andrewrichardr/MSE2202BDesignProject/README.md

# TronDesign
MSE2202B Mechatronic Design Repo
