andrewrichardr/MSE2202BDesignProject/Project/Documentation/MSE2202B Design Project-20180412T013709Z-001/MSE2202B Design Project/Concepts/Arm Attachments.docx

Suction cup option for lifting the pyramid:

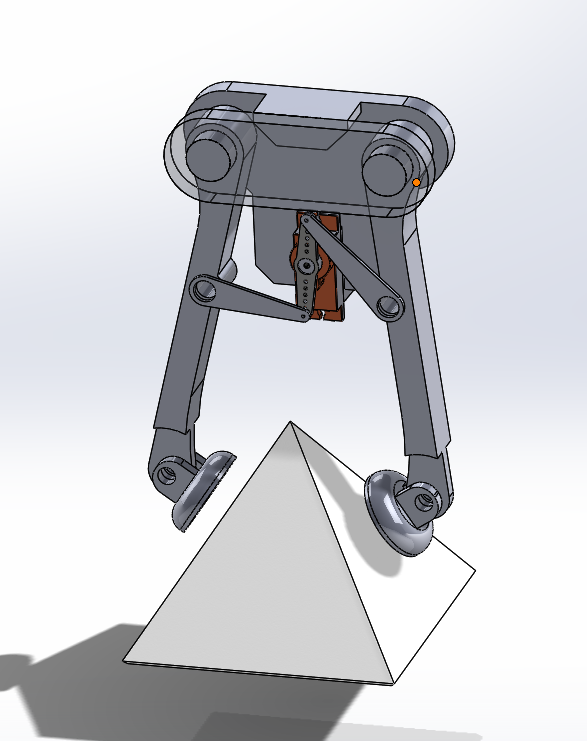
[picture p20: figure]

Geartrain for amplifying clamping force. Arm links attached to holes in output gear.

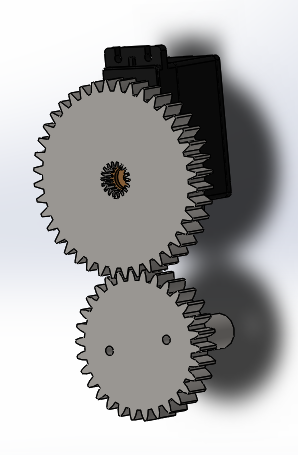
[picture p21: figure]
