andrewrichardr/MSE2202BDesignProject/Project/Documentation/MSE2202B Design Project-20180412T013709Z-001/MSE2202B Design Project/Stuff for PDF/Some Research.docx

## Objectives

- Research different types of drives and write out ones that we will consider.
- Design each drivetrain in CAD software in order efficiently see pros, cons and successfully test each of them.

## Meeting

Research: (source: Simple Robotics)

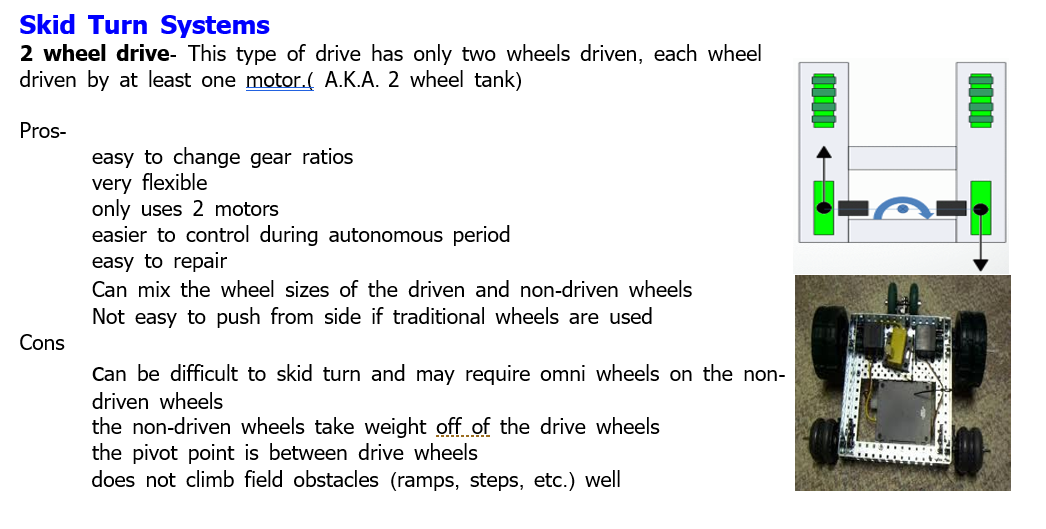
[picture p45: figure]
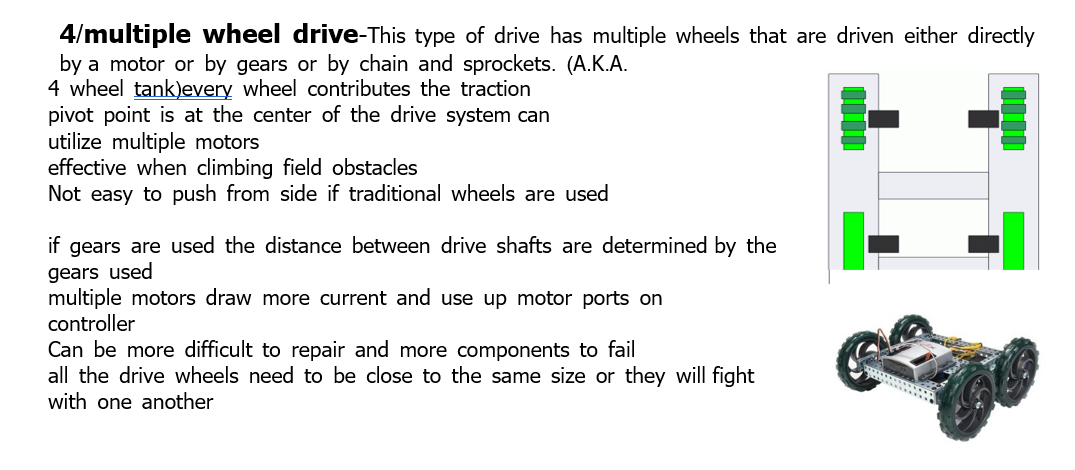
[picture p46: figure]
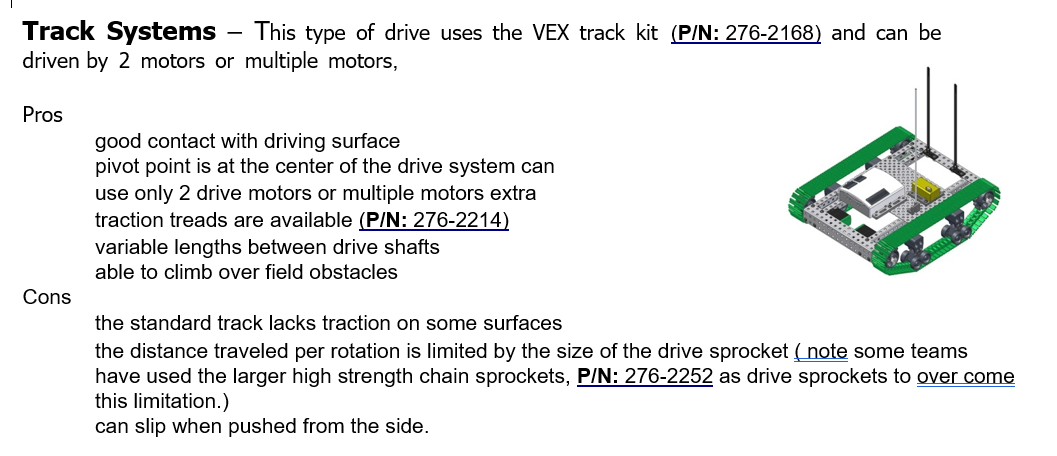
[picture p47: figure]
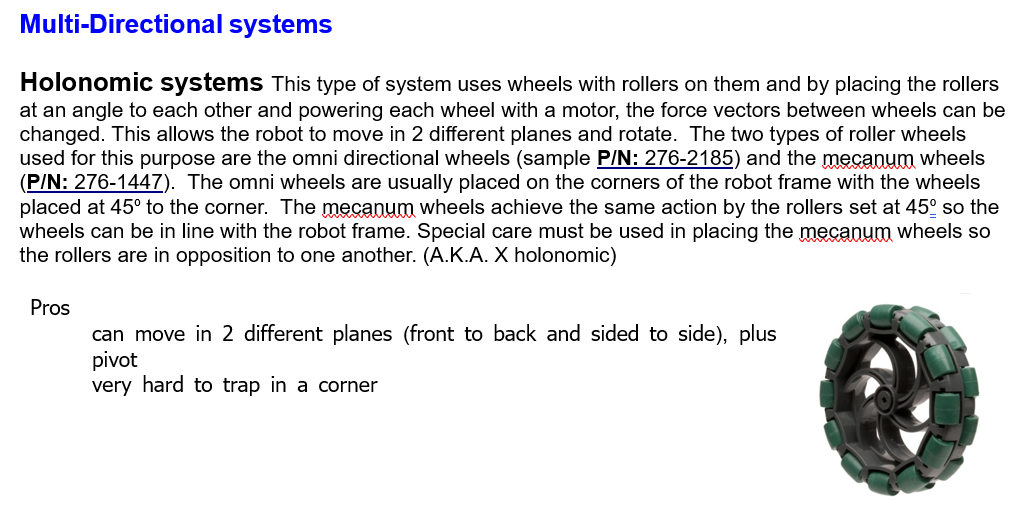
[picture p48: figure]
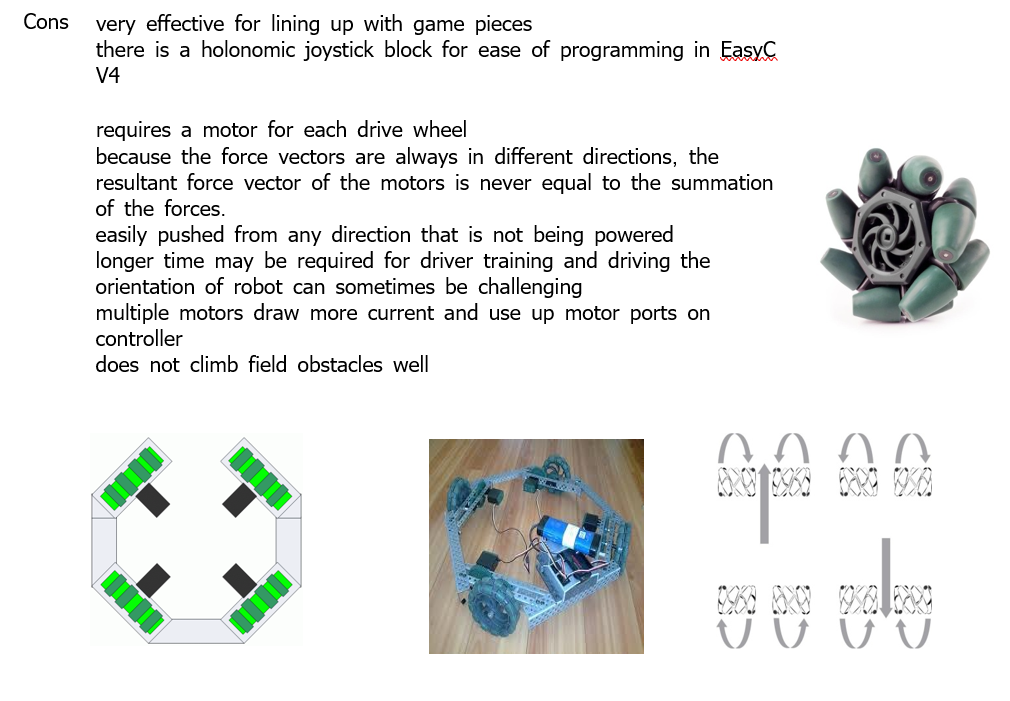
[picture p49: figure]
