andrewrichardr/MSE2202BDesignProject/Project/Documentation/MSE2202B Design Project-20180412T013709Z-001/MSE2202B Design Project/PDF/Minutes_/Meeting-Minutes5.docx

Meeting Minutes #5

Date: March 16, 2018

Agenda:

- Finalize sensors required for the product
- Select the sensors that are being used on the prototype

Discussion:

1. Sensors Required for the Product
2. Prototype Design (Sensors)

To be completed:
