andrewrichardr/MSE2202BDesignProject/Project/Documentation/MSE2202B Design Project-20180412T013709Z-001/MSE2202B Design Project/Docs/BlockDiagram.pdf

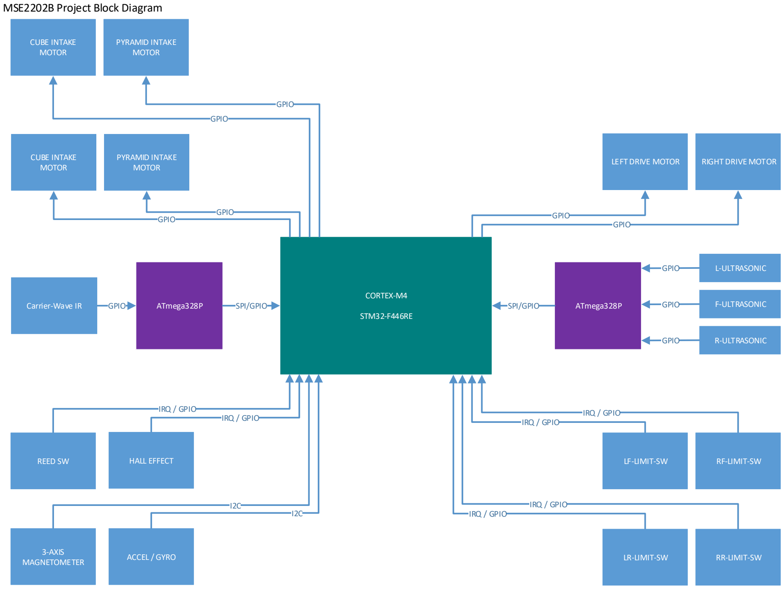
[picture p50: figure]
CORTEX-M4; STM32-F446RE; ATmega328P; L-ULTRASONIC; R-ULTRASONIC; LEFT DRIVE MOTOR; RIGHT DRIVE MOTOR; LF-LIMIT-SW; RF-LIMIT-SW; LR-LIMIT-SW; RR-LIMIT-SW; IRQ / GPIO; PYRAMID INTAKE MOTOR; CUBE INTAKE MOTOR; GPIO; Carrier-Wave IR; SPI/GPIO; REED SW; HALL EFFECT; 3-AXIS; MAGNETOMETER; ACCEL / GYRO; F-ULTRASONIC; MSE2202B Project Block Diagram
