andrewrichardr/MSE2202BDesignProject/Project/Documentation/MSE2202B Design Project-20180412T013709Z-001/MSE2202B Design Project/Stuff for PDF/BlockDiagram-Used.pdf

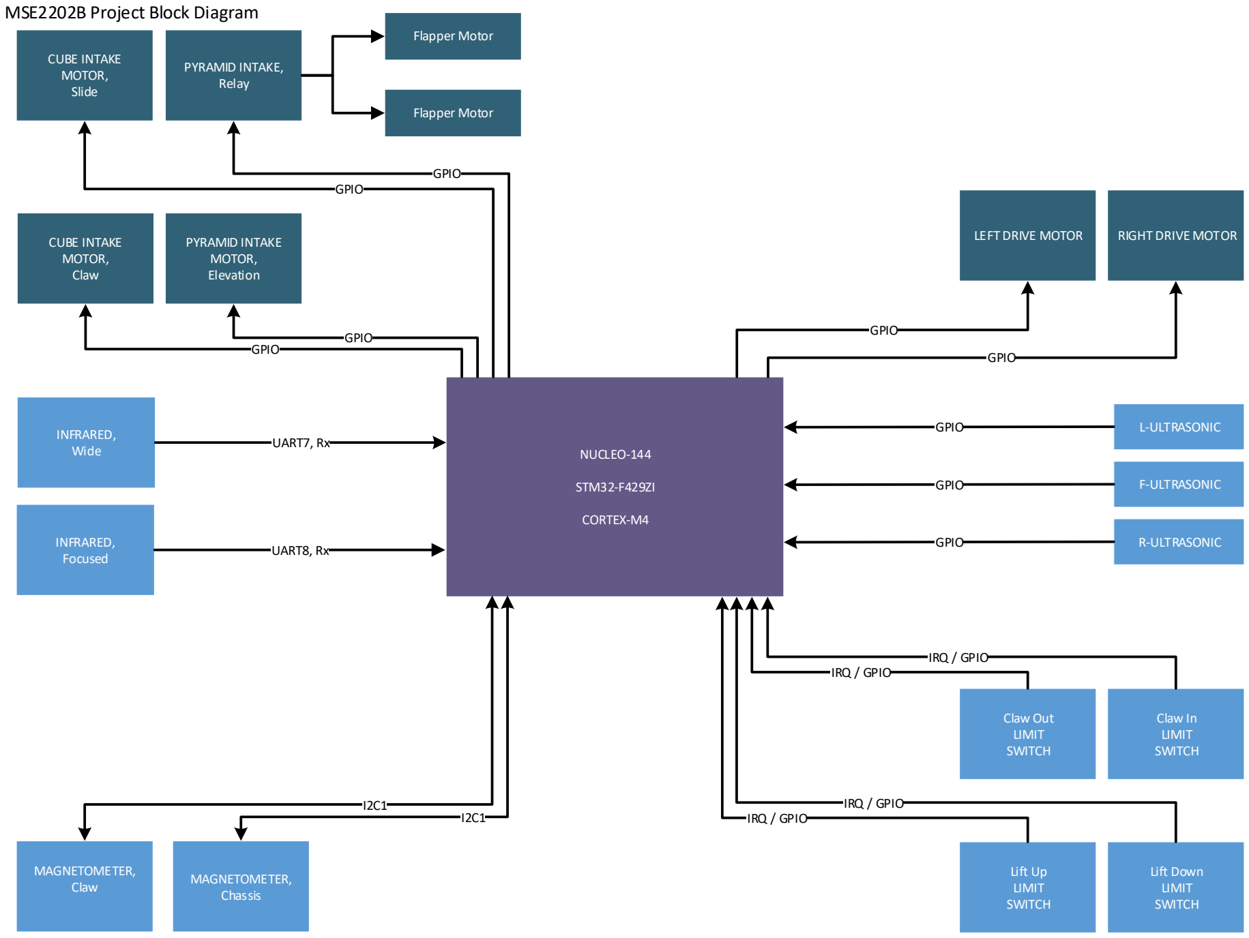
[picture p51: figure]
NUCLEO-144; STM32-F429ZI; CORTEX-M4; L-ULTRASONIC; R-ULTRASONIC; LEFT DRIVE MOTOR; RIGHT DRIVE MOTOR; Claw In LIMIT SWITCH; Claw Out LIMIT SWITCH; Lift Down LIMIT SWITCH; Lift Up LIMIT SWITCH; IRQ / GPIO; PYRAMID INTAKE MOTOR, Elevation; CUBE INTAKE MOTOR, Claw; GPIO; MAGNETOMETER,; Claw; Chassis; PYRAMID INTAKE, Relay; CUBE INTAKE MOTOR, Slide; F-ULTRASONIC; MSE2202B Project Block Diagram; INFRARED,; Focused; UART8, Rx; Wide; UART7, Rx; Flapper Motor
