andrewrichardr/MSE2202BDesignProject/Project/Documentation/MSE2202B Design Project-20180412T013709Z-001/MSE2202B Design Project/Sheets/Misc Questions to be Answered Before End of Reading Week.xlsx

Question | Approach | Who's finding the answer? | Status
How precise is pyramid hole size compared to cube? | Eugen | Maral
Angle of pyramid | Eugen | Maral
How much of our bot can be laser cut / 3d printed (within budget?) | Eugen? | Maral
How do we use suction cups with arduino? | Google
Friction coefficients with lexan? | Google
Hall effect sensors | Google
Photosensitive (IR) sensors | Google
Ultrasonic sensors | Google
Can we use outsourced motors | Naish | Lovdeep
What are the specs on the VEX sensors Naish has for us | Owl?
