andrewrichardr/MSE2202BDesignProject/Project/Documentation/MSE2202B Design Project-20180412T013709Z-001/MSE2202B Design Project/Sheets/Work Plan.xlsx

Week Of | 2018-02-15 | 2018-02-22 | 2018-03-01 | 2018-03-08 | 2018-03-15 | 2018-03-22 | 2018-03-29 | 2018-04-05 | 2018-04-11
Deliverables | Stuff to do for reading week, general direction discussion | Prelim ideas, CAD of arm concepts, research | First design review ready, tasks assigned for prototype | Work on prototype build, most parts sourced | Work on prototype build and coding | Second design review ready, prototype complete | Final parts laser cut or otherwise created | Robot complete | Report complete
