andrewrichardr/MSE2202BDesignProject/Project/Documentation/MSE2202B Design Project-20180412T013709Z-001/MSE2202B Design Project/Stuff for PDF/commits.local.tsv.xlsx

0c05f09 | andrew | Thu Apr 5 23:27:09 2018 | kjdfsgkjfsdjgksdg
f93f6d5 | andrew | Thu Apr 5 16:10:31 2018 | progress
857764f | andrew | Thu Apr 5 13:26:21 2018 | progress
9f50521 | andrew | Thu Apr 5 12:35:21 2018 | progress
1a348d5 | andrew | Thu Apr 5 11:50:04 2018 | progress
216fab5 | andrew | Thu Apr 5 11:49:30 2018 | Merge branch 'master' of https://github.com/andrewrichardr/TronDesign
f4bccac | andrew | Thu Apr 5 02:11:58 2018 | progress
cfc50ed | andrew | Wed Apr 4 14:30:25 2018 | progress
0d3759e | Andrew | Tue Apr 3 13:03:15 2018 | CAD
3305b64 | andrew | Mon Apr 2 17:50:36 2018 | Fans code: Added functions and vars for arm and lift positions, cleaned up repo
840a582 | andrew | Mon Apr 2 14:13:20 2018 | Merge branch 'master' of https://github.com/andrewrichardr/TronDesign
b902541 | andrew | Mon Apr 2 14:13:07 2018 | Block Diag Updated
aeaa023 | Andrew | Mon Apr 2 10:20:49 2018 | Merge branch 'master' of https://github.com/andrewrichardr/TronDesign
3728871 | lsingh360 | Sun Apr 1 21:19:21 2018 | should fix Solidworks opening issues
cb65c19 | lsingh360 | Sun Apr 1 14:49:28 2018 | adds new Lift and Claw CAD parts
d05d52c | Andrew | Sat Mar 31 23:35:08 2018 | Added PID controlled wall follower code to test
1bfd52b | andrew | Sat Mar 31 22:48:52 2018 | testing mods
9e09ae1 | Andrew | Thu Mar 29 01:07:22 2018 | Main Code work progressed
05e9f75 | Andrew | Wed Mar 28 22:41:58 2018 | CAD and Sensor Test Code
9ccc10d | andrew | Wed Mar 28 22:36:40 2018 | Drive Test code iterative update
47a6324 | andrew | Mon Mar 26 13:42:12 2018 | fan demo
4926e1e | Andrew | Sun Mar 25 01:08:24 2018 | FAN's code added back
f2e0bf4 | Andrew | Sun Mar 25 00:50:15 2018 | NUCLEO-32 Ultrasonic Controller Code added
6adffbe | Andrew | Sun Mar 25 00:34:29 2018 | Repo Cleanup
dd9c7f8 | fkang3 | Sat Mar 24 20:06:49 2018 | logic for putting pyramid over cube
22bdd69 | Andrew | Sat Mar 24 12:49:46 2018 | formatting
a60942a | Andrew | Sat Mar 24 12:40:13 2018 | Merge branch 'master' of https://github.com/andrewrichardr/TronDesign
e01173d | Andrew | Sat Mar 24 12:39:00 2018 | struct
fdf9130 | fkang3 | Sat Mar 24 12:33:43 2018 | small fix
8e87934 | fkang3 | Sat Mar 24 12:28:09 2018 | cube pickup..
43d4a9d | fkang3 | Sat Mar 24 12:25:13 2018 | cube pickup
d350e56 | Andrew | Sat Mar 24 12:17:16 2018 | minor changes
bfef8ef | Andrew | Fri Mar 23 18:54:39 2018 | main code\
71e2fe7 | andrew | Fri Mar 23 15:49:22 2018 | syntax error corrected
639ac36 | andrew | Fri Mar 23 15:00:53 2018 | class
57c4847 | andrew | Fri Mar 23 13:18:17 2018 | Main Robot Class added
07324b2 | Andrew | Fri Mar 23 00:27:33 2018 | Final Design CAD added and Chassis started
304d603 | fkang3 | Thu Mar 22 16:07:09 2018 | Updated with drive code
dff8c5f | andrew | Thu Mar 22 15:46:08 2018 | Merge branch 'master' of https://github.com/andrewrichardr/TronDesign
c1d5504 | fkang3 | Thu Mar 22 15:37:50 2018 | IR sensor retrieval added
1f84d18 | andrew | Thu Mar 22 14:17:35 2018 | DriveCode update
a6f86e3 | Andrew | Thu Mar 22 10:20:38 2018 | CAD render + Updates
9cd1dcf | Andrew | Tue Mar 20 23:56:27 2018 | Added 3rd party libraries for compass / accel
d74950f | andrew | Tue Mar 20 22:57:49 2018 | Test Drive code modified
0207c15 | mmohagh7 | Tue Mar 20 18:38:22 2018 | Add files via upload
faff789 | Andrew | Tue Mar 20 17:57:24 2018 | CAD
5949716 | Andrew | Tue Mar 20 17:37:09 2018 | Product CAD update
7d2c52a | Andrew | Tue Mar 20 09:43:07 2018 | Uarts enabled
dc8d5e6 | Andrew | Mon Mar 19 20:22:15 2018 | Enabled all UARTx with included boards.txt
6609dd8 | Andrew | Mon Mar 19 20:06:47 2018 | Modified variant.h to enable UART3
2d82495 | Andrew | Sun Mar 18 15:38:58 2018 | 1
ec16b9c | Andrew | Sun Mar 18 14:04:36 2018 | File Structuring, Ultrasonic Code added for MSE-Duino-B, Main Code Development Started
3544eda | Andrew | Sun Mar 18 12:56:30 2018 | Added IRQ line for the IR sensor
31448a2 | fkang3 | Sat Mar 17 15:25:08 2018 | Code to read IR input
78a09e6 | fkang3 | Sat Mar 17 14:48:52 2018 | Add files via upload
3d7c69c | Andrew | Sat Mar 17 14:44:37 2018 | Pinmuxing required block diagram changes
8e79c3d | Andrew | Sat Mar 17 13:09:51 2018 | Admin
7fa76d8 | Andrew | Sat Mar 17 01:50:39 2018 | Cleanup
733d68c | Andrew | Fri Mar 16 20:24:56 2018 | Block Diagram Update
eb39081 | Andrew | Fri Mar 16 19:35:25 2018 | Block Diagram Added
6d4fc08 | Andrew | Fri Mar 16 12:32:47 2018 | Merge branch 'master' of https://github.com/andrewrichardr/TronDesign
ab83e83 | Andrew | Fri Mar 16 12:30:51 2018 | Chassis Gearing Iteration
d95d19b | andrew | Thu Mar 15 18:22:55 2018 | Ultrasonic test code added for driving parallel to the wall
046dda7 | andrew | Thu Mar 15 12:02:36 2018 | Test Drive Code modified
ac6df45 | Andrew | Thu Mar 15 11:59:04 2018 | Rev 1.0 Prototype Sch Added
efe1597 | Andrew | Thu Mar 15 11:00:08 2018 | Fan's Docs
591568c | Andrew | Thu Mar 15 10:52:00 2018 | Repo Cleanup, Added Eagle Sch for Vex Devices
56cacb4 | Andrew | Wed Mar 14 14:08:44 2018 | Fan's Code
55ce476 | andrew | Wed Mar 14 12:17:00 2018 | Test Drive Code Added
3cde660 | Andrew | Wed Mar 14 11:06:07 2018 | SOLIDWORKS Init
791a107 | andrew | Wed Mar 14 10:35:40 2018 | update
3ed689f | Andrew | Sat Mar 3 16:50:37 2018 | Benchmark Added
a45c01a | Andrew | Thu Feb 15 13:39:38 2018 | Racing Edition
adb65db | Andrew | Thu Feb 8 16:35:11 2018 | Alan Cheated on Beatrice
318eaaa | Andrew | Wed Feb 7 14:04:48 2018 | Alan hates Ruizhi
229bb08 | Andrew | Wed Feb 7 11:13:18 2018 | Alan is Anal
9e90c48 | Andrew | Thu Feb 1 16:31:07 2018 | Beatrice got fat
f2845de | Andrew | Thu Feb 1 14:30:47 2018 | Streamlined
caa858e | Andrew | Wed Jan 31 15:03:12 2018 | Alan is not in prison
20cc8ad | Andrew | Mon Jan 29 20:36:24 2018 | Added STM32 Guide
273dc48 | Andrew | Mon Jan 29 14:00:57 2018 | Modular turning functions added
dd12a08 | Andrew | Fri Jan 26 19:20:46 2018 | Line following logic functional for a basic loop
d606713 | Andrew | Thu Jan 25 21:20:09 2018 | House cleaning
addaa07 | Andrew | Thu Jan 25 20:03:55 2018 | Formatting
dd7a5ba | Andrew | Thu Jan 25 19:36:07 2018 | Naive approach to lab 3 added
3c3f26a | Andrew | Mon Jan 22 23:01:56 2018 | I2CEncoder Lib added, Will compile with Sublime
fd3d9a4 | Andrew | Mon Jan 22 22:31:14 2018 | Lab03 Added
8e4abf5 | Andrew | Sat Jan 20 16:41:09 2018 | 1
dc6e66a | Andrew | Fri Jan 19 18:16:41 2018 | All submitted and accepted
b8a7dca | Andrew | Fri Jan 19 16:06:47 2018 | they all work elegently now
8bdfeb6 | andrewrichardr | Thu Jan 18 12:27:15 2018 | Lab02
ad1be89 | andrewrichardr | Thu Jan 18 11:42:25 2018 | Initial commit
