andrewrichardr/MSE2202BDesignProject/Project/Documentation/MSE2202B Design Project-20180412T013709Z-001/MSE2202B Design Project/Stuff for PDF/Decision-Matrix-Pyramid.xlsx

Decision Matrix - Pyramid Retrieval Mechanisms |  |  |  |  |  |  |  | Options
 | Reliability | Size | Complexity | Speed | Cost | Total | Relative Weight | Claw | Roller Intake | Arm Intake
Reliability | 1 | 3 | 4 | 3 | 4 | 15 | 0.4390243902 | -1 | 0 | 1
Size | 0.3333333333 | 1 | 2 | 1 | 2 | 6.333333333 | 0.1853658537 | 1 | 0 | 1
Complexity | 0.25 | 0.5 | 1 | 0.5 | 1 | 3.25 | 0.09512195122 | 1 | 0 | 0
Speed | 0.3333333333 | 1 | 2 | 1 | 2 | 6.333333333 | 0.1853658537 | 0 | 0 | 0
Cost | 0.25 | 0.5 | 1 | 0.5 | 1 | 3.25 | 0.09512195122 | 1 | 0 | 0
Total |  |  |  |  |  | 34.16666667 | 1 | -0.06341463415 | 0 | 0.6243902439
