andrewrichardr/MSE2202BDesignProject/Project/Documentation/MSE2202B Design Project-20180412T013709Z-001/MSE2202B Design Project/Stuff for PDF/QFD-Extended.xlsx

Sheet: Customer Requirements
 |  |  |  | Competitive Analysis (0=Worst, 5=Best)
Row Number | Demanded Quality (a.k.a. "Customer Requirements" or "Whats") | Weight / Importance | Relative Weight | Our Current Product | Competitor 1 | Competitor 2 | Competitor 3 | Competitor 4 | Competitor 5
1 | Fast | 4 | 13.33
2 | Reliable | 5 | 16.67
3 | Inexpensive | 2 | 6.67
4 | Easy to maintain | 2 | 6.67
5 | Easy to set up | 3 | 10.00
6 | Aesthetically pleasing | 1 | 3.33
7 | Fuel efficient | 2 | 6.67
8 | Clean operations | 5 | 16.67
9 | Reasonably sized | 4 | 13.33
10 | Incorporate latest technology | 2 | 6.67
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
