andrewrichardr/MSE2202BDesignProject/Project/CAD/Final Design CAD/nema-23-stepper-motor-shaft-d8-length-41-115mm-1.snapshot.2/1.JPG

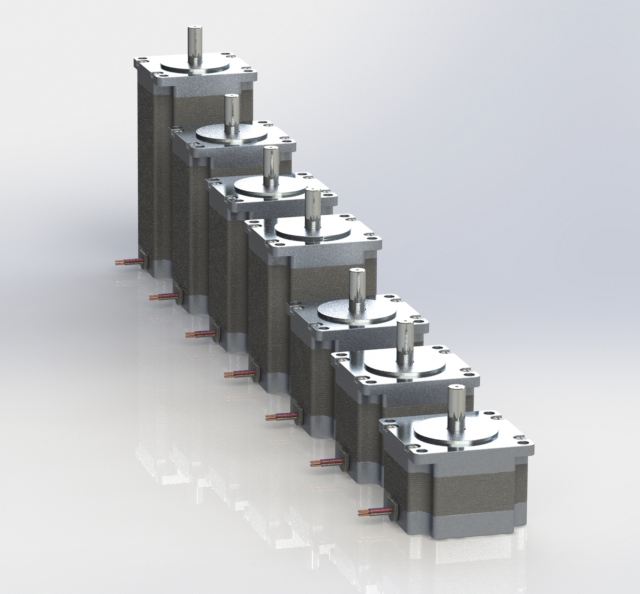
Project/CAD/Final Design CAD/nema-23-stepper-motor-shaft-d8-length-41-115mm-1.snapshot.2/1.JPG
