andrewrichardr/MSE2202BDesignProject/Project/Documentation/MSE2202B Design Project-20180412T013709Z-001/MSE2202B Design Project/Designs/ARM - LIFT/Chain Bar.png

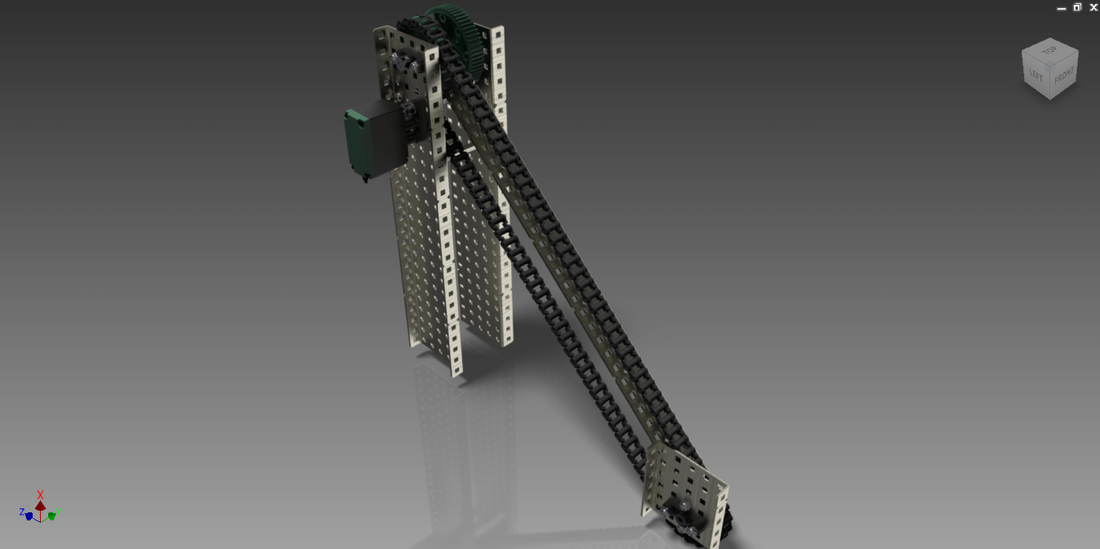
Project/Documentation/MSE2202B Design Project-20180412T013709Z-001/MSE2202B Design Project/Designs/ARM - LIFT/Chain Bar.png
