andrewrichardr/MSE2202BDesignProject/Project/Documentation/MSE2202B Design Project-20180412T013709Z-001/MSE2202B Design Project/Game Piece Photos/IMG_20180223_152649.jpg

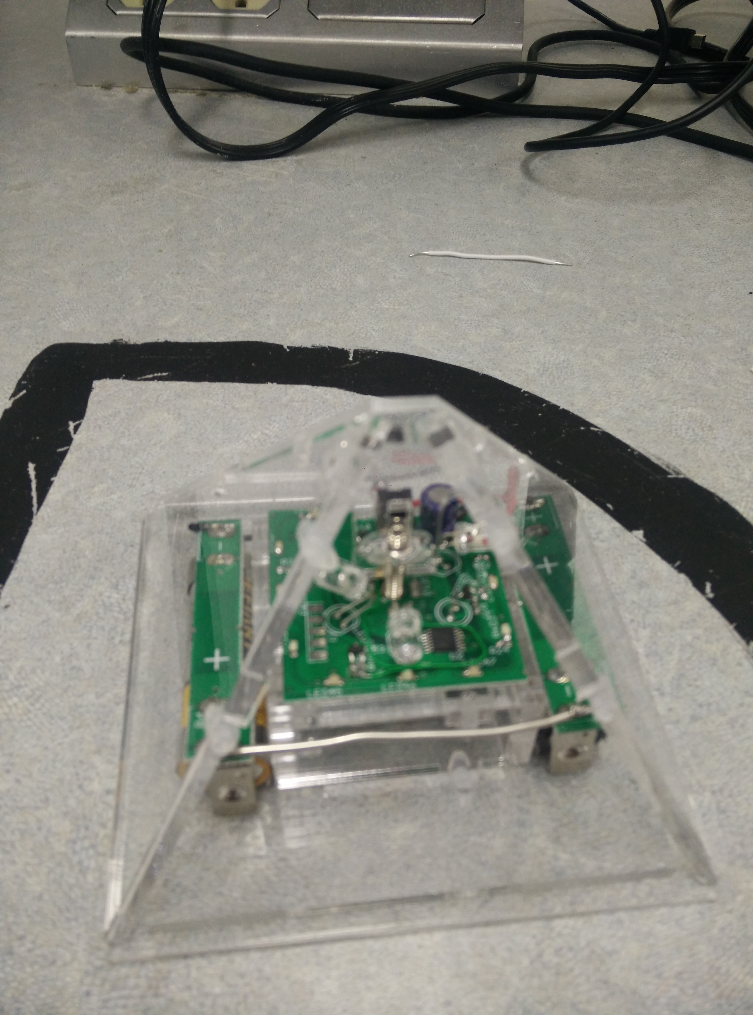
Project/Documentation/MSE2202B Design Project-20180412T013709Z-001/MSE2202B Design Project/Game Piece Photos/IMG_20180223_152649.jpg
