andrewrichardr/MSE2202BDesignProject/Project/CAD/Prototype Assy/BOM.xlsx

ITEM NO. | PART NUMBER | DESCRIPTION | QTY.
1 | BaseUC |  | 4
2 | BEAM-3000 |  | 10
3 | BEARING-FLAT |  | 14
4 | VEX-MEDIUM-WHEEL |  | 4
5 | SHAFT-4000 |  | 14
6 | VEX-2WIRE-MOTOR |  | 6
7 | sprocket-hs-06-tooth |  | 4
8 | sprocket-hs-18-tooth |  | 4
9 | chain-hs-link |  | 110
10 | VL-RAIL-21-25 RevA |  | 2
11 | BEAM-2000 |  | 4
12 | 276-1926-002 Rev1 |  | 1
13 | 276-1926-004 Rev1 |  | 3
14 | 276-1926-005 Rev1 |  | 2
15 | BEAM-1500 |  | 2
16 | Claw-Bracket |  | 1
17 | CLAW_L |  | 2
18 | CLAW_R |  | 2
19 | VEX-MOTOR |  | 1
20 | magmount |  | 1
21 | VL-CHAN-121-15 RevA |  | 2
22 | VEX-12-TOOTH-GEAR |  | 1
23 | VEX-36-TOOTH-GEAR |  | 1
24 | VEX-60-TOOTH-GEAR |  | 1
25 | back |  | 1
26 | BottomForklift |  | 1
27 | Circles 5.5in Inch Shaft Bar |  | 4
28 | Circles 3.5 inch Linkage |  | 1
29 | top |  | 1
30 | VL-RACK-BRK RevA |  | 2
31 | INTAKE-ROLLER |  | 4
32 | Circles 3.5 inch Linkage-o |  | 1
33 | ramp |  | 1
34 | Ultrasonic_Range_Fin der_276-2155 |  | 3
