andrewrichardr/MSE2202BDesignProject/Project/CAD/Final Design CAD/BOM.xlsx

Ball Bearing | https://www.mcmaster.com/#60355k503/=1c37crc
1/4 Shaft | https://www.mcmaster.com/#1327k113/=1c37i08
10 tooth sprocket | https://www.mcmaster.com/#2737t2/=1c37l45
20 tooth sprocket | https://www.mcmaster.com/#2737t131/=1c37mwj
Roller chain | https://www.mcmaster.com/#6261k171/=1c37p04
