andrewrichardr/MSE2202BDesignProject/Project/Documentation/MSE2202B Design Project-20180412T013709Z-001/MSE2202B Design Project/Sheets/Part Sourcing.xlsx

Part Category | Chosen? | Part | Part Manufacturer | Currently on hand | Source | Source SKU | Value | Price Paid | CAD/USD | Specs:
Main Controller | 1x | STM32 F429ZI | ST Microelectronics | yes | ST Sales rep | 497-16280-ND | $25.00 | $0.00 | USD | ARM®32-bit Cortex®-M4 CPU with FPU, 180 MHz
 | 0x | STM32 F446RE | ST Microelectronics | yes | ST Sales rep |  | 15 | 0 |  | ARM®32-bit Cortex®-M4 CPU with FPU, 180 MHz
 | 0x | Arduino Mega 2560 | Atmel | yes |  |  | 20 |  |  | 16 MHz
Secondary Controller? | 0x | MSE Duino | Atmel | yes |  |  |  |  |  | 16 MHz
Drive Motors | 5x | Vex Integrated Encoder | ...
Stepper Motors | 0x | Stepper | Adafruit Industries LLC | no | Digikey | 1528-1062-ND | 14 | 14 | USD | 1.645"x1.645", 330mA, 12V, 1.8deg stepper, Driver needed
Servo Motors | 1x | Vex Servo | ...
Magnetic Sensors | 0x | STEVAL-MKI181V1 | ST Microelectronics | in transit | ST Sales rep |  | ? | 0
 | 1x | LSM303 | Adafruit Industries LLC | yes | Digikey | 1528-1173-ND | 20.53 | 20.53 | CAD
 | 0x | MAG3110 | Sparkfun | yes | Digikey | 1568-1030-ND | 20.53 | 20.53 | cad
Photosensitive Sensors | 2x | The IR one they give us |  | yes | naish |  | 0 | 0
Ultrasonic Sensors | 3x | The VEX one they give us |  | yes | naish |  | 0 | 0
Arduino WiFi shield | 0x | EXP8266 |  | no | sparkfun | WRL-13678 |  | 7
Misc Hardware | ... | 1.5" Standoffs |  | no
Suction Cup | 0x |  |  | no |  |  | 10
Suction Cpu Vaccum Pump | 0x |  |  | no |  |  | 3
Sensor Moduled | 0x |  |  |  |  | 1528-1173-ND | 15 |  | USD
