andrewrichardr/MSE2202BDesignProject/Project/Documentation/MSE2202B Design Project-20180412T013709Z-001/MSE2202B Design Project/Stuff for PDF/Product BOM.xlsx

ITEM NO. | PART NUMBER | DESCRIPTION | QTY. | Drawing
1 | ChassisSidePlate | Wheel/Motor Mount | 2 | YES
2 | 6627T54 | Wheel Drive Stepper | 2 | YES
3 | 60355K503 | Ball Bearing | 4 | YES
4 | 1327K113 | Steel Shaft | 4 | YES
5 | 2737T131 | Wheel Sprocket | 4 | YES
6 | 6261K281 | Roller Chain Link | 78 | YES
7 | 2737T2 | Motor Sprocket | 2 | YES
15 | 60355K509 | Ball Bearing | 1 | YES
18 | 93410A912 | Threaded Rod | 1 | YES
19 | 95120A592 | Flange Nuts | 2 | YES
24 | 60355K504 | Ball Bearing | 1 | YES
29 | 6627T37 | Claw Clamp Motor | 1 | YES
30 | 57545K511_SPEED- REDUCING WORM GEAR FOR 90 DEG TRANSFER | Worm Gear | 1 | YES
31 | 57545K527_SPEED- REDUCING WORM GEAR FOR 90 DEG TRANSFER | Worm Gear | 2 | YES
33 | 6627T38 | Lift Motor, Arm Rotation Motor, Linear Slide Motor | 3 | YES
40 | 2709K12 | Roller Motors | 2 | YES
43 | 57545K511_SPEED- REDUCING WORM GEAR FOR 90 DEG TRANSFER-cutoff | Worm Gear, Cut | 1 | YES
8 | Wheel_Bushing |  | 4 | YES
9 | CasterWheel_5in.ipt |  | 4
10 | ChassisSideCover |  | 2 | YES
11 | SideSensorEntension |  | 2 | YES
12 | SideSensorMount |  | 2 | YES
13 | ChassisMotorHousing |  | 1 | YES
14 | ClawArmBearingMoun t |  | 1 | YES
16 | ArmRotate |  | 1 | YES
17 | RackStand |  | 2 | YES
20 | Rail |  | 4
22 | ClawWormCoupler |  | 1 | YES
23 | ClawRailMotorBracket |  | 1 | YES
25 | ClawBracket |  | 1 | YES
26 | ClawMount |  | 1 | YES
27 | CLAW_L |  | 2 | YES
28 | CLAW_R |  | 2 | YES
32 | RotationBushing |  | 2 | YES
34 | CubeArmMountBracke t |  | 2 | YES
35 | LiftLinkageBaseMount |  | 4 | YES
36 | PyrIntakeAngledMount |  | 1 | YES
37 | PyrIntakeBacking |  | 1 | YES
38 | PyrIntakeForks |  | 1 | YES
39 | LiftLinkage |  | 4 | YES
41 | PyrIntakeMotorMount |  | 1 | YES
42 | PyrIntakeRoller |  | 2 | ...
44 | PyrIntakeLinkageRod |  | 1 | YES
