andrewrichardr/MSE2202BDesignProject/Project/Documentation/MSE2202B Design Project-20180412T013709Z-001/MSE2202B Design Project/Stuff for PDF/PROTOTYPE BOM.xlsx

ITEM NO. | PART NUMBER | DESCRIPTION | QTY.
1 | VL-CHAN-121-25 RevA | Chassis Structure | 4
2 | BEAM-3000 | 3" Standoff | 10
3 | BEARING-FLAT | Shaft Bearing | 14
4 | VEX-MEDIUM-WHEEL | 4" Wheel | 4
5 | SHAFT-4000 | 4" Shaft | 14
6 | VEX-2WIRE-MOTOR | VEX DC Motor | 6
7 | sprocket-hs-06-tooth | 6 tooth roller chain sprocket | 4
8 | sprocket-hs-18-tooth | 18 tooth roller chain sprocket | 4
9 | chain-hs-link | Roller Chain Link | 110
10 | VL-RAIL-21-25 RevA | Liner Slide Rail | 2
11 | BEAM-2000 | 2" Standoff | 4
12 | 276-1926-002 Rev1 | Liner Slide Hardware | 1
13 | 276-1926-004 Rev1 | Liner Slide Hardware | 3
14 | 276-1926-005 Rev1 | Liner Slide Hardware | 2
15 | BEAM-1500 | 1.5" Standoff | 2
16 | Claw-Bracket | Bracket for claw | 1
17 | CLAW_L | Left Claw | 2
18 | CLAW_R | Right Claw | 2
19 | VEX-MOTOR | Vex Servo | 1
20 | magmount | mount for LSM303 | 1
21 | VL-CHAN-121-15 RevA | Structure | 2
22 | VEX-12-TOOTH-GEAR | 12 tooth gear | 1
23 | VEX-36-TOOTH-GEAR | 36 tooth gear | 1
24 | VEX-60-TOOTH-GEAR | 60 tooth gear | 1
25 | backForkLift | back of pyr intake | 1
26 | BottomForklift | bottom of pyr intake | 1
27 | Circles 5.5in Inch Shaft Bar | pyr linkage | 4
28 | Circles 3.5 inch Linkage | pyr linkage | 1
29 | topForkLift | top of pyr intake | 1
30 | VL-RACK-BRK RevA | Liner Slide Hardware | 2
31 | INTAKE-ROLLER | Pyr Hardware | 4
32 | Circles 3.5 inch Linkage-o | pyr linkage | 1
33 | rampCube | slide for cube | 1
34 | Ultrasonic_Range_Finder_276-2155 | ultrasonic sensor | 3
35 | IR | IR Sensors | 2
36 | STM32F429ZI | Cortex M4 MCU | 1
37 | Daughter Board for MCU | Connect sensors and motors to MCU | 1
38 | Elastic Bands | stress relif of pyr intake | 4
39 | Limit Switches |  | 3
40 | Misc Hardware | Nuts and Bolts | ...
