andrewrichardr/MSE2202BDesignProject/Project/Documentation/MSE2202B Design Project-20180412T013709Z-001/MSE2202B Design Project/Sheets/STM32 Pinmux.xlsx

Sheet: F446RE
 |  | Colour Legend
 |  | Daughter Board Low Power |  |  | GROUND | I/O
 |  | Daughter Board High Power |  |  | POWER | OTHER |  |  |  | Alternate Functions
Position | Name | STM Headers | Arduino UNO Header | Type | Attached Device | I/O Structure | Voltage Tolerance | Signal | Label | AF0 | AF1 | AF2 | AF3 | AF4 | AF5 | AF6 | AF7 | AF8 | AF9 | AF10 | AF11 | AF12 | AF13 | ADC | DAC
2 | PC13 | CN7-1-12 |  | I/O |  | FT | 5 V | GPIO_EXTI13 | B1 [Blue PushButton]
3 | PC14 | CN7-1-13 |  | I/O |  | FT | 5 V | RCC_OSC32_IN
4 | PC15 | CN7-1-14 |  | I/O |  | FT | 5 V | RCC_OSC32_OUT
5 | PH0 | CN7-1-15 |  | I/O |  | FT | 5 V | RCC_OSC_IN
6 | PH1 | CN7-1-16 |  | I/O |  | FT | 5 V | RCC_OSC_OUT
7 | NRST | CN7-2-7 | Reset | Reset
8 | PC0 | CN7-2-19 | A5 | I/O | LR_ULTRA_OUT | FT | 5 V |  |  |  |  |  |  |  |  | SAI1_MCLK_B |  |  |  | USB_OTG_HS_ULPI_STP |  |  |  | ADC123_IN10
9 | PC1 | CN7-2-18 | A4 | I/O | LR_ULTRA_IN | FT | 5 V |  |  |  |  |  |  |  | I2S3_SD/SPI3_MOSI | SAI1_SD_A | I2S2_SD/SPI2_MOSI |  |  |  |  |  |  | ADC123_IN11
10 | PC2 | CN7-1-18 |  | I/O |  | FT | 5 V |  |  |  |  |  |  |  | SPI2_MISO |  |  |  |  | USB_OTG_HS_ULPI_DIR |  |  |  | ADC123_IN12
11 | PC3 | CN7-1-19 |  | I/O |  | FT | 5 V |  |  |  |  |  |  |  | I2S2_SD/SPI2_MOSI |  |  |  |  | USB_OTG_HS_ULPI_NXT |  |  |  | ADC123_IN13
14 | PA0 | CN7-2-14 | A0 | I/O | F_ULTRA_IN | FT | 5 V |  |  |  | TIM2_CH1/TIM2_ETR | TIM5_CH1 | TIM8_ETR |  |  |  | USART2_CTS | UART4_TX |  |  |  |  |  | ADC123_IN0
15 | PA1 | CN7-2-15 | A1 | I/O | F_ULTRA_OUT | FT | 5 V |  |  |  | TIM2_CH2 | TIM5_CH2 |  |  |  |  | USART2_RTS | UART4_RX | QUADSPI_BK1_IO3 |  |  |  |  | ADC123_IN1
16 | PA2 | CN10-1-18 | D1 | I/O | Default Serial | FT | 5 V | USART2_TX | USART_TX |  | TIM2_CH3 | TIM5_CH3 | TIM9_CH1 |  |  |  | USART2_TX |  |  |  |  |  |  | ADC123_IN2
17 | PA3 | CN10-1-19 | D0 | I/O | Default Serial | FT | 5 V | USART2_RX | USART_RX |  | TIM2_CH4 | TIM5_CH4 | TIM9_CH2 |  |  | SAI1_FS_A | USART2_RX |  |  | USB_OTG_HS_ULPI_D0 |  |  |  | ADC123_IN3
20 | PA4 | CN7-2-16 | A2 | I/O | LF_ULTRA_IN | TC |  |  |  |  |  |  |  |  | I2S1_WS/SPI1_NSS | I2S3_WS/SPI3_NSS | USART2_CK |  |  |  |  | USB_OTG_HS_SOF | DCMI_HSYNC | ADC12_IN4 | DAC_OUT1
21 | PA5 | CN10-1-6 | D13 | Output | PYR INTAKE MOTOR | TC |  | GPIO_Output | LD2 [Green Led] |  | TIM2_CH1/TIM2_ETR |  | TIM8_CH1N |  | I2S1_CK/SPI1_SCK |  |  |  |  | USB_OTG_HS_ULPI_CK |  |  |  | ADC12_IN5 | DAC_OUT2
22 | PA6 | CN10-1-7 | D12 | I/O | LIFT MOTOR | FT | 5 V |  |  |  | TIM1_BKIN | TIM3_CH1 | TIM8_BKIN |  | SPI1_MISO | I2S2_MCK |  |  | TIM13_CH1 |  |  |  | DCMI_PIXCLK | ADC12_IN6
23 | PA7 | CN10-1-8 | D11 | I/O | DRIVE MOTOR RIGHT | FT | 5 V |  |  |  | TIM1_CH1N | TIM3_CH2 | TIM8_CH1N |  | I2S1_SD/SPI1_MOSI |  |  |  | TIM14_CH1 |  |  |  |  | ADC12_IN7
24 | PC4 | CN10-2-17 |  | I/O |  | FT | 5 V |  |  |  |  |  |  |  | I2S1_MCK |  |  | SPDIFRX_IN2 |  |  |  |  |  | ADC12_IN14
25 | PC5 | CN10-2-3 |  | I/O |  | FT | 5 V |  |  |  |  |  |  |  |  |  | USART3_RX | SPDIFRX_IN3 |  |  |  |  |  | ADC12_IN15
26 | PB0 | CN7-2-17 | A3 | I/O | LF_ULTRA_OUT | FT | 5 V |  |  |  | TIM1_CH2N | TIM3_CH3 | TIM8_CH2N |  |  |  | I2S3_SD/SPI3_MOSI | UART4_CTS |  | USB_OTG_HS_ULPI_D1 |  | SDIO_D1 |  | ADC12_IN8
27 | PB1 | CN10-2-12 |  | I/O | LIMIT_SW_2 LIFT DOWN | FT | 5 V |  |  |  | TIM1_CH3N | TIM3_CH4 | TIM8_CH3N |  |  |  |  |  |  | USB_OTG_HS_ULPI_D2 |  | SDIO_D2 |  | ADC12_IN9
28 | PB2 | CN10-2-11 |  | I/O | LIMIT_SW_1 LIFT UP | FT | 5 V |  |  |  | TIM2_CH4 |  |  |  |  | SAI1_SD_A | I2S3_SD/SPI3_MOSI |  | QUADSPI_CLK | USB_OTG_HS_ULPI_D4 |  | SDIO_CK
29 | PB10 | CN10-1-13 | D6 | I/O | UART3, RX IR SHROUDED REAR | FT | 5 V |  |  |  | TIM2_CH3 |  |  | I2C2_SCL | I2S2_CK/SPI2_SCK | SAI1_SCK_A | USART3_TX |  |  | USB_OTG_HS_ULPI_D3
33 | PB12 | CN10-2-8 |  | I/O |  | FT | 5 V |  |  |  | TIM1_BKIN |  |  | I2C2_SMBA | I2S2_WS/SPI2_NSS | SAI1_SCK_B | USART3_CK |  | CAN2_RX | USB_OTG_HS_ULPI_D5 |  | USB_OTG_HS_ID
34 | PB13 | CN10-2-15 |  | I/O |  | FT | 5 V |  |  |  | TIM1_CH1N |  |  |  | I2S2_CK/SPI2_SCK |  | USART3_CTS |  | CAN2_TX | USB_OTG_HS_ULPI_D6
35 | PB14 | CN10-2-14 |  | I/O |  | FT | 5 V |  |  |  | TIM1_CH2N |  | TIM8_CH2N |  | SPI2_MISO |  | USART3_RTS |  | TIM12_CH1 |  |  | USB_OTG_HS_DM
36 | PB15 | CN10-2-13 |  | I/O | LIMIT_SW_3 CHECK PYR | FT | 5 V |  |  | RTC_REFIN | TIM1_CH3N |  | TIM8_CH3N |  | I2S2_SD/SPI2_MOSI |  |  |  | TIM12_CH2 |  |  | USB_OTG_HS_DP
37 | PC6 | CN10-2-2 |  | I/O |  | FTf | 5 V |  |  |  |  | TIM3_CH1 | TIM8_CH1 | FMPI2C1_SCL | I2S2_MCK |  |  | USART6_TX |  |  |  | SDIO_D6 | DCMI_D0
38 | PC7 | CN10-1-10 | D9 | I/O |  | FTf | 5 V |  |  |  |  | TIM3_CH2 | TIM8_CH2 | FMPI2C1_SDA | I2S2_CK/SPI2_SCK | I2S3_MCK | SPDIFRX_IN1 | USART6_RX |  |  |  | SDIO_D7 | DCMI_D1
39 | PC8 | CN10-2-1 |  | I/O |  | FT | 5 V |  |  | SYS_TRACED0 |  | TIM3_CH3 | TIM8_CH3 |  |  |  | UART5_RTS | USART6_CK |  |  |  | SDIO_D0 | DCMI_D2
40 | PC9 | CN10-1-1 |  | I/O |  | FT | 5 V |  |  | RCC_MCO_2 |  | TIM3_CH4 | TIM8_CH4 | I2C3_SDA | I2S_CKIN |  | UART5_CTS |  | QUADSPI_BK1_IO0 |  |  | SDIO_D1 | DCMI_D3
41 | PA8 | CN10-1-12 | D7 | I/O |  | FT | 5 V |  |  | RCC_MCO_1 | TIM1_CH1 |  |  | I2C3_SCL |  |  | USART1_CK |  |  | USB_OTG_FS_SOF
42 | PA9 | CN10-1-11 | D8 | I/O | CLAW SLIDE SERVO | FT | 5 V |  |  |  | TIM1_CH2 |  |  | I2C3_SMBA | I2S2_CK/SPI2_SCK | SAI1_SD_B | USART1_TX |  |  |  |  |  | DCMI_D0
43 | PA10 | CN10-1-17 | D2 | I/O | UART1, RX IR UNSHROUDED FRONT | FT | 5 V |  |  |  | TIM1_CH3 |  |  |  |  |  | USART1_RX |  |  | USB_OTG_FS_ID |  |  | DCMI_D1
44 | PA11 | CN10-2-7 |  | I/O |  | FT | 5 V |  |  |  | TIM1_CH4 |  |  |  |  |  | USART1_CTS |  | CAN1_RX | USB_OTG_FS_DM
45 | PA12 | CN10-2-6 |  | I/O |  | FT | 5 V |  |  |  | TIM1_ETR |  |  |  |  |  | USART1_RTS |  | CAN1_TX | USB_OTG_FS_DP
46 | PA13 | CN7-1-7 |  | I/O |  | FT | 5 V | SYS_JTMS-SWDIO | TMS | SYS_JTMS-SWDIO
49 | PA14 | CN7-1-8 |  | I/O |  | FT | 5 V | SYS_JTCK-SWCLK | TCK | SYS_JTCK-SWCLK
50 | PA15 | CN7-1-9 |  | I/O |  | FT | 5 V |  |  | SYS_JTDI | TIM2_CH1/TIM2_ETR |  |  | CEC | I2S1_WS/SPI1_NSS | I2S3_WS/SPI3_NSS |  | UART4_RTS
51 | PC10 | CN7-1-1 |  | I/O |  | FT | 5 V |  |  |  |  |  |  |  |  | I2S3_CK/SPI3_SCK | USART3_TX | UART4_TX | QUADSPI_BK1_IO1 |  |  | SDIO_D2 | DCMI_D8
52 | PC11 | CN7-2-1 |  | I/O |  | FT | 5 V |  |  |  |  |  |  |  |  | SPI3_MISO | USART3_RX | UART4_RX | QUADSPI_BK2_NCS |  |  | SDIO_D3 | DCMI_D4
53 | PC12 | CN7-1-2 |  | I/O |  | FT | 5 V |  |  |  |  |  |  | I2C2_SDA |  | I2S3_SD/SPI3_MOSI | USART3_CK | UART5_TX |  |  |  | SDIO_CK | DCMI_D9
54 | PD2 | CN7-2-2 |  | I/O |  | FT | 5 V |  |  |  |  | TIM3_ETR |  |  |  |  |  | UART5_RX |  |  |  | SDIO_CMD | DCMI_D11
55 | PB3 | CN10-1-16 | D3 | I/O | CLAW GRIP SERVO | FT | 5 V | SYS_JTDO-SWO | SWO | SYS_JTDO-SWO | TIM2_CH2 |  |  | I2C2_SDA | I2S1_CK/SPI1_SCK | I2S3_CK/SPI3_SCK
56 | PB4 | CN10-1-14 | D5 | I/O |  | FT | 5 V |  |  | SYS_JTRST |  | TIM3_CH1 |  | I2C3_SDA | SPI1_MISO | SPI3_MISO | I2S2_WS/SPI2_NSS
57 | PB5 | CN10-1-15 | D4 | I/O |  | FT | 5 V |  |  |  |  | TIM3_CH2 |  | I2C1_SMBA | I2S1_SD/SPI1_MOSI | I2S3_SD/SPI3_MOSI |  |  | CAN2_RX | USB_OTG_HS_ULPI_D7 |  |  | DCMI_D10
58 | PB6 | CN10-1-9 | D10 | I/O | DRIVE MOTOR LEFT | FT | 5 V |  |  |  |  | TIM4_CH1 | CEC | I2C1_SCL |  |  | USART1_TX |  | CAN2_TX | QUADSPI_BK1_NCS |  |  | DCMI_D5
59 | PB7 | CN7-1-11 |  | I/O |  | FT | 5 V |  |  |  |  | TIM4_CH2 |  | I2C1_SDA |  |  | USART1_RX | SPDIFRX_IN0 |  |  |  |  | DCMI_VSYNC
60 | BOOT0 | CN7-1-4 |  | Boot |  | B
61 | PB8 | CN10-1-2 | D15 | I/O | I2C1 | FT | 5 V |  |  |  | TIM2_CH1/TIM2_ETR | TIM4_CH3 | TIM10_CH1 | I2C1_SCL |  |  |  |  | CAN1_RX |  |  | SDIO_D4 | DCMI_D6
62 | PB9 | CN10-1-3 | D14 | I/O | I2C1 | FT | 5 V |  |  |  | TIM2_CH2 | TIM4_CH4 | TIM11_CH1 | I2C1_SDA | I2S2_WS/SPI2_NSS | SAI1_FS_B |  |  | CAN1_TX |  |  | SDIO_D5 | DCMI_D7

Sheet: Sheet4
GROUND | I/O
POWER | OTHER
Attached Dev | CN7 |  | Attached Dev | Attached Dev | CN10 |  | Attached Dev
 | CN7-1-1 | CN7-2-1 |  |  | CN10-1-1 | CN10-2-1
 | CN7-1-2 | CN7-2-2 |  | I2C1 | CN10-1-2 | CN10-2-2
 | CN7-1-3 | CN7-2-3 |  | I2C1 | CN10-1-3 | CN10-2-3
 | CN7-1-4 | CN7-2-4 |  | #N/A | CN10-1-4 | CN10-2-4
 | CN7-1-5 | CN7-2-5 |  |  | CN10-1-5 | CN10-2-5
 | CN7-1-6 | CN7-2-6 |  | PYR INTAKE MOTOR | CN10-1-6 | CN10-2-6
 | CN7-1-7 | CN7-2-7 |  | LIFT MOTOR | CN10-1-7 | CN10-2-7
 | CN7-1-8 | CN7-2-8 |  | DRIVE MOTOR RIGHT | CN10-1-8 | CN10-2-8
 | CN7-1-9 | CN7-2-9 |  | DRIVE MOTOR LEFT | CN10-1-9 | CN10-2-9
 | CN7-1-10 | CN7-2-10 |  |  | CN10-1-10 | CN10-2-10
 | CN7-1-11 | CN7-2-11 |  | CLAW SLIDE SERVO | CN10-1-11 | CN10-2-11 | LIMIT_SW_1 LIFT UP
 | CN7-1-12 | CN7-2-12 |  |  | CN10-1-12 | CN10-2-12 | LIMIT_SW_2 LIFT DOWN
 | CN7-1-13 | CN7-2-13 |  | UART3, RX IR SHROUDED REAR | CN10-1-13 | CN10-2-13 | LIMIT_SW_3 CHECK PYR
 | CN7-1-14 | CN7-2-14 | F_ULTRA_IN |  | CN10-1-14 | CN10-2-14
 | CN7-1-15 | CN7-2-15 | F_ULTRA_OUT |  | CN10-1-15 | CN10-2-15
 | CN7-1-16 | CN7-2-16 | LF_ULTRA_IN | CLAW GRIP SERVO | CN10-1-16 | CN10-2-16
#N/A | CN7-1-17 | CN7-2-17 | LF_ULTRA_OUT | UART1, RX IR UNSHROUDED FRONT | CN10-1-17 | CN10-2-17
 | CN7-1-18 | CN7-2-18 | LR_ULTRA_IN | Default Serial | CN10-1-18 | CN10-2-18
 | CN7-1-19 | CN7-2-19 | LR_ULTRA_OUT | Default Serial | CN10-1-19 | CN10-2-19

Sheet: F429ZI
Position | Name | Type | I/O Structure | Arduino Header | Attached Device | Voltage Tolerence | Signal | Label | AF0 | AF1 | AF2 | AF3 | AF4 | AF5 | AF6 | AF7 | AF8 | AF9 | AF10 | AF11 | AF12 | AF13 | AF14
43 | PA7 | I/O | FT |  |  | 5 V | ETH_CRS_DV | RMII_CRS_DV [LAN8742A-CZ-TR_CRS_DV] |  | TIM1_CH1N | TIM3_CH2 | TIM8_CH1N |  | SPI1_MOSI |  |  |  | TIM14_CH1 |  | ETH_CRS_DV/ETH_RX_DV
27 | PC1 | I/O | FT |  |  | 5 V | ETH_MDC | RMII_MDC [LAN8742A-CZ-TR_MDC] |  |  |  |  |  |  |  |  |  |  |  | ETH_MDC
36 | PA2 | I/O | FT |  |  | 5 V | ETH_MDIO | RMII_MDIO [LAN8742A-CZ-TR_MDIO] |  | TIM2_CH3 | TIM5_CH3 | TIM9_CH1 |  |  |  | USART2_TX |  |  |  | ETH_MDIO
35 | PA1 | I/O | FT |  |  | 5 V | ETH_REF_CLK | RMII_REF_CLK [LAN8742A-CZ-TR_REFCLK0] |  | TIM2_CH2 | TIM5_CH2 |  |  |  |  | USART2_RTS | UART4_RX |  |  | ETH_REF_CLK/ETH_RX_CLK
44 | PC4 | I/O | FT |  |  | 5 V | ETH_RXD0 | RMII_RXD0 [LAN8742A-CZ-TR_RXD0] |  |  |  |  |  |  |  |  |  |  |  | ETH_RXD0
45 | PC5 | I/O | FT |  |  | 5 V | ETH_RXD1 | RMII_RXD1 [LAN8742A-CZ-TR_RXD1] |  |  |  |  |  |  |  |  |  |  |  | ETH_RXD1
126 | PG11 | I/O | FT |  |  | 5 V | ETH_TX_EN | RMII_TX_EN [LAN8742A-CZ-TR_TXEN] |  |  |  |  |  |  |  |  |  |  |  | ETH_TX_EN | FMC_NCE4_2 | DCMI_D3 | LTDC_B3
128 | PG13 | I/O | FT |  |  | 5 V | ETH_TXD0 | RMII_TXD0 [LAN8742A-CZ-TR_TXD0] |  |  |  |  |  | SPI6_SCK |  |  | USART6_CTS |  |  | ETH_TXD0 | FMC_A24
74 | PB13 | I/O | FT |  |  | 5 V | ETH_TXD1 | RMII_TXD1 [LAN8742A-CZ-TR_TXD1] |  | TIM1_CH1N |  |  |  | I2S2_CK/SPI2_SCK |  | USART3_CTS |  | CAN2_TX | USB_OTG_HS_ULPI_D6 | ETH_TXD1
7 | PC13 | I/O | FT |  |  | 5 V | GPIO_EXTI13 | USER_Btn [B1]
92 | PG7 | Input | FT |  |  | 5 V | GPIO_Input | USB_OverCurrent [STMPS2151STR_FAULT] |  |  |  |  |  |  |  |  | USART6_CK |  |  |  | FMC_INT3 | DCMI_D13 | LTDC_CLK
137 | PB7 | Output | FT |  |  | 5 V | GPIO_Output | LD2 [Blue] |  |  | TIM4_CH2 |  | I2C1_SDA |  |  | USART1_RX |  |  |  |  | FMC_NL | DCMI_VSYNC
75 | PB14 | Output | FT |  |  | 5 V | GPIO_Output | LD3 [Red] |  | TIM1_CH2N |  | TIM8_CH2N |  | SPI2_MISO | I2S2_ext_SD | USART3_RTS |  | TIM12_CH1 |  |  | USB_OTG_HS_DM
91 | PG6 | Output | FT |  |  | 5 V | GPIO_Output | USB_PowerSwitchOn [STMPS2151STR_EN] |  |  |  |  |  |  |  |  |  |  |  |  | FMC_INT2 | DCMI_D12 | LTDC_R7
23 | PH0/OSC_IN | I/O | FT |  |  | 5 V | RCC_OSC_IN | MCO [STM32F103CBT6_PA8]
24 | PH1/OSC_OUT | I/O | FT |  |  | 5 V | RCC_OSC_OUT
8 | PC14 | I/O | FT |  |  | 5 V | RCC_OSC32_IN
9 | PC15 | I/O | FT |  |  | 5 V | RCC_OSC32_OUT
109 | PA14 | I/O | FT |  |  | 5 V | SYS_JTCK-SWCLK | TCK | SYS_JTCK-SWCLK
105 | PA13 | I/O | FT |  |  | 5 V | SYS_JTMS-SWDIO | TMS | SYS_JTMS-SWDIO
78 | PD9 | I/O | FT |  |  | 5 V | USART3_RX | STLK_TX [STM32F103CBT6_PA2] |  |  |  |  |  |  |  | USART3_RX |  |  |  |  | FMC_D14/FMC_DA14
77 | PD8 | I/O | FT |  |  | 5 V | USART3_TX | STLK_RX [STM32F103CBT6_PA3] |  |  |  |  |  |  |  | USART3_TX |  |  |  |  | FMC_D13/FMC_DA13
103 | PA11 | I/O | FT |  |  | 5 V | USB_OTG_FS_DM | USB_DM |  | TIM1_CH4 |  |  |  |  |  | USART1_CTS |  | CAN1_RX | USB_OTG_FS_DM |  |  |  | LTDC_R4
104 | PA12 | I/O | FT |  |  | 5 V | USB_OTG_FS_DP | USB_DP |  | TIM1_ETR |  |  |  |  |  | USART1_RTS |  | CAN1_TX | USB_OTG_FS_DP |  |  |  | LTDC_R5
102 | PA10 | I/O | FT |  |  | 5 V | USB_OTG_FS_ID | USB_ID |  | TIM1_CH3 |  |  |  |  |  | USART1_RX |  |  | USB_OTG_FS_ID |  |  | DCMI_D1
100 | PA8 | I/O | FT |  |  | 5 V | USB_OTG_FS_SOF | USB_SOF [TP1] | RCC_MCO_1 | TIM1_CH1 |  |  | I2C3_SCL |  |  | USART1_CK |  |  | USB_OTG_FS_SOF |  |  |  | LTDC_R6
101 | PA9 | I/O | FT |  |  | 5 V | USB_OTG_FS_VBUS | USB_VBUS |  | TIM1_CH2 |  |  | I2C3_SMBA |  |  | USART1_TX |  |  |  |  |  | DCMI_D0
112 | PC11 | I/O | FT |  |  | 5 V |  |  |  |  |  |  |  | I2S3_ext_SD | SPI3_MISO | USART3_RX | UART4_RX |  |  |  | SDIO_D3 | DCMI_D4
34 | PA0/WKUP | I/O | FT |  |  | 5 V |  |  |  | TIM2_CH1/TIM2_ETR | TIM5_CH1 | TIM8_ETR |  |  |  | USART2_CTS | UART4_TX |  |  | ETH_CRS
111 | PC10 | I/O | FT |  |  | 5 V |  |  |  |  |  |  |  |  | I2S3_CK/SPI3_SCK | USART3_TX | UART4_TX |  |  |  | SDIO_D2 | DCMI_D8 | LTDC_R2
116 | PD2 | I/O | FT |  |  | 5 V |  |  |  |  | TIM3_ETR |  |  |  |  |  | UART5_RX |  |  |  | SDIO_CMD | DCMI_D11
113 | PC12 | I/O | FT |  |  | 5 V |  |  |  |  |  |  |  |  | I2S3_SD/SPI3_MOSI | USART3_CK | UART5_TX |  |  |  | SDIO_CK | DCMI_D9
18 | PF6 | I/O | FT |  |  | 5 V |  |  |  |  |  | TIM10_CH1 |  | SPI5_NSS | SAI1_SD_B |  | UART7_RX |  |  |  | FMC_NIORD
58 | PE7 | I/O | FT |  |  | 5 V |  |  |  | TIM1_ETR |  |  |  |  |  |  | UART7_RX |  |  |  | FMC_D4/FMC_DA4
19 | PF7 | I/O | FT |  |  | 5 V |  |  |  |  |  | TIM11_CH1 |  | SPI5_SCK | SAI1_MCLK_B |  | UART7_TX |  |  |  | FMC_NREG
59 | PE8 | I/O | FT |  |  | 5 V |  |  |  | TIM1_CH1N |  |  |  |  |  |  | UART7_TX |  |  |  | FMC_D5/FMC_DA5
141 | PE0 | I/O | FT |  |  | 5 V |  |  |  |  | TIM4_ETR |  |  |  |  |  | UART8_RX |  |  |  | FMC_NBL0 | DCMI_D2
142 | PE1 | I/O | FT |  |  | 5 V |  |  |  |  |  |  |  |  |  |  | UART8_TX |  |  |  | FMC_NBL1 | DCMI_D3
98 | PC8 | I/O | FT |  |  | 5 V |  |  |  |  | TIM3_CH3 | TIM8_CH3 |  |  |  |  | USART6_CK |  |  |  | SDIO_D0 | DCMI_D2
132 | PG15 | I/O | FT |  |  | 5 V |  |  |  |  |  |  |  |  |  |  | USART6_CTS |  |  |  | FMC_SDNCAS | DCMI_D13
93 | PG8 | I/O | FT |  |  | 5 V |  |  |  |  |  |  |  | SPI6_NSS |  |  | USART6_RTS |  |  | ETH_PPS_OUT | FMC_SDCLK
127 | PG12 | I/O | FT |  |  | 5 V |  |  |  |  |  |  |  | SPI6_MISO |  |  | USART6_RTS | LTDC_B4 |  |  | FMC_NE4 |  | LTDC_B1
97 | PC7 | I/O | FT |  |  | 5 V |  |  |  |  | TIM3_CH2 | TIM8_CH2 |  |  | I2S3_MCK |  | USART6_RX |  |  |  | SDIO_D7 | DCMI_D1 | LTDC_G6
124 | PG9 | I/O | FT |  |  | 5 V |  |  |  |  |  |  |  |  |  |  | USART6_RX |  |  |  | FMC_NCE3/FMC_NE2 | DCMI_VSYNC
96 | PC6 | I/O | FT |  |  | 5 V |  |  |  |  | TIM3_CH1 | TIM8_CH1 |  | I2S2_MCK |  |  | USART6_TX |  |  |  | SDIO_D6 | DCMI_D0 | LTDC_HSYNC
129 | PG14 | I/O | FT |  |  | 5 V |  |  |  |  |  |  |  | SPI6_MOSI |  |  | USART6_TX |  |  | ETH_TXD1 | FMC_A25
134 | PB4 | I/O | FT |  |  | 5 V |  |  | SYS_JTRST |  | TIM3_CH1 |  |  | SPI1_MISO | SPI3_MISO | I2S3_ext_SD
136 | PB6 | I/O | FT |  |  | 5 V |  |  |  |  | TIM4_CH1 |  | I2C1_SCL |  |  | USART1_TX |  | CAN2_TX |  |  | FMC_SDNE1 | DCMI_D5
40 | PA4 | I/O | TTa |  |  |  |  |  |  |  |  |  |  | SPI1_NSS | I2S3_WS/SPI3_NSS | USART2_CK |  |  |  |  | USB_OTG_HS_SOF | DCMI_HSYNC | LTDC_VSYNC
123 | PD7 | I/O | FT |  |  | 5 V |  |  |  |  |  |  |  |  |  | USART2_CK |  |  |  |  | FMC_NCE2/FMC_NE1
117 | PD3 | I/O | FT |  |  | 5 V |  |  |  |  |  |  |  | I2S2_CK/SPI2_SCK |  | USART2_CTS |  |  |  |  | FMC_CLK | DCMI_D5 | LTDC_G7
118 | PD4 | I/O | FT |  |  | 5 V |  |  |  |  |  |  |  |  |  | USART2_RTS |  |  |  |  | FMC_NOE
37 | PA3 | I/O | FT |  |  | 5 V |  |  |  | TIM2_CH4 | TIM5_CH4 | TIM9_CH2 |  |  |  | USART2_RX |  |  | USB_OTG_HS_ULPI_D0 | ETH_COL |  |  | LTDC_B5
122 | PD6 | I/O | FT |  |  | 5 V |  |  |  |  |  |  |  | I2S3_SD/SPI3_MOSI | SAI1_SD_A | USART2_RX |  |  |  |  | FMC_NWAIT | DCMI_D10 | LTDC_B2
119 | PD5 | I/O | FT |  |  | 5 V |  |  |  |  |  |  |  |  |  | USART2_TX |  |  |  |  | FMC_NWE
73 | PB12 | I/O | FT |  |  | 5 V |  |  |  | TIM1_BKIN |  |  | I2C2_SMBA | I2S2_WS/SPI2_NSS |  | USART3_CK |  | CAN2_RX | USB_OTG_HS_ULPI_D5 | ETH_TXD0 | USB_OTG_HS_ID
79 | PD10 | I/O | FT |  |  | 5 V |  |  |  |  |  |  |  |  |  | USART3_CK |  |  |  |  | FMC_D15/FMC_DA15 |  | LTDC_B3
80 | PD11 | I/O | FT |  |  | 5 V |  |  |  |  |  |  |  |  |  | USART3_CTS |  |  |  |  | FMC_A16/FMC_CLE
81 | PD12 | I/O | FT |  |  | 5 V |  |  |  |  | TIM4_CH1 |  |  |  |  | USART3_RTS |  |  |  |  | FMC_A17/FMC_ALE
70 | PB11 | I/O | FT |  |  | 5 V |  |  |  | TIM2_CH4 |  |  | I2C2_SDA |  |  | USART3_RX |  |  | USB_OTG_HS_ULPI_D4 | ETH_TX_EN |  |  | LTDC_G5
69 | PB10 | I/O | FT |  |  | 5 V |  |  |  | TIM2_CH3 |  |  | I2C2_SCL | I2S2_CK/SPI2_SCK |  | USART3_TX |  |  | USB_OTG_HS_ULPI_D3 | ETH_RX_ER |  |  | LTDC_G4
1 | PE2 | I/O | FT |  |  | 5 V |  |  | SYS_TRACECLK |  |  |  |  | SPI4_SCK | SAI1_MCLK_A |  |  |  |  | ETH_TXD3 | FMC_A23
2 | PE3 | I/O | FT |  |  | 5 V |  |  | SYS_TRACED0 |  |  |  |  |  | SAI1_SD_B |  |  |  |  |  | FMC_A19
3 | PE4 | I/O | FT |  |  | 5 V |  |  | SYS_TRACED1 |  |  |  |  | SPI4_NSS | SAI1_FS_A |  |  |  |  |  | FMC_A20 | DCMI_D4 | LTDC_B0
4 | PE5 | I/O | FT |  |  | 5 V |  |  | SYS_TRACED2 |  |  | TIM9_CH1 |  | SPI4_MISO | SAI1_SCK_A |  |  |  |  |  | FMC_A21 | DCMI_D6 | LTDC_G0
5 | PE6 | I/O | FT |  |  | 5 V |  |  | SYS_TRACED3 |  |  | TIM9_CH2 |  | SPI4_MOSI | SAI1_SD_A |  |  |  |  |  | FMC_A22 | DCMI_D7 | LTDC_G1
6 | VBAT | Power
10 | PF0 | I/O | FT |  |  | 5 V |  |  |  |  |  |  | I2C2_SDA |  |  |  |  |  |  |  | FMC_A0
11 | PF1 | I/O | FT |  |  | 5 V |  |  |  |  |  |  | I2C2_SCL |  |  |  |  |  |  |  | FMC_A1
12 | PF2 | I/O | FT |  |  | 5 V |  |  |  |  |  |  | I2C2_SMBA |  |  |  |  |  |  |  | FMC_A2
13 | PF3 | I/O | FT |  |  | 5 V |  |  |  |  |  |  |  |  |  |  |  |  |  |  | FMC_A3
14 | PF4 | I/O | FT |  |  | 5 V |  |  |  |  |  |  |  |  |  |  |  |  |  |  | FMC_A4
15 | PF5 | I/O | FT |  |  | 5 V |  |  |  |  |  |  |  |  |  |  |  |  |  |  | FMC_A5
16 | VSS | Power
17 | VDD | Power
20 | PF8 | I/O | FT |  |  | 5 V |  |  |  |  |  |  |  | SPI5_MISO | SAI1_SCK_B |  |  | TIM13_CH1 |  |  | FMC_NIOWR
21 | PF9 | I/O | FT |  |  | 5 V |  |  |  |  |  |  |  | SPI5_MOSI | SAI1_FS_B |  |  | TIM14_CH1 |  |  | FMC_CD
22 | PF10 | I/O | FT |  |  | 5 V |  |  |  |  |  |  |  |  |  |  |  |  |  |  | FMC_INTR | DCMI_D11 | LTDC_DE
25 | NRST | Reset
26 | PC0 | I/O | FT |  |  | 5 V |  |  |  |  |  |  |  |  |  |  |  |  | USB_OTG_HS_ULPI_STP |  | FMC_SDNWE
28 | PC2 | I/O | FT |  |  | 5 V |  |  |  |  |  |  |  | SPI2_MISO | I2S2_ext_SD |  |  |  | USB_OTG_HS_ULPI_DIR | ETH_TXD2 | FMC_SDNE0
29 | PC3 | I/O | FT |  |  | 5 V |  |  |  |  |  |  |  | I2S2_SD/SPI2_MOSI |  |  |  |  | USB_OTG_HS_ULPI_NXT | ETH_TX_CLK | FMC_SDCKE0
30 | VDD | Power
31 | VSSA | Power
32 | VREF+ | Power
33 | VDDA | Power
38 | VSS | Power
39 | VDD | Power
41 | PA5 | I/O | TTa |  |  |  |  |  |  | TIM2_CH1/TIM2_ETR |  | TIM8_CH1N |  | SPI1_SCK |  |  |  |  | USB_OTG_HS_ULPI_CK
42 | PA6 | I/O | FT |  |  | 5 V |  |  |  | TIM1_BKIN | TIM3_CH1 | TIM8_BKIN |  | SPI1_MISO |  |  |  | TIM13_CH1 |  |  |  | DCMI_PIXCK | LTDC_G2
46 | PB0 | I/O | FT |  |  | 5 V |  |  |  | TIM1_CH2N | TIM3_CH3 | TIM8_CH2N |  |  |  |  |  | LTDC_R3 | USB_OTG_HS_ULPI_D1 | ETH_RXD2
47 | PB1 | I/O | FT |  |  | 5 V |  |  |  | TIM1_CH3N | TIM3_CH4 | TIM8_CH3N |  |  |  |  |  | LTDC_R6 | USB_OTG_HS_ULPI_D2 | ETH_RXD3
48 | PB2/BOOT1 | I/O | FT |  |  | 5 V
49 | PF11 | I/O | FT |  |  | 5 V |  |  |  |  |  |  |  | SPI5_MOSI |  |  |  |  |  |  | FMC_SDNRAS | DCMI_D12
50 | PF12 | I/O | FT |  |  | 5 V |  |  |  |  |  |  |  |  |  |  |  |  |  |  | FMC_A6
51 | VSS | Power
52 | VDD | Power
53 | PF13 | I/O | FT |  |  | 5 V |  |  |  |  |  |  |  |  |  |  |  |  |  |  | FMC_A7
54 | PF14 | I/O | FT |  |  | 5 V |  |  |  |  |  |  |  |  |  |  |  |  |  |  | FMC_A8
55 | PF15 | I/O | FT |  |  | 5 V |  |  |  |  |  |  |  |  |  |  |  |  |  |  | FMC_A9
56 | PG0 | I/O | FT |  |  | 5 V |  |  |  |  |  |  |  |  |  |  |  |  |  |  | FMC_A10
57 | PG1 | I/O | FT |  |  | 5 V |  |  |  |  |  |  |  |  |  |  |  |  |  |  | FMC_A11
60 | PE9 | I/O | FT |  |  | 5 V |  |  |  | TIM1_CH1 |  |  |  |  |  |  |  |  |  |  | FMC_D6/FMC_DA6
61 | VSS | Power
62 | VDD | Power
63 | PE10 | I/O | FT |  |  | 5 V |  |  |  | TIM1_CH2N |  |  |  |  |  |  |  |  |  |  | FMC_D7/FMC_DA7
64 | PE11 | I/O | FT |  |  | 5 V |  |  |  | TIM1_CH2 |  |  |  | SPI4_NSS |  |  |  |  |  |  | FMC_D8/FMC_DA8 |  | LTDC_G3
65 | PE12 | I/O | FT |  |  | 5 V |  |  |  | TIM1_CH3N |  |  |  | SPI4_SCK |  |  |  |  |  |  | FMC_D9/FMC_DA9 |  | LTDC_B4
66 | PE13 | I/O | FT |  |  | 5 V |  |  |  | TIM1_CH3 |  |  |  | SPI4_MISO |  |  |  |  |  |  | FMC_D10/FMC_DA10 |  | LTDC_DE
67 | PE14 | I/O | FT |  |  | 5 V |  |  |  | TIM1_CH4 |  |  |  | SPI4_MOSI |  |  |  |  |  |  | FMC_D11/FMC_DA11 |  | LTDC_CLK
68 | PE15 | I/O | FT |  |  | 5 V |  |  |  | TIM1_BKIN |  |  |  |  |  |  |  |  |  |  | FMC_D12/FMC_DA12 |  | LTDC_R7
71 | VCAP_1 | Power
72 | VDD | Power
76 | PB15 | I/O | FT |  |  | 5 V |  |  | RTC_REFIN | TIM1_CH3N |  | TIM8_CH3N |  | I2S2_SD/SPI2_MOSI |  |  |  | TIM12_CH2 |  |  | USB_OTG_HS_DP
82 | PD13 | I/O | FT |  |  | 5 V |  |  |  |  | TIM4_CH2 |  |  |  |  |  |  |  |  |  | FMC_A18
83 | VSS | Power
84 | VDD | Power
85 | PD14 | I/O | FT |  |  | 5 V |  |  |  |  | TIM4_CH3 |  |  |  |  |  |  |  |  |  | FMC_D0/FMC_DA0
86 | PD15 | I/O | FT |  |  | 5 V |  |  |  |  | TIM4_CH4 |  |  |  |  |  |  |  |  |  | FMC_D1/FMC_DA1
87 | PG2 | I/O | FT |  |  | 5 V |  |  |  |  |  |  |  |  |  |  |  |  |  |  | FMC_A12
88 | PG3 | I/O | FT |  |  | 5 V |  |  |  |  |  |  |  |  |  |  |  |  |  |  | FMC_A13
89 | PG4 | I/O | FT |  |  | 5 V |  |  |  |  |  |  |  |  |  |  |  |  |  |  | FMC_A14/FMC_BA0
90 | PG5 | I/O | FT |  |  | 5 V |  |  |  |  |  |  |  |  |  |  |  |  |  |  | FMC_A15/FMC_BA1
94 | VSS | Power
95 | VDD | Power
99 | PC9 | I/O | FT |  |  | 5 V |  |  | RCC_MCO_2 |  | TIM3_CH4 | TIM8_CH4 | I2C3_SDA | I2S_CKIN |  |  |  |  |  |  | SDIO_D1 | DCMI_D3
106 | VCAP_2 | Power
107 | VSS | Power
108 | VDD | Power
110 | PA15 | I/O | FT |  |  | 5 V |  |  | SYS_JTDI | TIM2_CH1/TIM2_ETR |  |  |  | SPI1_NSS | I2S3_WS/SPI3_NSS
114 | PD0 | I/O | FT |  |  | 5 V |  |  |  |  |  |  |  |  |  |  |  | CAN1_RX |  |  | FMC_D2/FMC_DA2
115 | PD1 | I/O | FT |  |  | 5 V |  |  |  |  |  |  |  |  |  |  |  | CAN1_TX |  |  | FMC_D3/FMC_DA3
120 | VSS | Power
121 | VDD | Power
125 | PG10 | I/O | FT |  |  | 5 V |  |  |  |  |  |  |  |  |  |  |  | LTDC_G3 |  |  | FMC_NCE4_1/FMC_NE3 | DCMI_D2 | LTDC_B2
130 | VSS | Power
131 | VDD | Power
133 | PB3 | I/O | FT |  |  | 5 V |  |  | SYS_JTDO-SWO | TIM2_CH2 |  |  |  | SPI1_SCK | I2S3_CK/SPI3_SCK
135 | PB5 | I/O | FT |  |  | 5 V |  |  |  |  | TIM3_CH2 |  | I2C1_SMBA | SPI1_MOSI | I2S3_SD/SPI3_MOSI |  |  | CAN2_RX | USB_OTG_HS_ULPI_D7 | ETH_PPS_OUT | FMC_SDCKE1 | DCMI_D10
138 | BOOT0 | Boot
139 | PB8 | I/O | FT |  |  | 5 V |  |  |  |  | TIM4_CH3 | TIM10_CH1 | I2C1_SCL |  |  |  |  | CAN1_RX |  | ETH_TXD3 | SDIO_D4 | DCMI_D6 | LTDC_B6
140 | PB9 | I/O | FT |  |  | 5 V |  |  |  |  | TIM4_CH4 | TIM11_CH1 | I2C1_SDA | I2S2_WS/SPI2_NSS |  |  |  | CAN1_TX |  |  | SDIO_D5 | DCMI_D7 | LTDC_B7
143 | PDR_ON | Reset
144 | VDD | Power
