andrewrichardr/MSE2202BDesignProject/Project/CAD/Final Design CAD/ChassisAcc.SLDASM

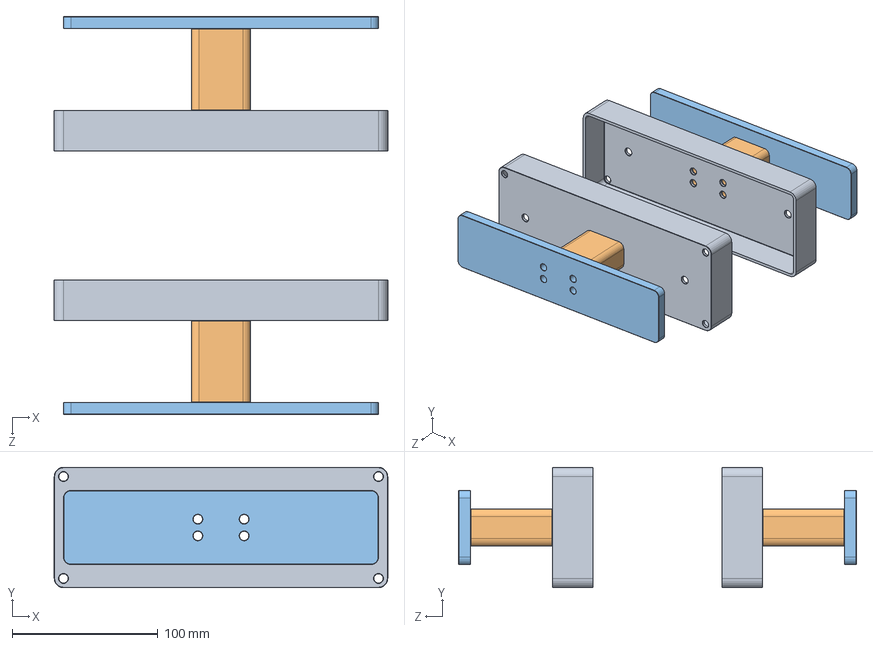
[picture p166: CAD file, 2018-04-12]
Project/CAD/Final Design CAD/ChassisAcc.SLDASM
228.6 x 82.5 x 272.8 mm
ChassisSideCover x 2
SideSensorEntension x 2
SideSensorMount x 2
