andrewrichardr/MSE2202BDesignProject/Project/CAD/Final Design CAD/ChassisDrw.SLDASM

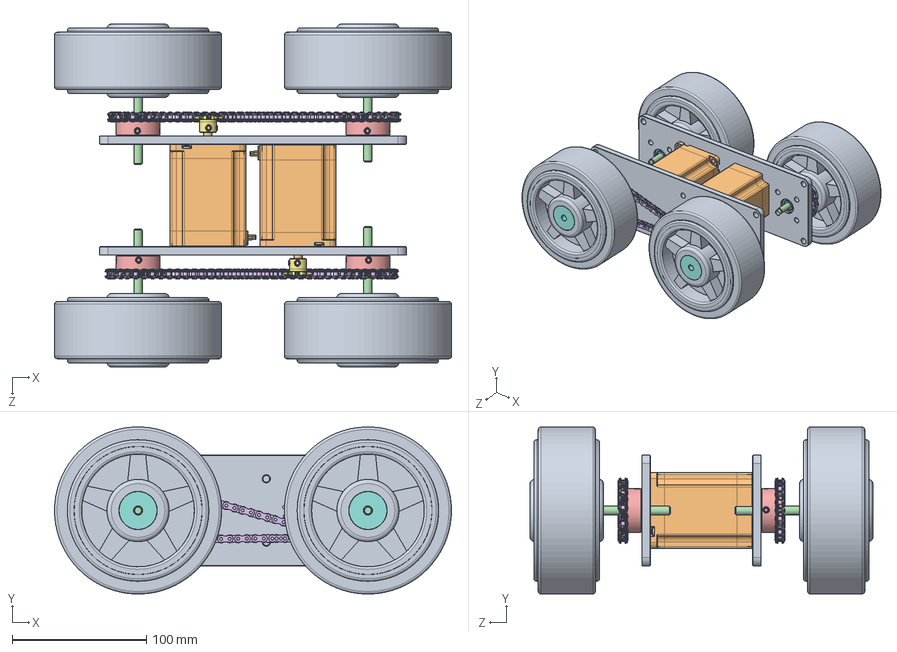
[picture p167: CAD file, 2018-04-12]
Project/CAD/Final Design CAD/ChassisDrw.SLDASM
295.7 x 124.3 x 255.3 mm
ChassisSidePlate x 2
DriveStepper x 2
60355K503_BALL BEARING x 4
1327K113_MINIATURE 12L14 DRIVE STEEL SHAFT x 4
2737T131_FINISHED-BORE SPROCKET FOR ANSI ROLLER CHAIN x 4
6261K281_ROLLER CHAIN x 78
2737T200_FINISHED-BORE SPROCKET FOR ANSI ROLLER CHAIN x 2
Wheel_Bushing x 4
CasterWheel_5in.ipt x 4
