andrewrichardr/MSE2202BDesignProject/Project/CAD/Final Design CAD/Wheels.SLDASM

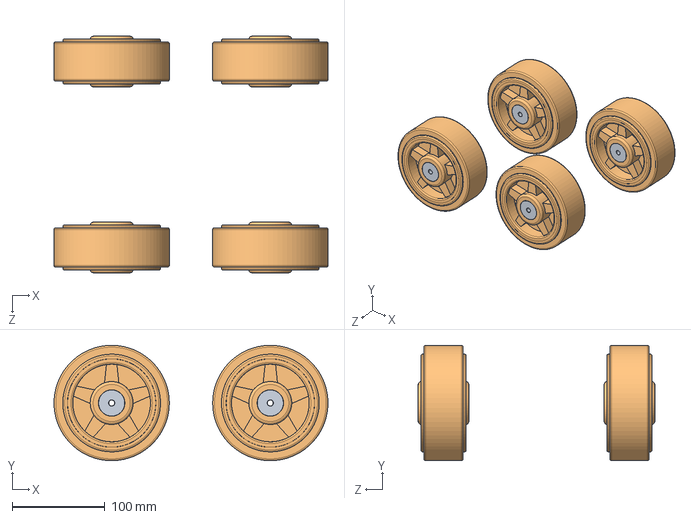
[picture p168: CAD file, 2018-04-12]
Project/CAD/Final Design CAD/Wheels.SLDASM
295.7 x 124.3 x 255.3 mm
Wheel_Bushing x 4
CasterWheel_5in.ipt x 4
