andrewrichardr/MSE2202BDesignProject/Project/CAD/Prototype CAD/CubeIntakeArm/sprockets.SLDASM

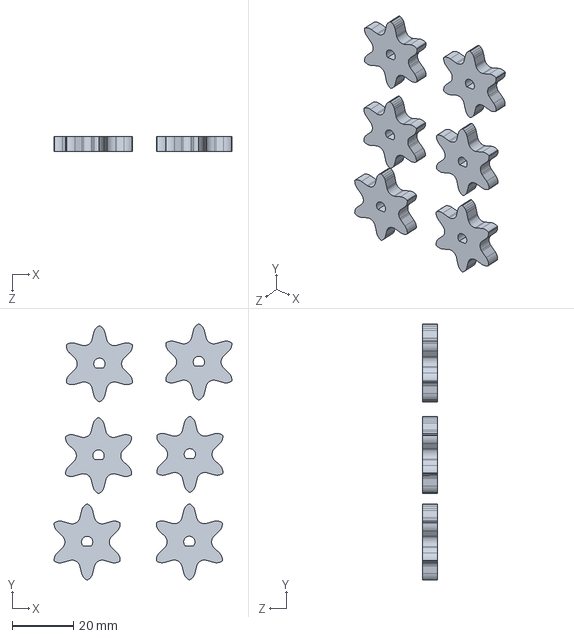
[picture p169: CAD file, 2018-04-03]
Project/CAD/Prototype CAD/CubeIntakeArm/sprockets.SLDASM
57.9 x 83.3 x 4.76 mm
sprocket-d x 6
