andrewrichardr/MSE2202BDesignProject/Project/CAD/Prototype CAD/Pyramid Lift Assembly/Pyramid Intake.SLDASM

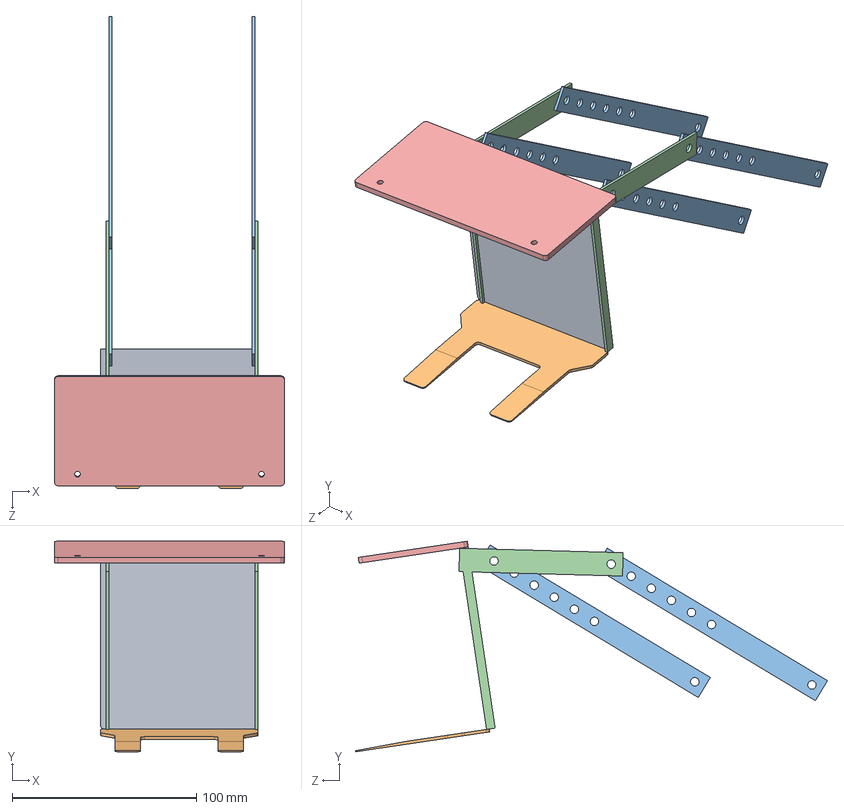
[picture p170: CAD file, 2018-04-08]
Project/CAD/Prototype CAD/Pyramid Lift Assembly/Pyramid Intake.SLDASM
125.0 x 114.4 x 256.4 mm
back
BottomForklift
Circles 5.5in Inch Shaft Bar x 4
Circles 3.5 inch Linkage x 2
top
