andrewrichardr/MSE2202BDesignProject/Project/CAD/Final Design CAD/Chassis.SLDASM

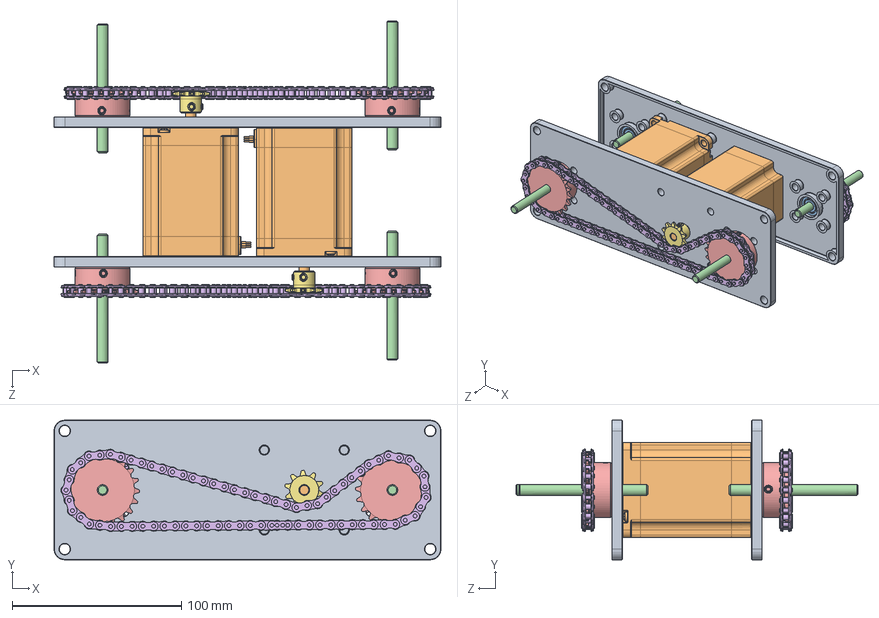
[picture p171: CAD file, 2018-04-12]
Project/CAD/Final Design CAD/Chassis.SLDASM
228.6 x 82.5 x 202.3 mm
ChassisSidePlate x 2
DriveStepper x 2
60355K503_BALL BEARING x 4
1327K113_MINIATURE 12L14 DRIVE STEEL SHAFT x 4
2737T131_FINISHED-BORE SPROCKET FOR ANSI ROLLER CHAIN x 4
6261K281_ROLLER CHAIN x 78
2737T200_FINISHED-BORE SPROCKET FOR ANSI ROLLER CHAIN x 2
