andrewrichardr/MSE2202BDesignProject/Project/CAD/Prototype CAD/CubeIntakeArm/Assem1.SLDASM

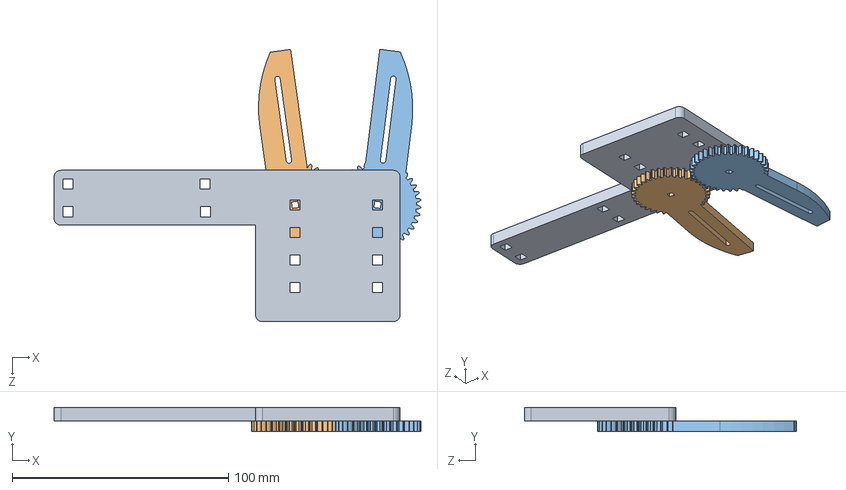
[picture p172: CAD file, 2018-04-03]
Project/CAD/Prototype CAD/CubeIntakeArm/Assem1.SLDASM
169.6 x 11.1 x 125.9 mm
Claw-Holder
CLAW_L
CLAW_R
