andrewrichardr/MSE2202BDesignProject/Project/CAD/Final Design CAD/WheelAssy.SLDASM

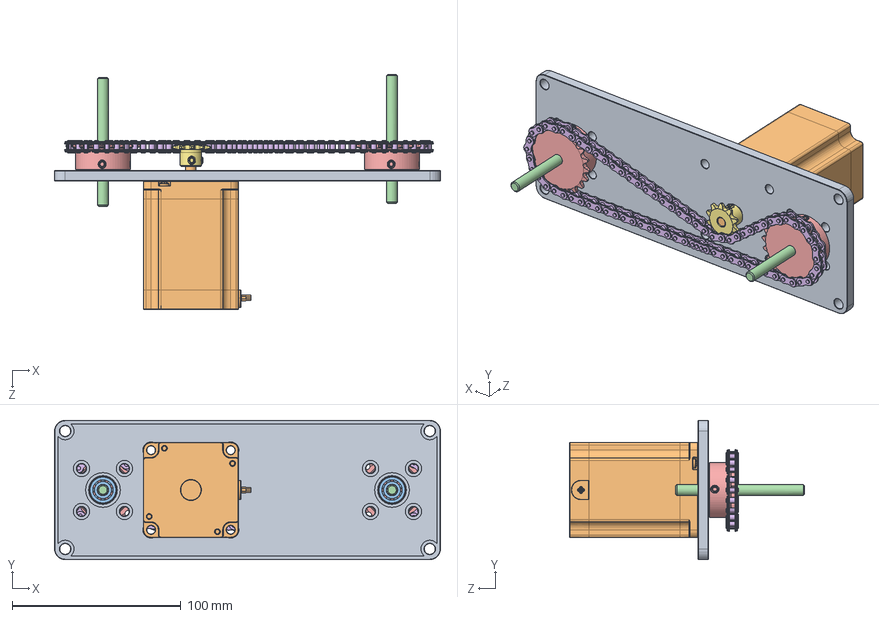
[picture p173: CAD file, 2018-04-12]
Project/CAD/Final Design CAD/WheelAssy.SLDASM
228.6 x 82.5 x 139.0 mm
ChassisSidePlate
DriveStepper
60355K503_BALL BEARING x 2
1327K113_MINIATURE 12L14 DRIVE STEEL SHAFT x 2
2737T131_FINISHED-BORE SPROCKET FOR ANSI ROLLER CHAIN x 2
6261K281_ROLLER CHAIN x 39
2737T200_FINISHED-BORE SPROCKET FOR ANSI ROLLER CHAIN
