andrewrichardr/MSE2202BDesignProject/Project/CAD/Prototype CAD/CubeIntakeArm/arm.SLDASM

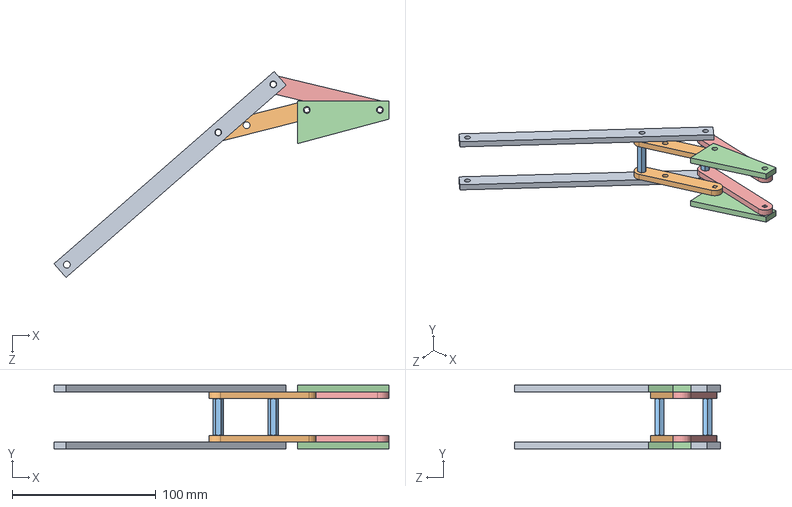
[picture p174: CAD file, 2018-04-02]
Project/CAD/Prototype CAD/CubeIntakeArm/arm.SLDASM
232.9 x 44.5 x 143.2 mm
lnk1 x 2
lnk2 x 2
hw1 x 2
lnk3 x 2
lnk4 x 2
