andrewrichardr/MSE2202BDesignProject/Project/CAD/Prototype Assy/ControllerTray-NoMates.SLDASM

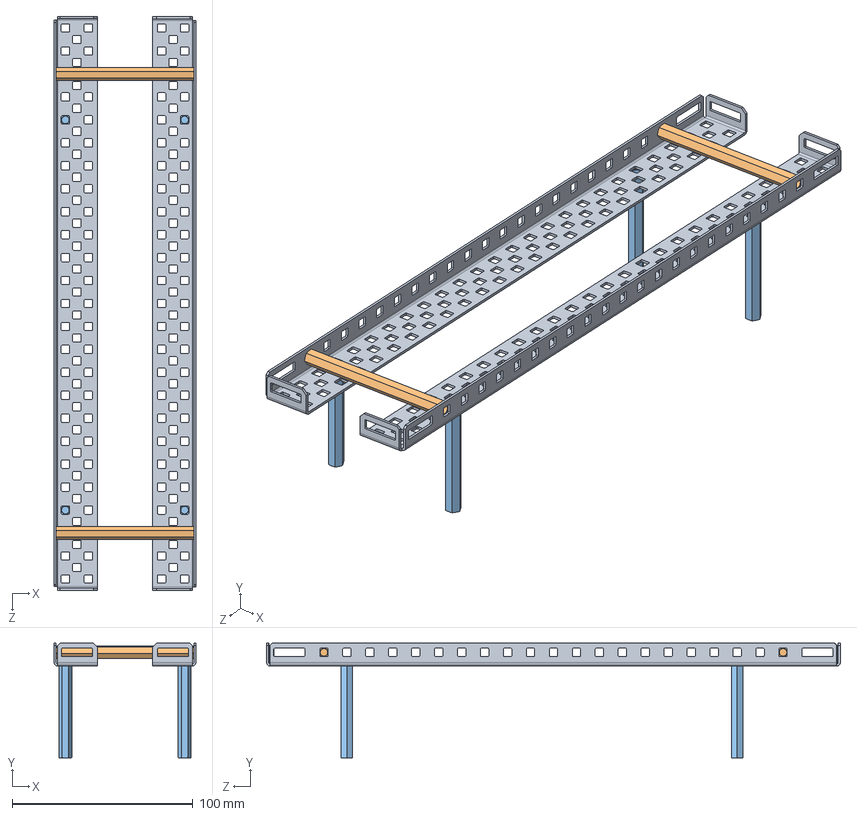
[picture p175: CAD file, 2018-04-08]
Project/CAD/Prototype Assy/ControllerTray-NoMates.SLDASM
78.5 x 63.5 x 317.6 mm
VL-RAIL-21-25 RevA x 2
BEAM-3000 x 2
BEAM-2000 x 4
