andrewrichardr/MSE2202BDesignProject/Project/CAD/Prototype CAD/CubeIntakeArm/cuter.SLDASM

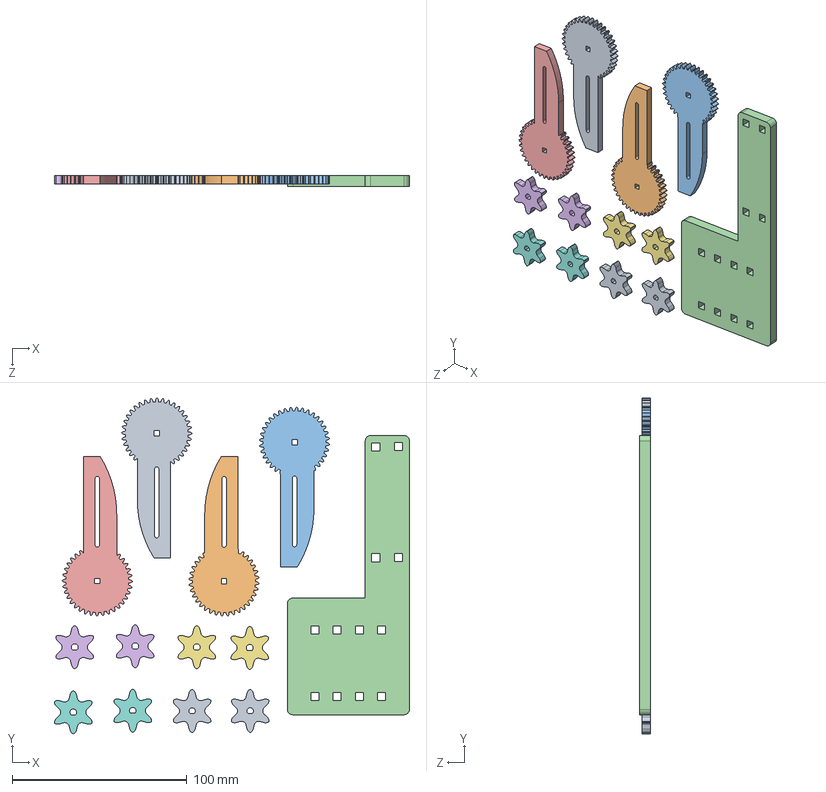
[picture p176: CAD file, 2018-04-02]
Project/CAD/Prototype CAD/CubeIntakeArm/cuter.SLDASM
203.3 x 192.4 x 6.35 mm
CLAW_Lb
CLAW_R
CLAW_Rb
Claw-Holder
CLAW_L
sprocket-a x 2
sprocket-b x 2
sprocket-c x 2
sprocket-d x 2
