andrewrichardr/MSE2202BDesignProject/Project/CAD/Prototype Assy/ClawAssy-NoMates.SLDASM

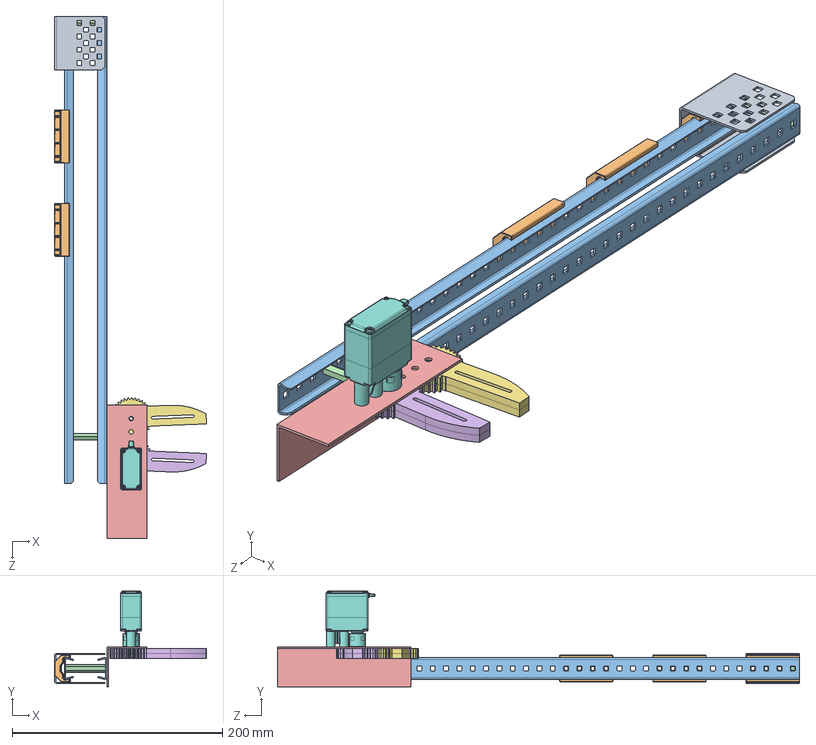
[picture p177: CAD file, 2018-04-07]
Project/CAD/Prototype Assy/ClawAssy-NoMates.SLDASM
144.7 x 91.2 x 497.1 mm
276-1926-002 Rev1
276-1926-004 Rev1 x 3
276-1926-005 Rev1 x 2
BEAM-1500 x 2
Claw-Bracket
CLAW_L x 2
CLAW_R x 2
VEX-MOTOR
