andrewrichardr/MSE2202BDesignProject/Project/CAD/Prototype CAD/DRIVE MOTOR.SLDASM

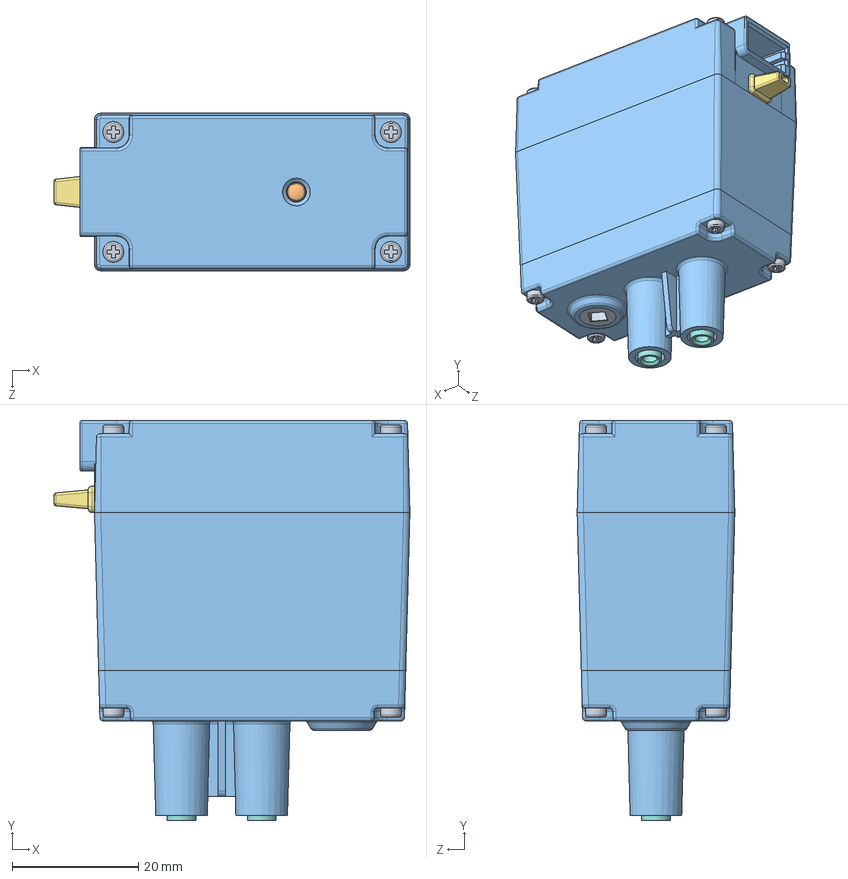
[picture p178: CAD file, 2018-03-14]
Project/CAD/Prototype CAD/DRIVE MOTOR.SLDASM
56.4 x 63.4 x 25.0 mm
SPPM206-0150BO x 4
276-2177-004 Rev1
276-2177-003 Rev1
SPPM204-0050BO x 2
276-2177-014 Rev1
276-2177-005 Rev1
276-2177-015 Rev2
276-2177-019 Rev1 x 2
276-2177-016 Rev2
276-2177-012 Rev1
276-2177-002 Rev1
LABLE_1 x 2
276-2177-011 Rev1
FS130-FT-21100
276-2177-010 Rev1
276-2177-006 Rev1
M2_1 x 4
LIGHT_1
BOX-BOTTOM2_3
PCB2_3
PIN2_1
PIN_1
276-2177-018 Rev1
276-2177-013 Rev1
276-2177-009 Rev1
