andrewrichardr/MSE2202BDesignProject/Project/CAD/Prototype CAD/chasis.SLDASM

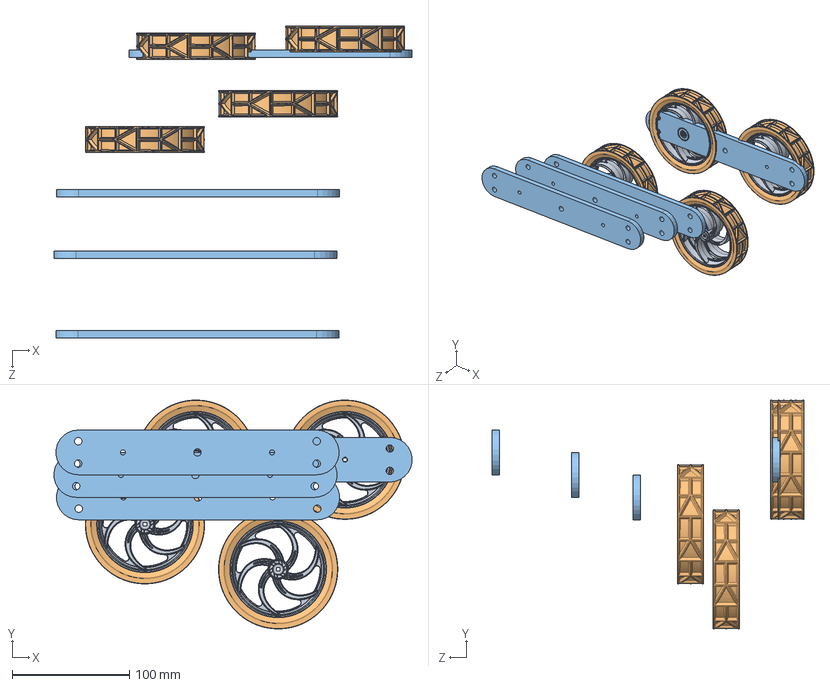
[picture p179: CAD file, 2018-03-14]
Project/CAD/Prototype CAD/chasis.SLDASM
305.0 x 194.9 x 266.0 mm
MEDIUM-WHEEL-HUB x 4
MEDIUM-WHEEL-TIRE x 4
sidebar x 4
