andrewrichardr/MSE2202BDesignProject/Project/CAD/Final Design CAD/LiftAssy.SLDASM

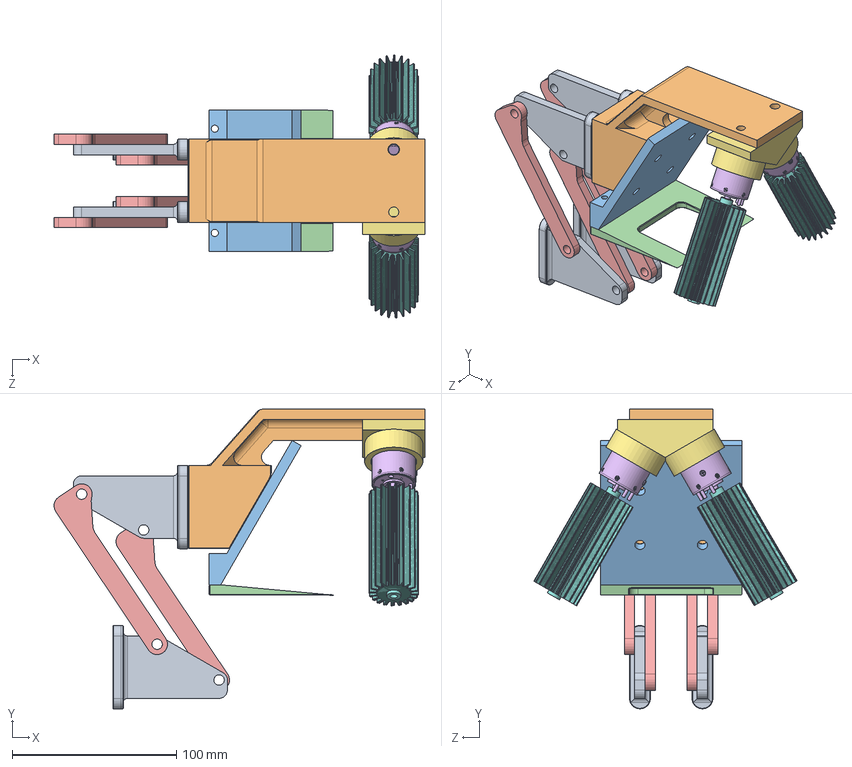
[picture p180: CAD file, 2018-04-09]
Project/CAD/Final Design CAD/LiftAssy.SLDASM
226.2 x 182.7 x 160.6 mm
LiftLinkageBaseMount x 4
PyrIntakeAngledMount
PyrIntakeBacking
PyrIntakeForks
LiftLinkage x 4
PyrIntakeFlapperMotor x 2
PyrIntakeMotorMount
PyrIntakeRoller x 2
