andrewrichardr/MSE2202BDesignProject/Project/CAD/Prototype CAD/VEX-MEDIUM-WHEEL.SLDASM

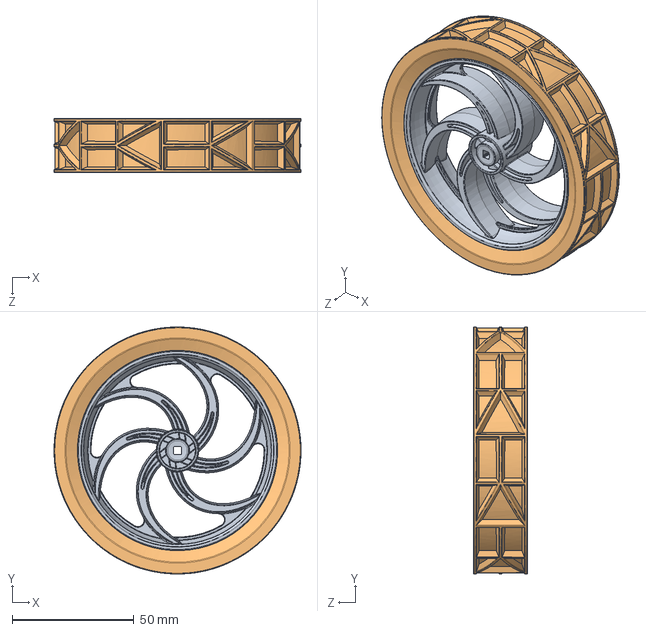
[picture p181: CAD file, 2018-03-14]
Project/CAD/Prototype CAD/VEX-MEDIUM-WHEEL.SLDASM
101.6 x 101.6 x 22.3 mm
MEDIUM-WHEEL-HUB
MEDIUM-WHEEL-TIRE
