andrewrichardr/MSE2202BDesignProject/Project/CAD/Final Design CAD/nema-23-stepper-motor-shaft-d8-length-41-115mm-1.snapshot.2/Nema 23 Stepper Motor length 41mm.SLDPRT

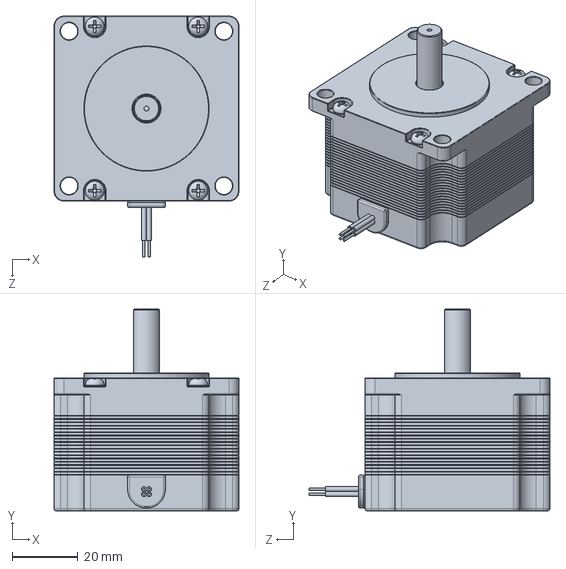
[picture p182: CAD file, 2018-04-09]
Project/CAD/Final Design CAD/nema-23-stepper-motor-shaft-d8-length-41-115mm-1.snapshot.2/Nema 23 Stepper Motor length 41mm.SLDPRT
56.3 x 61.5 x 73.3 mm
