andrewrichardr/MSE2202BDesignProject/Project/CAD/MCUMount.SLDPRT

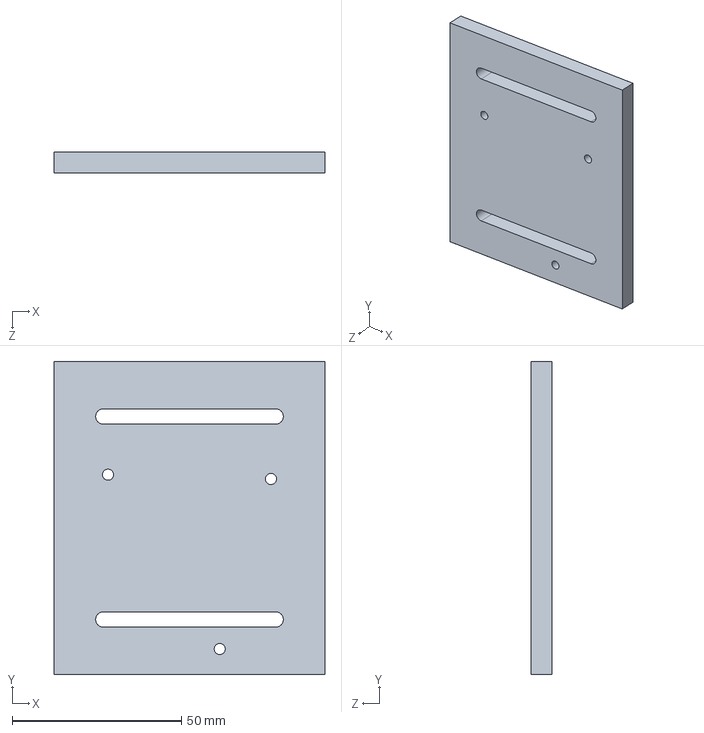
[picture p183: CAD file, 2018-03-29]
Project/CAD/MCUMount.SLDPRT
80.0 x 92.5 x 6.35 mm
