andrewrichardr/MSE2202BDesignProject/Project/CAD/Prototype Assy/INTAKE-ROLLER.SLDPRT

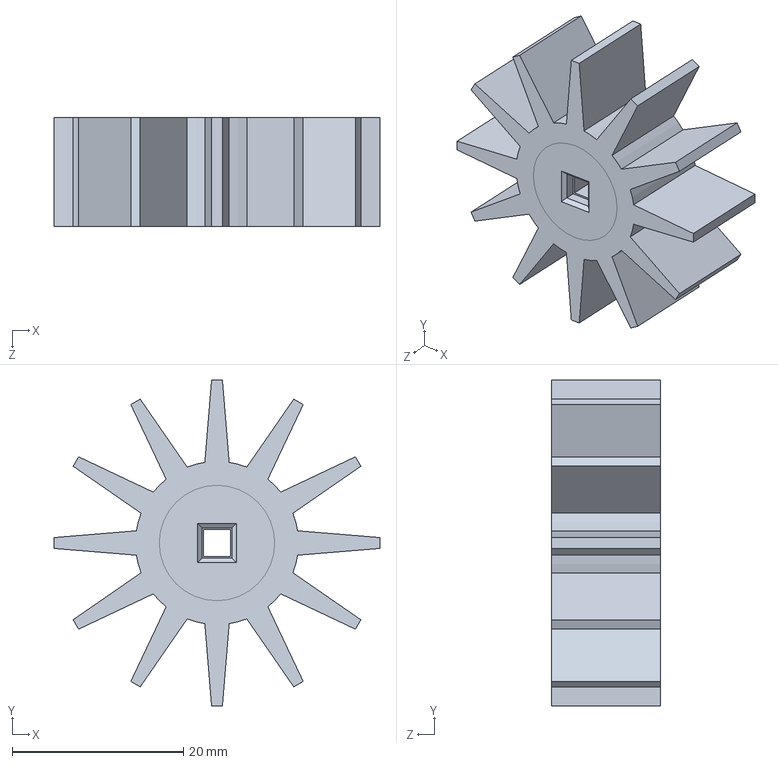
[picture p184: CAD file, 2018-04-08]
Project/CAD/Prototype Assy/INTAKE-ROLLER.SLDPRT
38.1 x 38.1 x 12.7 mm
