andrewrichardr/MSE2202BDesignProject/Project/CAD/Prototype CAD/aftermarket drive motor/sprocket-b.SLDPRT

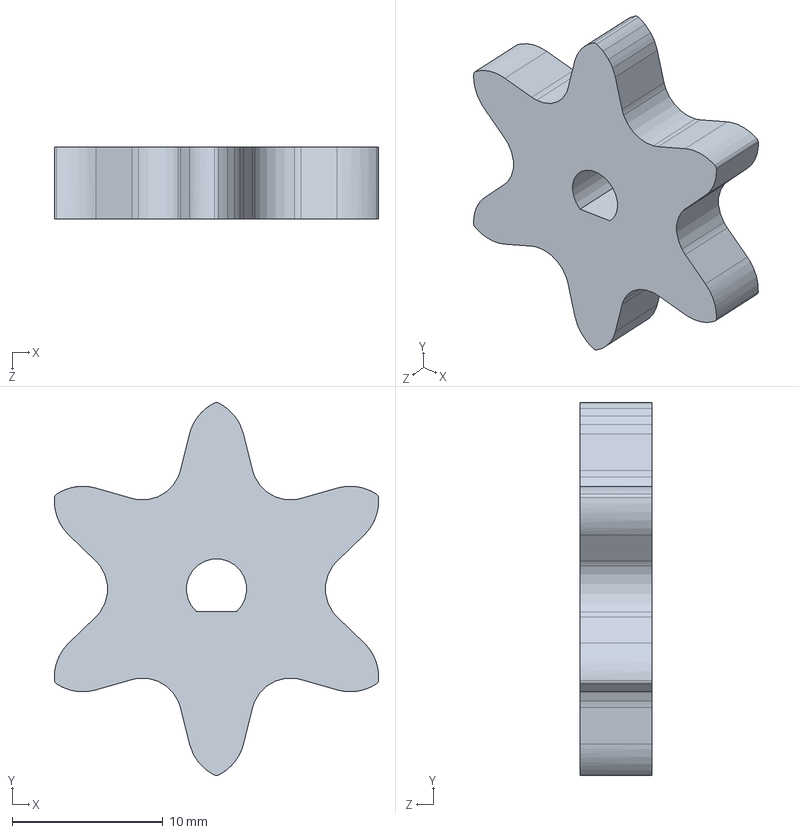
[picture p185: CAD file, 2018-04-02]
Project/CAD/Prototype CAD/aftermarket drive motor/sprocket-b.SLDPRT
21.5 x 24.7 x 4.76 mm
