andrewrichardr/MSE2202BDesignProject/Project/CAD/Prototype CAD/back updated.SLDPRT

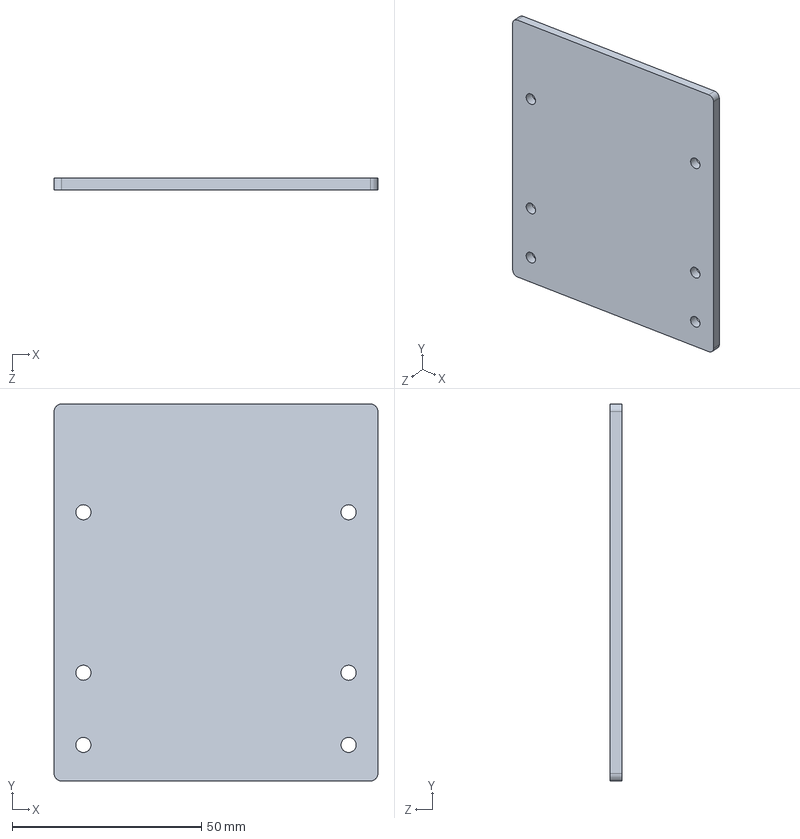
[picture p186: CAD file, 2018-04-11]
Project/CAD/Prototype CAD/back updated.SLDPRT
85.5 x 99.5 x 3.17 mm
