andrewrichardr/MSE2202BDesignProject/Project/CAD/Prototype CAD/Claw/New Claw.SLDPRT

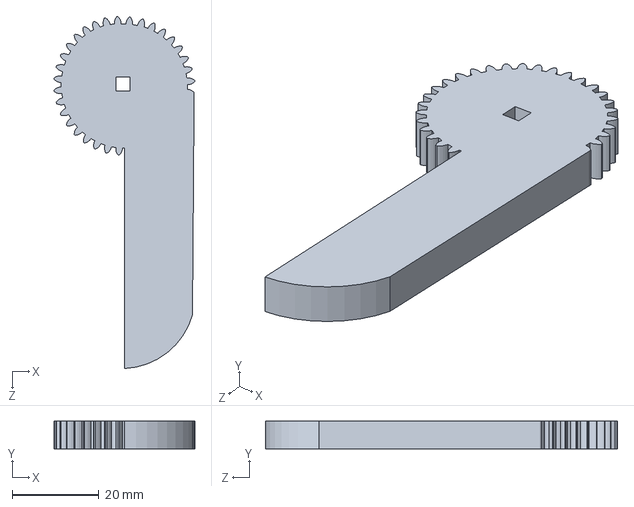
[picture p187: CAD file, 2018-04-02]
Project/CAD/Prototype CAD/Claw/New Claw.SLDPRT
32.5 x 6.35 x 81.2 mm
