andrewrichardr/MSE2202BDesignProject/Project/CAD/Prototype CAD/CubeIntakeArm/VEX-MOTOR.SLDPRT

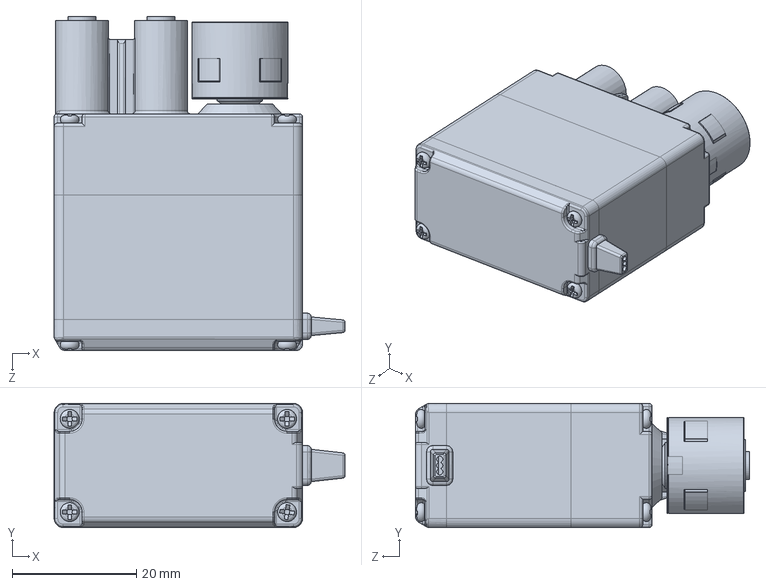
[picture p188: CAD file, 2018-04-07]
Project/CAD/Prototype CAD/CubeIntakeArm/VEX-MOTOR.SLDPRT
46.8 x 20.0 x 53.8 mm
