andrewrichardr/MSE2202BDesignProject/Project/CAD/Prototype CAD/Lift Linkages/5.5in Inch Shaft Bar.SLDPRT

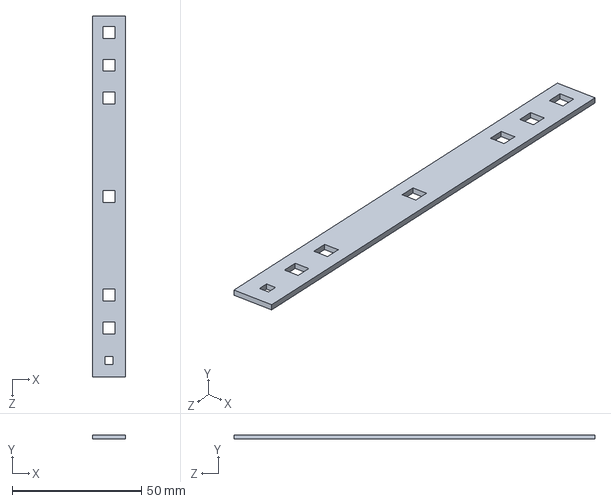
[picture p189: CAD file, 2018-04-11]
Project/CAD/Prototype CAD/Lift Linkages/5.5in Inch Shaft Bar.SLDPRT
12.7 x 1.59 x 139.7 mm
