andrewrichardr/MSE2202BDesignProject/Project/CAD/Prototype CAD/Pyramid Lift Assembly/Circles 3.5 inch Linkage.SLDPRT

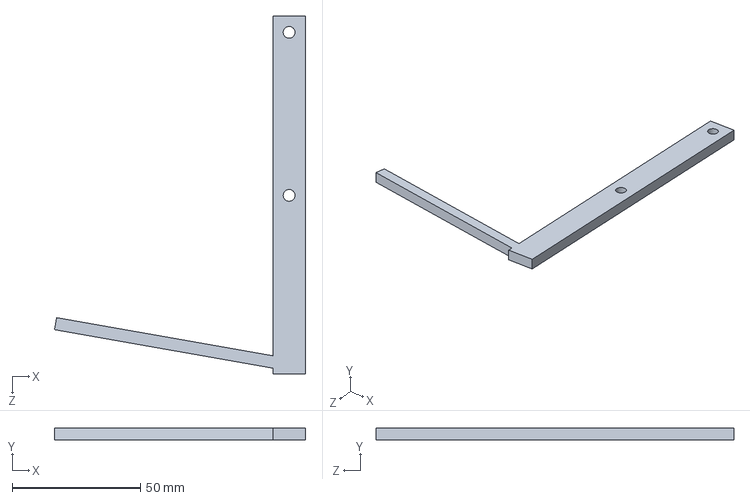
[picture p190: CAD file, 2018-04-11]
Project/CAD/Prototype CAD/Pyramid Lift Assembly/Circles 3.5 inch Linkage.SLDPRT
98.0 x 4.76 x 139.7 mm
