andrewrichardr/MSE2202BDesignProject/Project/CAD/Prototype Assy/Claw-Bracket.SLDPRT

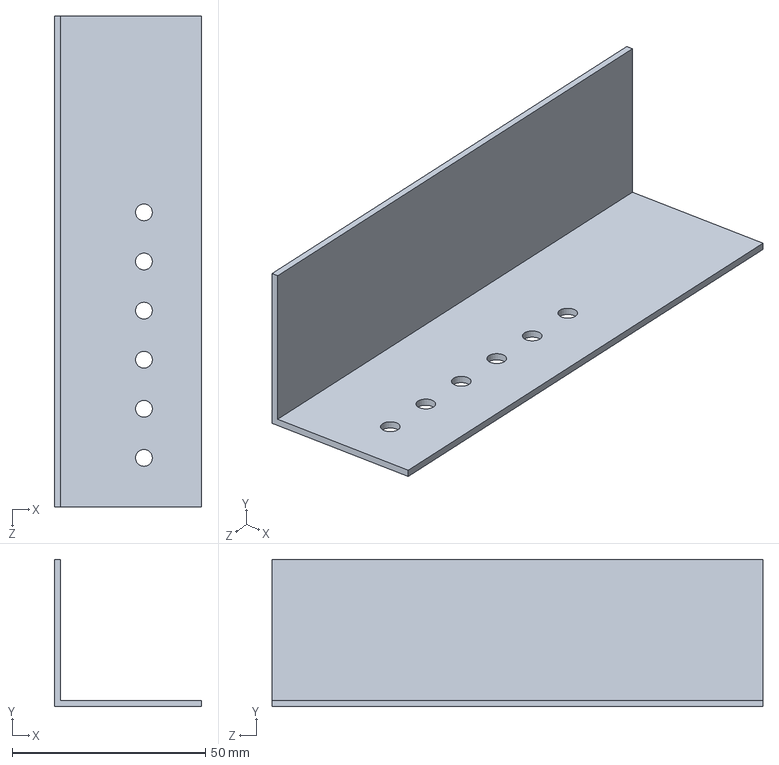
[picture p191: CAD file, 2018-04-08]
Project/CAD/Prototype Assy/Claw-Bracket.SLDPRT
38.1 x 38.1 x 127.0 mm
