andrewrichardr/MSE2202BDesignProject/Project/CAD/Prototype CAD/Claw/test high strength 60 tooth gear.SLDPRT

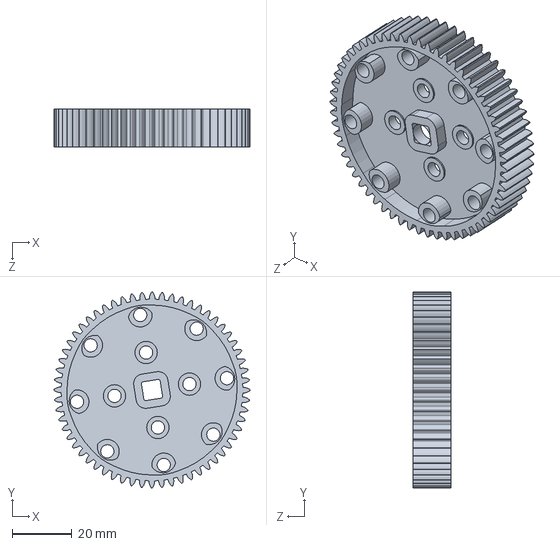
[picture p192: CAD file, 2018-04-02]
Project/CAD/Prototype CAD/Claw/test high strength 60 tooth gear.SLDPRT
65.6 x 65.6 x 12.7 mm
