andrewrichardr/MSE2202BDesignProject/Project/CAD/Prototype CAD/CubeIntakeArm/Claw-Holder.SLDPRT

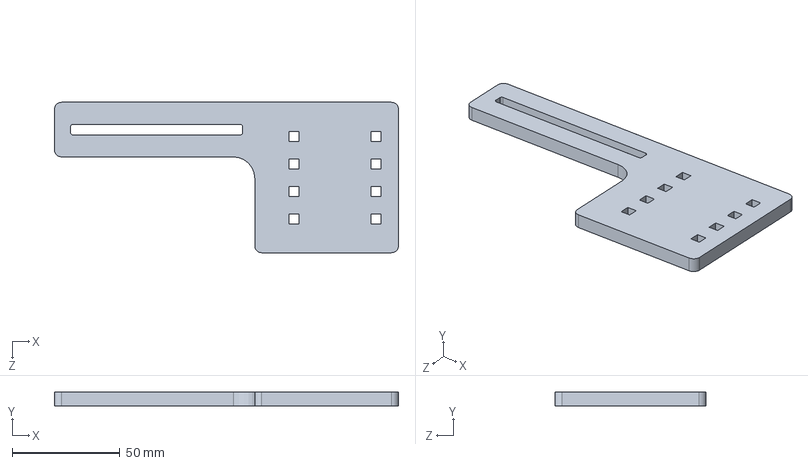
[picture p193: CAD file, 2018-04-07]
Project/CAD/Prototype CAD/CubeIntakeArm/Claw-Holder.SLDPRT
160.0 x 6.35 x 70.0 mm
