andrewrichardr/MSE2202BDesignProject/Project/CAD/Prototype CAD/Lift Linkages/Connector 3.5 inch Linkage.SLDPRT

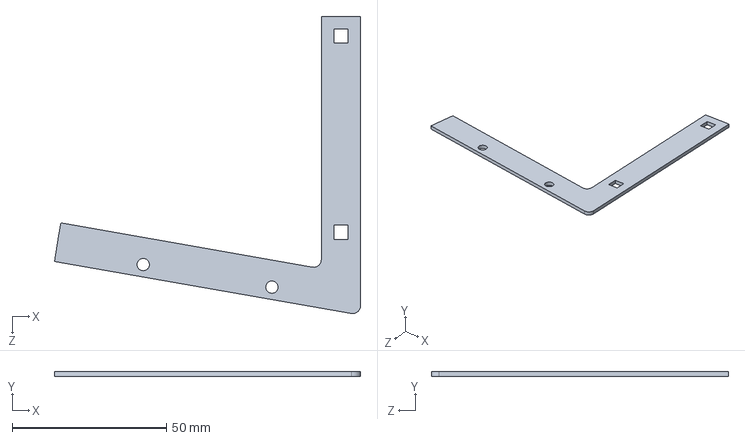
[picture p194: CAD file, 2018-04-11]
Project/CAD/Prototype CAD/Lift Linkages/Connector 3.5 inch Linkage.SLDPRT
99.2 x 1.59 x 96.4 mm
