andrewrichardr/MSE2202BDesignProject/Project/CAD/Prototype CAD/Pyramid Lift Assembly/Circles 3.5 inch Linkage-o.SLDPRT

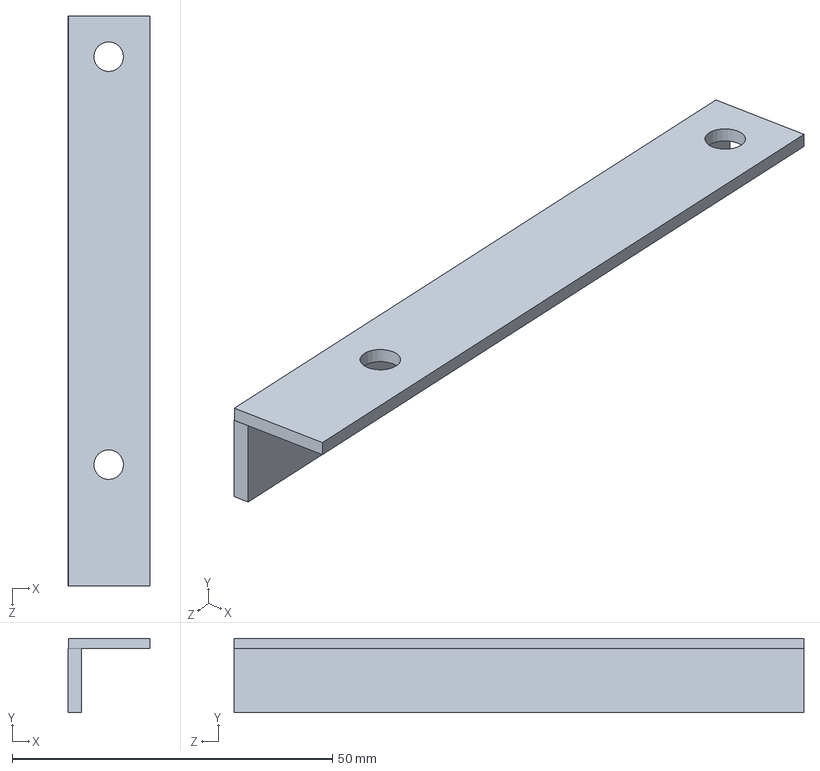
[picture p195: CAD file, 2018-04-08]
Project/CAD/Prototype CAD/Pyramid Lift Assembly/Circles 3.5 inch Linkage-o.SLDPRT
12.7 x 11.6 x 88.9 mm
