andrewrichardr/MSE2202BDesignProject/Project/CAD/Prototype CAD/VEX-36-TOOTH-GEAR-b.DXF

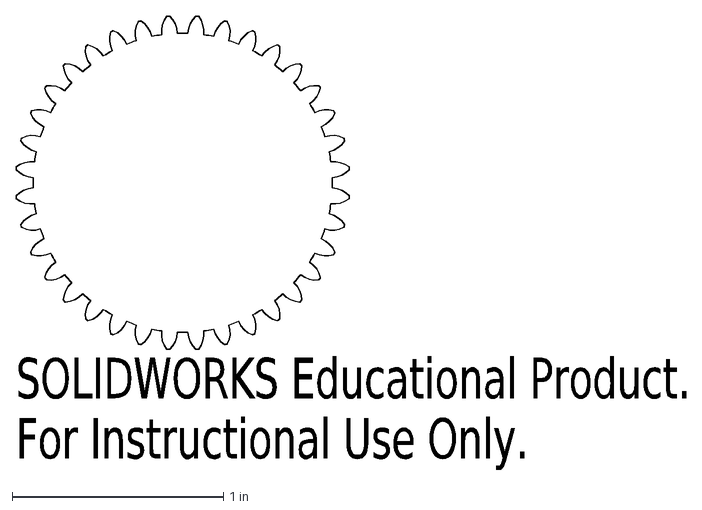
[picture p196: CAD file, 2018-04-02]
Project/CAD/Prototype CAD/VEX-36-TOOTH-GEAR-b.DXF
SOLIDWORKS Educational Product.
For Instructional Use Only.
