andrewrichardr/MSE2202BDesignProject/Project/CAD/Prototype Assy/VL-CHAN-121-15 RevA.SLDPRT

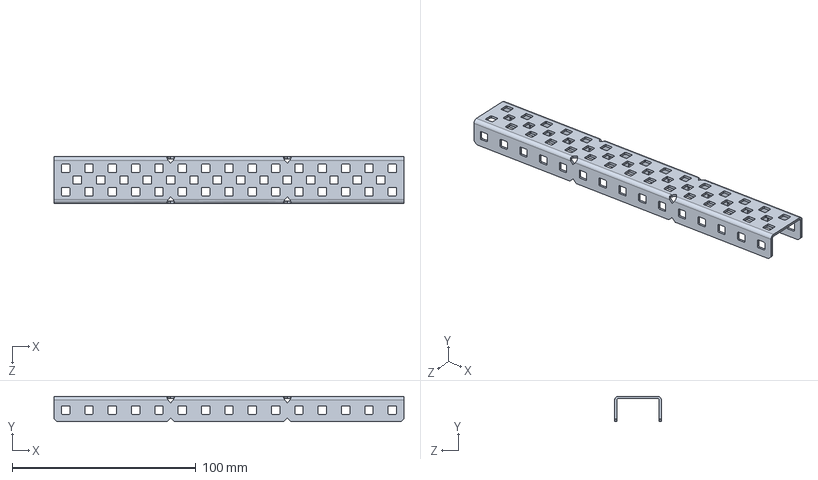
[picture p197: CAD file, 2018-04-08]
Project/CAD/Prototype Assy/VL-CHAN-121-15 RevA.SLDPRT
190.5 x 13.9 x 25.4 mm
