andrewrichardr/MSE2202BDesignProject/Project/CAD/Prototype CAD/aftermarket drive motor/sprocket-hs-06-tooth.SLDPRT

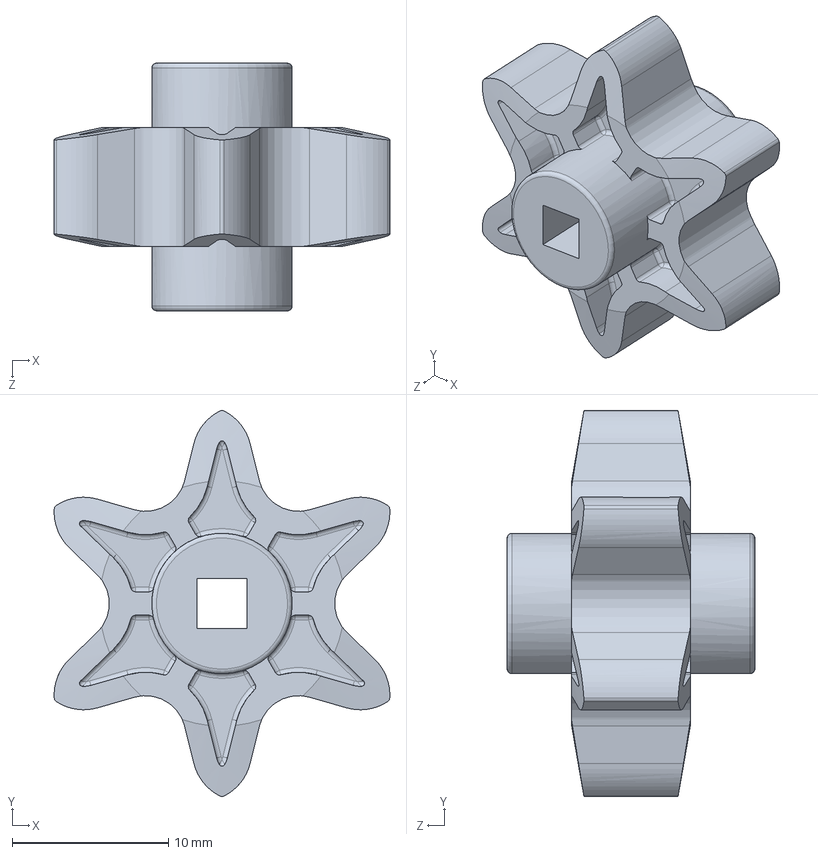
[picture p198: CAD file, 2018-04-02]
Project/CAD/Prototype CAD/aftermarket drive motor/sprocket-hs-06-tooth.SLDPRT
21.5 x 24.7 x 15.9 mm
