andrewrichardr/MSE2202BDesignProject/Project/CAD/Prototype CAD/Claw/60 tooth gear.SLDPRT

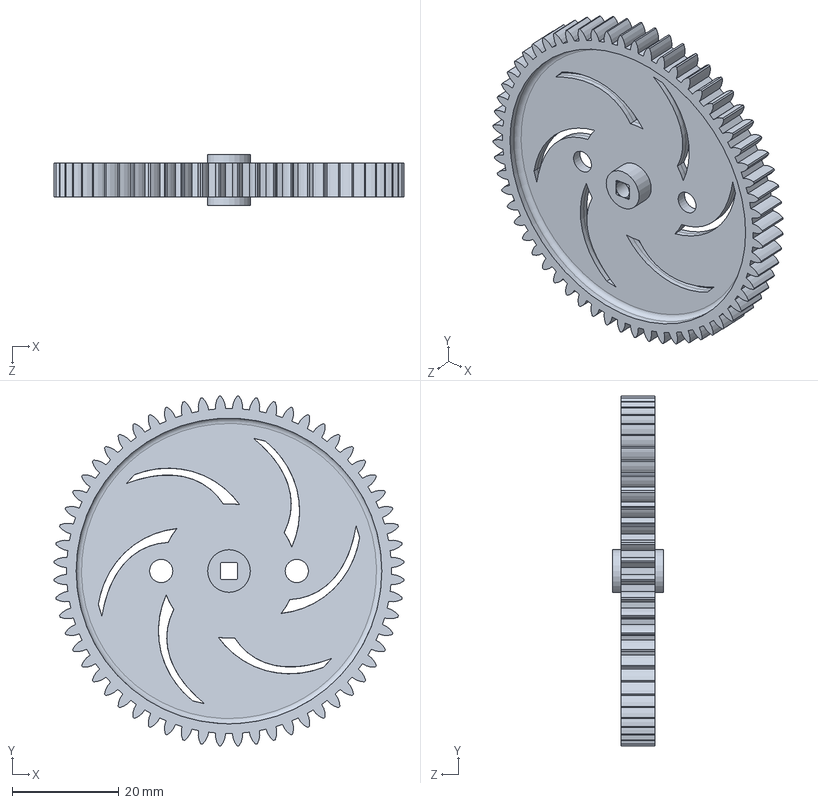
[picture p199: CAD file, 2018-04-02]
Project/CAD/Prototype CAD/Claw/60 tooth gear.SLDPRT
65.5 x 65.5 x 9.53 mm
