andrewrichardr/MSE2202BDesignProject/Project/CAD/Prototype CAD/Lift Linkages/3 inch Linkage.SLDPRT

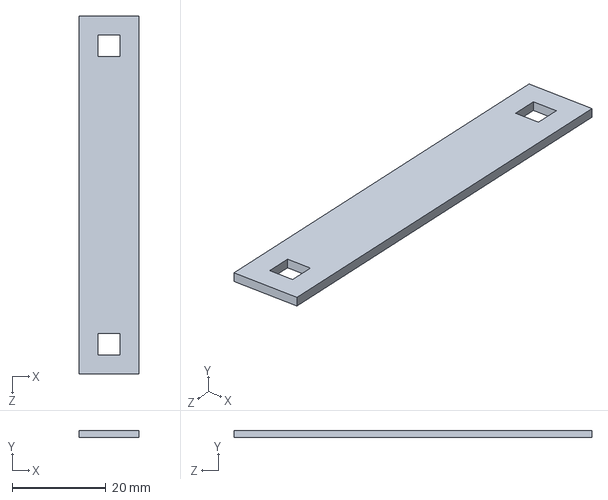
[picture p200: CAD file, 2018-04-02]
Project/CAD/Prototype CAD/Lift Linkages/3 inch Linkage.SLDPRT
12.7 x 1.59 x 76.2 mm
