andrewrichardr/MSE2202BDesignProject/Project/CAD/Prototype CAD/VEX-36-TOOTH-GEAR.DXF

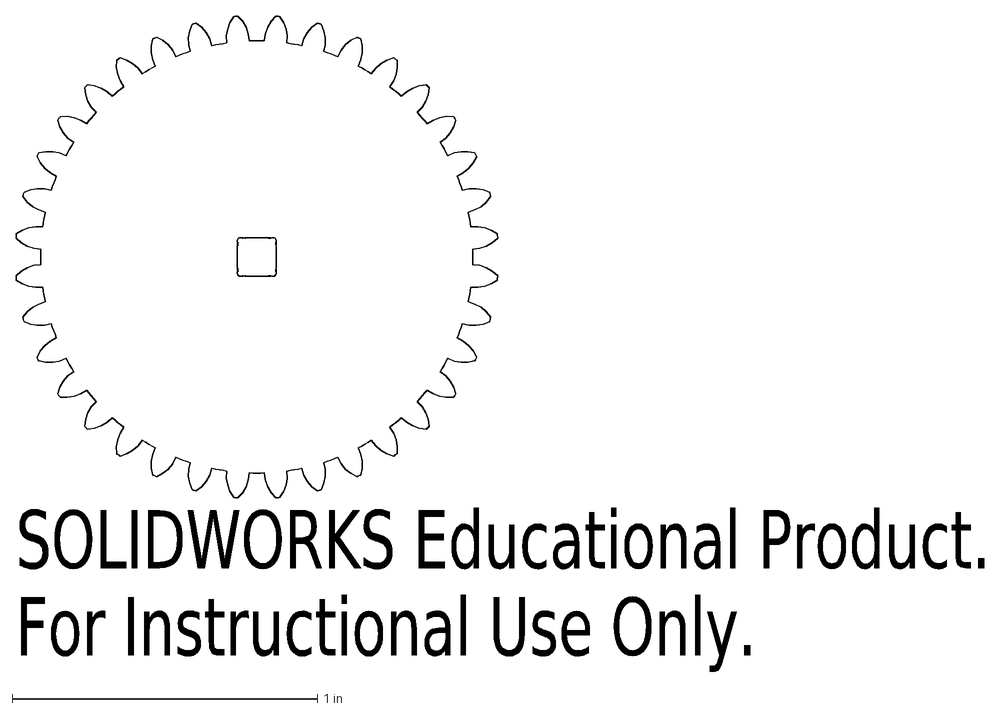
[picture p201: CAD file, 2018-04-02]
Project/CAD/Prototype CAD/VEX-36-TOOTH-GEAR.DXF
SOLIDWORKS Educational Product.
For Instructional Use Only.
