andrewrichardr/MSE2202BDesignProject/Project/CAD/Prototype Assy/VL-RAIL-21-25 RevA.SLDPRT

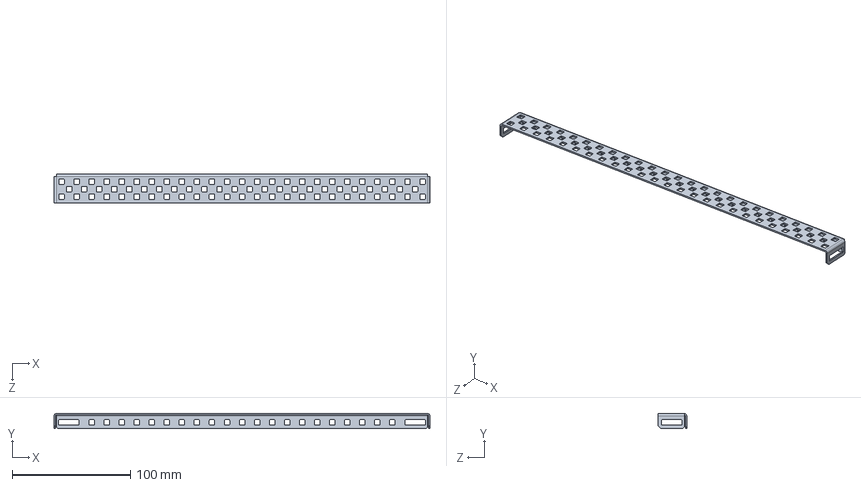
[picture p202: CAD file, 2018-04-08]
Project/CAD/Prototype Assy/VL-RAIL-21-25 RevA.SLDPRT
317.5 x 12.7 x 24.1 mm
