andrewrichardr/MSE2202BDesignProject/Project/CAD/Prototype CAD/Claw/Claw Holder.SLDPRT

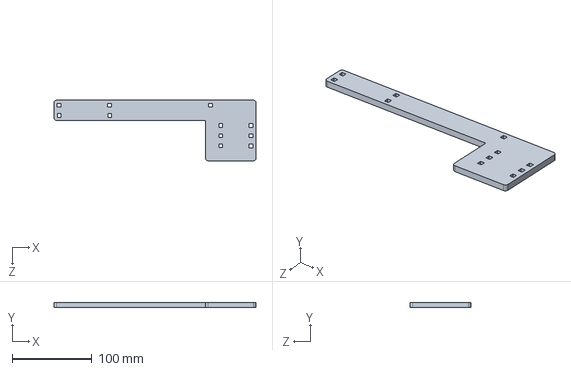
[picture p203: CAD file, 2018-04-02]
Project/CAD/Prototype CAD/Claw/Claw Holder.SLDPRT
254.0 x 6.35 x 76.2 mm
