andrewrichardr/MSE2202BDesignProject/Project/CAD/Prototype CAD/Lift Linkages/4.5in Inch Shaft Bar.SLDPRT

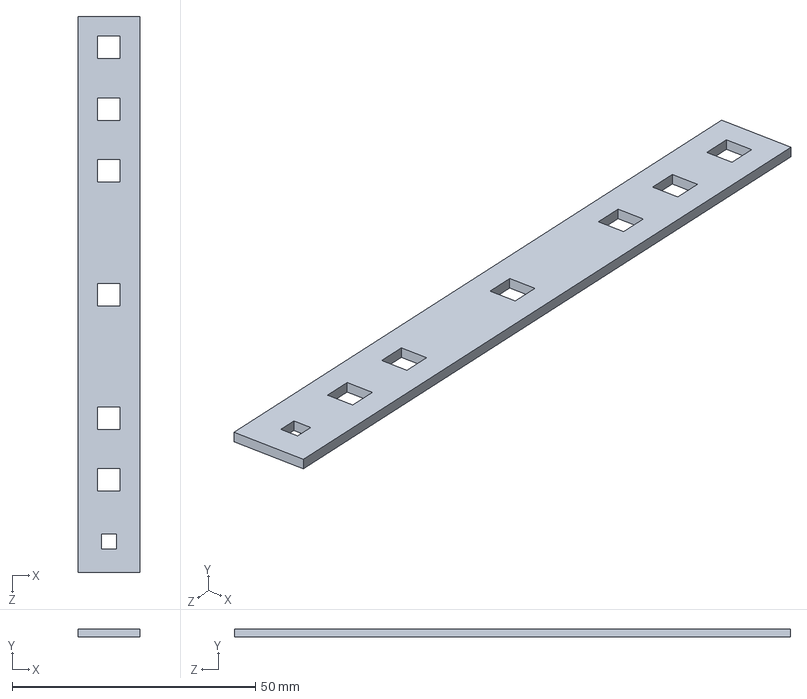
[picture p204: CAD file, 2018-04-02]
Project/CAD/Prototype CAD/Lift Linkages/4.5in Inch Shaft Bar.SLDPRT
12.7 x 1.59 x 114.3 mm
