andrewrichardr/MSE2202BDesignProject/Project/CAD/Prototype CAD/Pyramid Lift Assembly/BottomForklift.SLDPRT

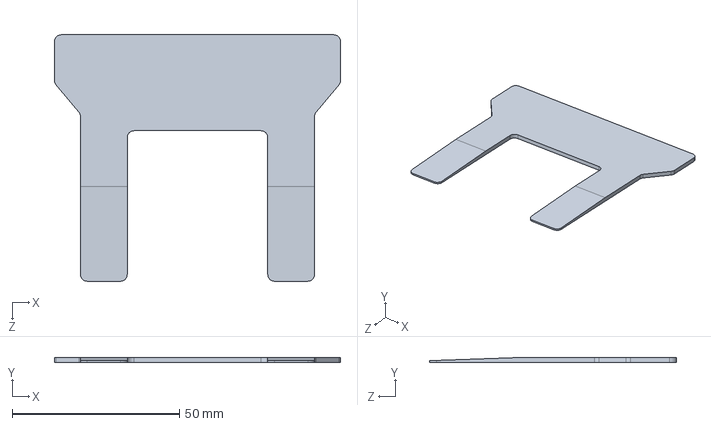
[picture p205: CAD file, 2018-04-02]
Project/CAD/Prototype CAD/Pyramid Lift Assembly/BottomForklift.SLDPRT
85.5 x 1.59 x 73.7 mm
