andrewrichardr/MSE2202BDesignProject/Project/CAD/Final Design CAD/PyrIntakeForks.SLDPRT

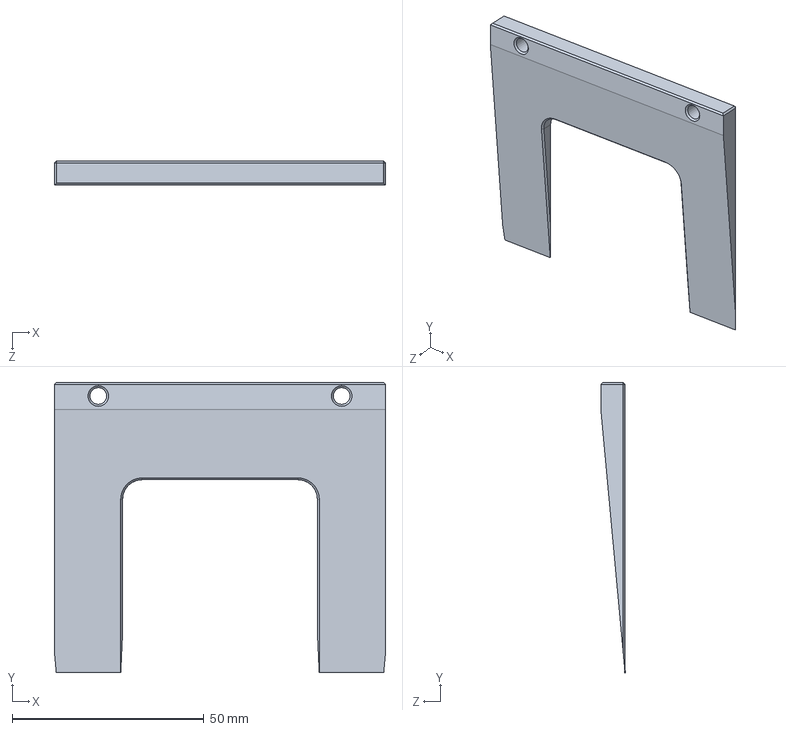
[picture p206: CAD file, 2018-04-12]
Project/CAD/Final Design CAD/PyrIntakeForks.SLDPRT
86.4 x 75.7 x 6.35 mm
