andrewrichardr/MSE2202BDesignProject/Project/CAD/Prototype Assy/chain-hs-link.SLDPRT

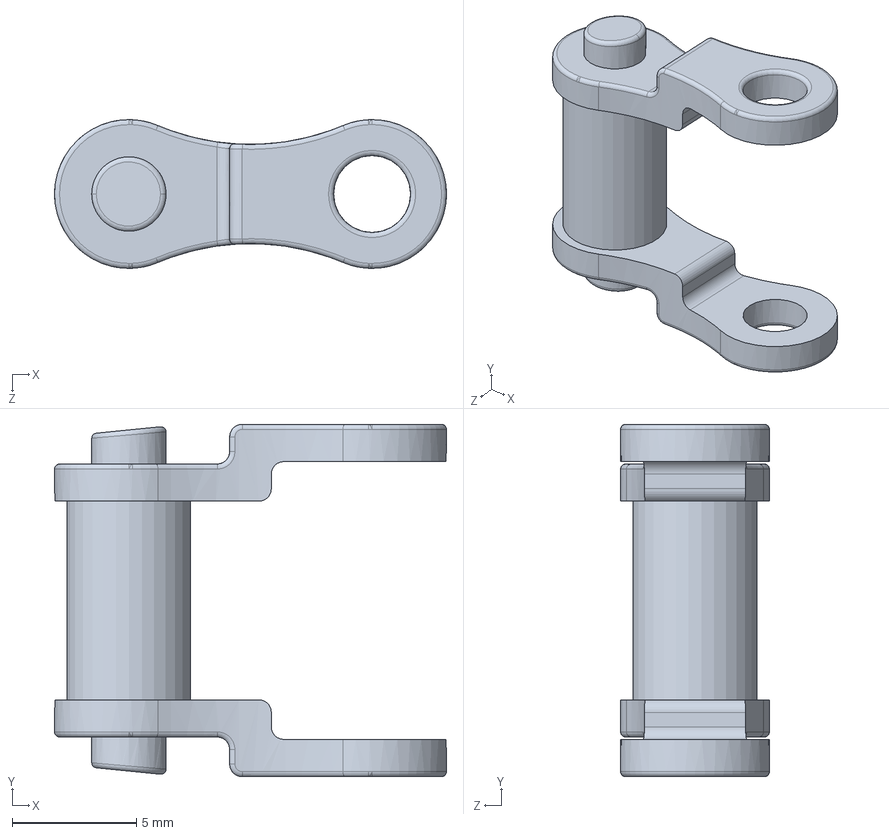
[picture p207: CAD file, 2018-04-08]
Project/CAD/Prototype Assy/chain-hs-link.SLDPRT
15.8 x 14.2 x 5.99 mm
