andrewrichardr/MSE2202BDesignProject/Project/CAD/Prototype CAD/aftermarket drive motor/motorsprocket.DXF

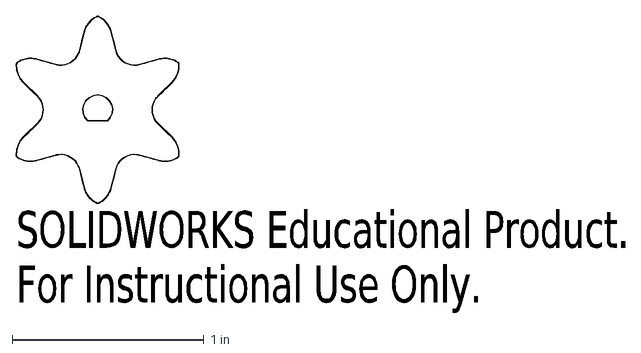
[picture p208: CAD file, 2018-04-02]
Project/CAD/Prototype CAD/aftermarket drive motor/motorsprocket.DXF
SOLIDWORKS Educational Product.
For Instructional Use Only.
