andrewrichardr/MSE2202BDesignProject/Project/CAD/Prototype CAD/Bottom(Forklift).SLDPRT

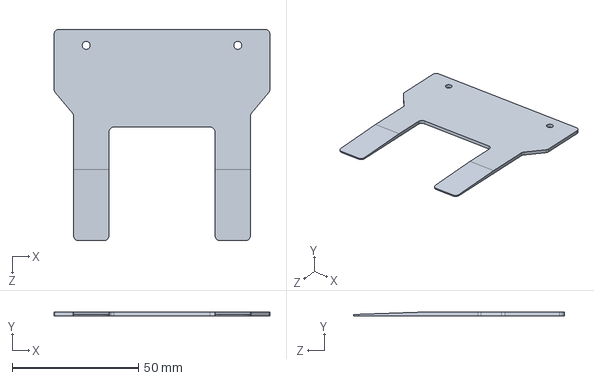
[picture p209: CAD file, 2018-03-20]
Project/CAD/Prototype CAD/Bottom(Forklift).SLDPRT
85.5 x 1.59 x 83.7 mm
