andrewrichardr/MSE2202BDesignProject/Project/CAD/Prototype CAD/CubeIntakeArm/hw1.SLDPRT

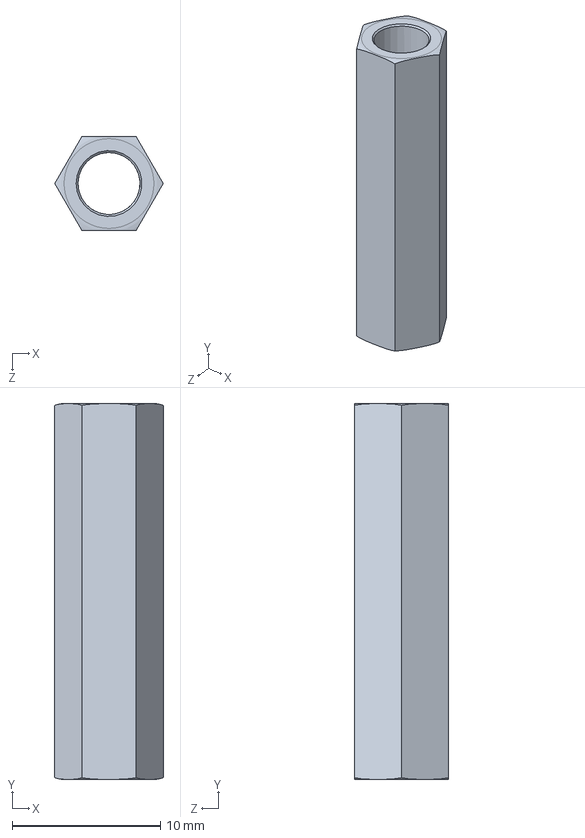
[picture p210: CAD file, 2018-04-02]
Project/CAD/Prototype CAD/CubeIntakeArm/hw1.SLDPRT
7.33 x 25.4 x 6.35 mm
