andrewrichardr/MSE2202BDesignProject/Project/CAD/Prototype CAD/Pyramid Lift Assembly/connector-2.SLDPRT

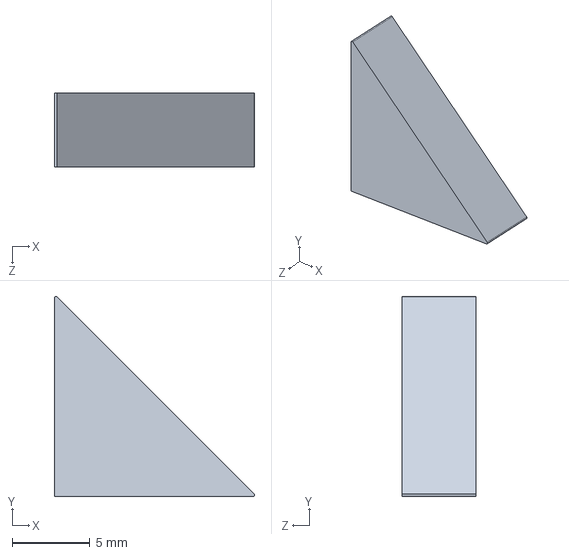
[picture p211: CAD file, 2018-04-02]
Project/CAD/Prototype CAD/Pyramid Lift Assembly/connector-2.SLDPRT
12.9 x 12.9 x 4.76 mm
