andrewrichardr/MSE2202BDesignProject/Project/CAD/Prototype Assy/magmount.SLDPRT

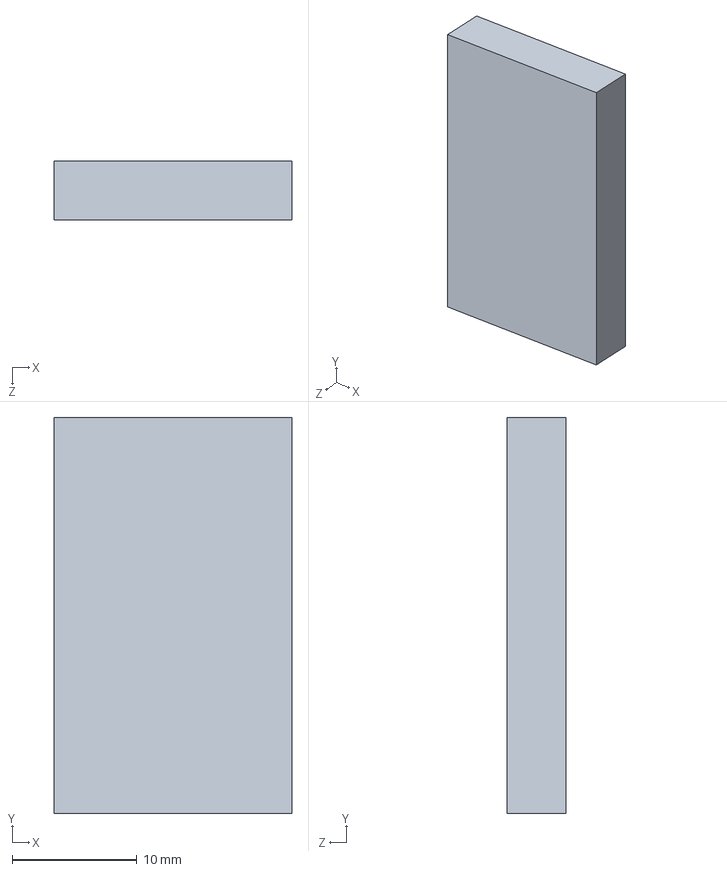
[picture p212: CAD file, 2018-04-08]
Project/CAD/Prototype Assy/magmount.SLDPRT
19.1 x 31.8 x 4.76 mm
