andrewrichardr/MSE2202BDesignProject/Project/CAD/Prototype CAD/CubeIntakeArm/lkn6.SLDPRT

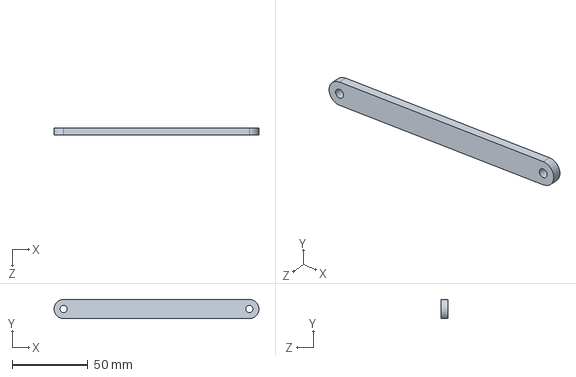
[picture p213: CAD file, 2018-04-02]
Project/CAD/Prototype CAD/CubeIntakeArm/lkn6.SLDPRT
135.1 x 12.7 x 4.76 mm
