andrewrichardr/MSE2202BDesignProject/Project/CAD/Prototype CAD/top.SLDPRT

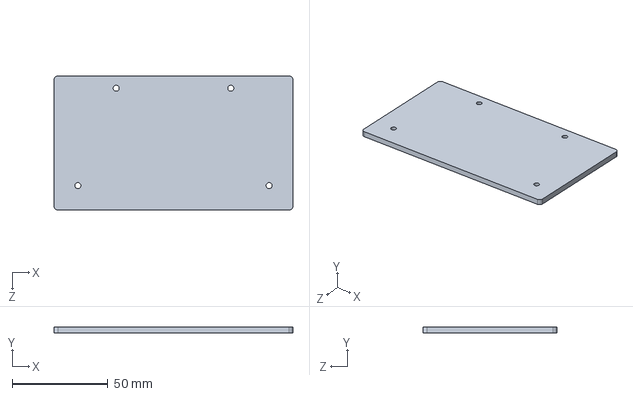
[picture p214: CAD file, 2018-03-20]
Project/CAD/Prototype CAD/top.SLDPRT
125.0 x 3.17 x 70.0 mm
