andrewrichardr/MSE2202BDesignProject/Project/CAD/Final Design CAD/LiftLinkageBaseMount.SLDPRT

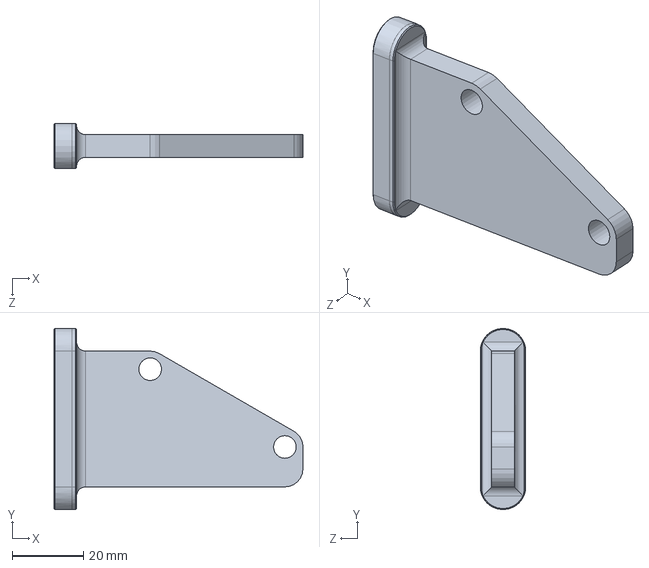
[picture p215: CAD file, 2018-04-11]
Project/CAD/Final Design CAD/LiftLinkageBaseMount.SLDPRT
69.8 x 50.8 x 12.7 mm
