andrewrichardr/MSE2202BDesignProject/Project/CAD/Prototype Assy/276-1926-005 Rev1.SLDPRT

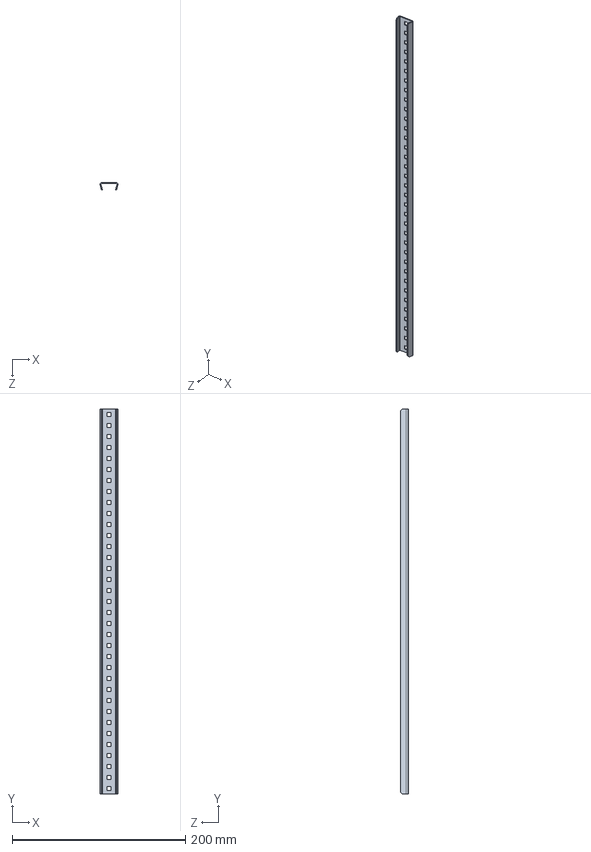
[picture p216: CAD file, 2018-04-08]
Project/CAD/Prototype Assy/276-1926-005 Rev1.SLDPRT
20.8 x 444.5 x 8.80 mm
