andrewrichardr/MSE2202BDesignProject/Project/CAD/Final Design CAD/ChassisSideCover.SLDPRT

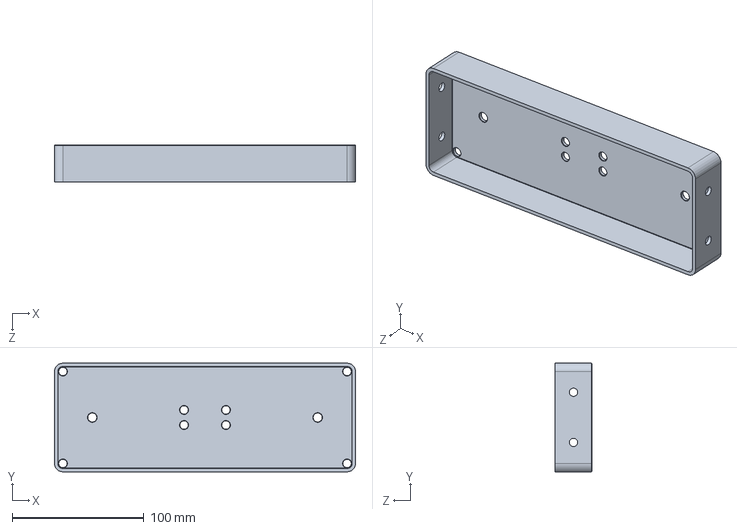
[picture p217: CAD file, 2018-04-11]
Project/CAD/Final Design CAD/ChassisSideCover.SLDPRT
228.6 x 82.5 x 27.9 mm
