andrewrichardr/MSE2202BDesignProject/Project/CAD/Prototype Assy/sprocket-hs-18-tooth.SLDPRT

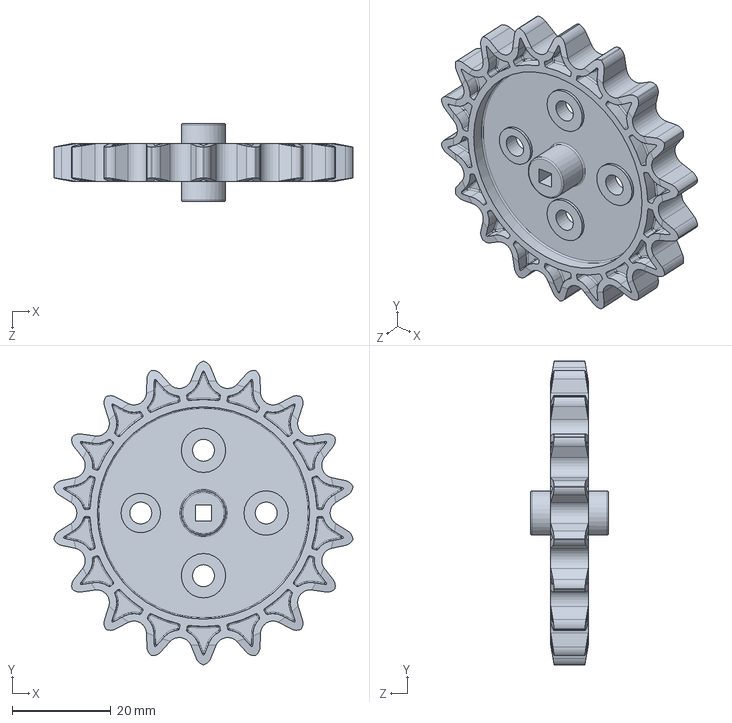
[picture p218: CAD file, 2018-04-08]
Project/CAD/Prototype Assy/sprocket-hs-18-tooth.SLDPRT
60.6 x 61.5 x 15.9 mm
