andrewrichardr/MSE2202BDesignProject/Project/CAD/Prototype CAD/CubeIntakeArm/CLAW_L.SLDPRT

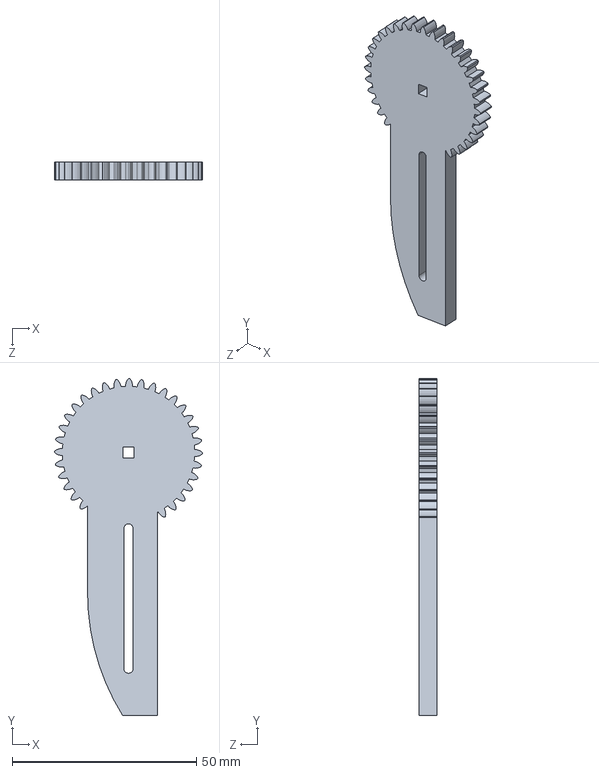
[picture p219: CAD file, 2018-04-02]
Project/CAD/Prototype CAD/CubeIntakeArm/CLAW_L.SLDPRT
40.2 x 91.5 x 4.76 mm
