andrewrichardr/MSE2202BDesignProject/Project/CAD/Prototype CAD/CubeIntakePlatform.SLDPRT

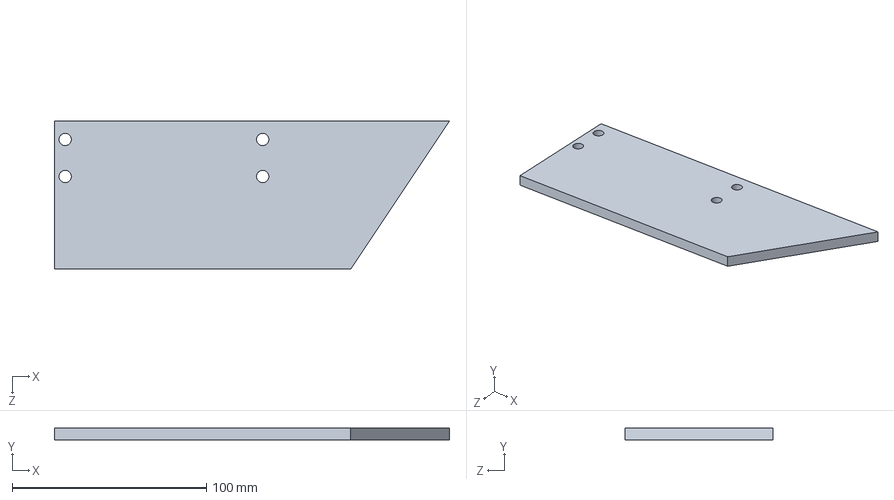
[picture p220: CAD file, 2018-03-20]
Project/CAD/Prototype CAD/CubeIntakePlatform.SLDPRT
203.2 x 6.35 x 76.2 mm
