andrewrichardr/MSE2202BDesignProject/Project/CAD/Prototype CAD/Pyramid Lift Assembly/top.SLDPRT

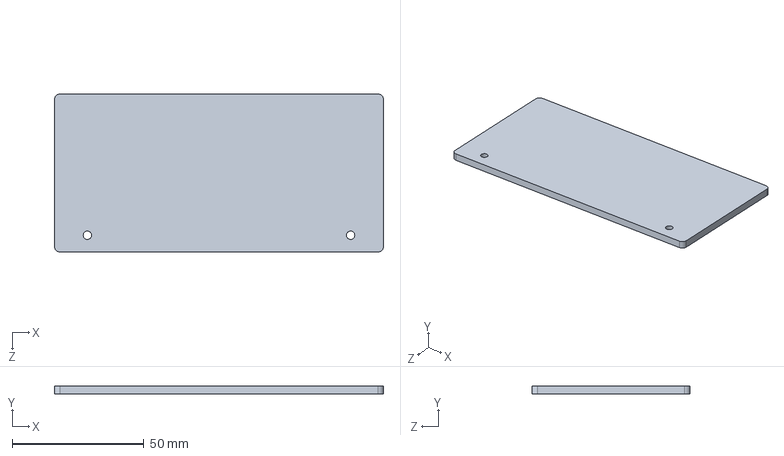
[picture p221: CAD file, 2018-04-02]
Project/CAD/Prototype CAD/Pyramid Lift Assembly/top.SLDPRT
125.0 x 3.17 x 60.0 mm
