andrewrichardr/MSE2202BDesignProject/Project/CAD/Prototype Assy/Ultrasonic_Range_Finder_276-2155.SLDPRT

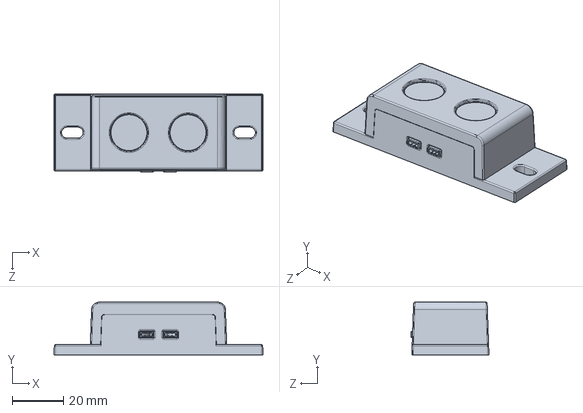
[picture p222: CAD file, 2018-04-08]
Project/CAD/Prototype Assy/Ultrasonic_Range_Finder_276-2155.SLDPRT
81.2 x 20.5 x 30.3 mm
