andrewrichardr/MSE2202BDesignProject/Project/CAD/Prototype CAD/ChassisPlatform.SLDPRT

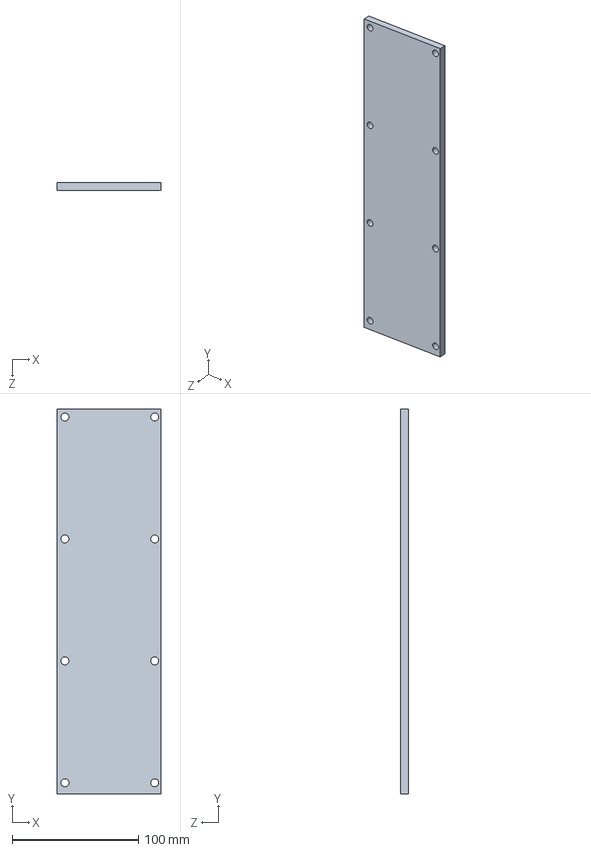
[picture p223: CAD file, 2018-03-20]
Project/CAD/Prototype CAD/ChassisPlatform.SLDPRT
82.6 x 304.8 x 6.35 mm
