andrewrichardr/MSE2202BDesignProject/Project/CAD/Prototype CAD/CubeIntakeArm/lnk4.SLDPRT

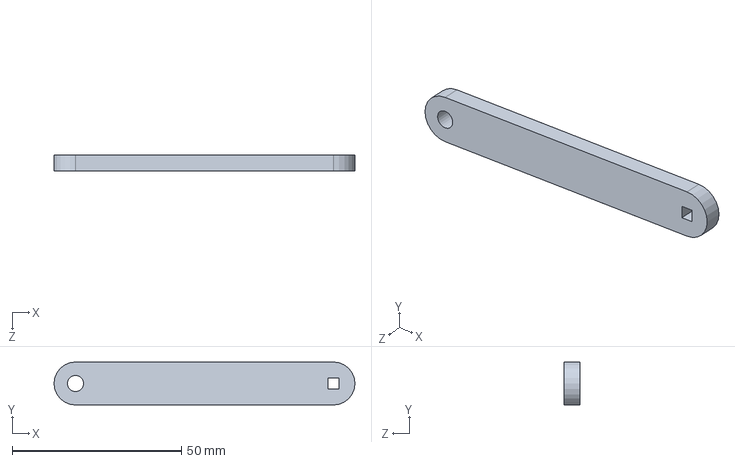
[picture p224: CAD file, 2018-04-02]
Project/CAD/Prototype CAD/CubeIntakeArm/lnk4.SLDPRT
88.9 x 12.7 x 4.76 mm
