andrewrichardr/MSE2202BDesignProject/Project/CAD/Final Design CAD/ClawRailMotorBracket.SLDPRT

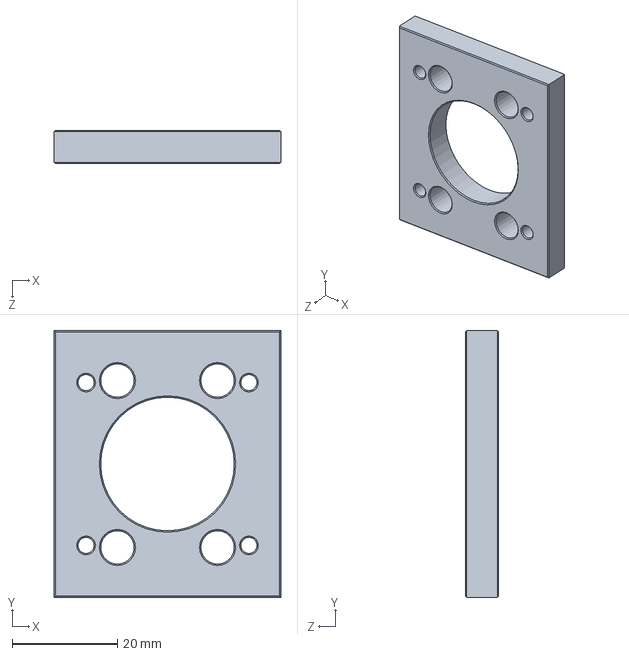
[picture p225: CAD file, 2018-04-11]
Project/CAD/Final Design CAD/ClawRailMotorBracket.SLDPRT
43.2 x 50.8 x 6.35 mm
