andrewrichardr/MSE2202BDesignProject/Project/CAD/Prototype CAD/CubeIntakeArm/CLAW.SLDPRT

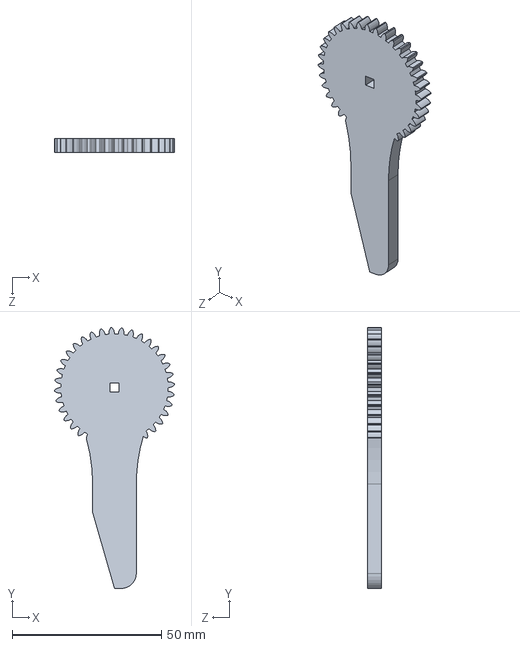
[picture p226: CAD file, 2018-04-02]
Project/CAD/Prototype CAD/CubeIntakeArm/CLAW.SLDPRT
40.2 x 87.3 x 4.76 mm
