andrewrichardr/MSE2202BDesignProject/Project/CAD/Prototype CAD/CubeIntakeSupport.SLDPRT

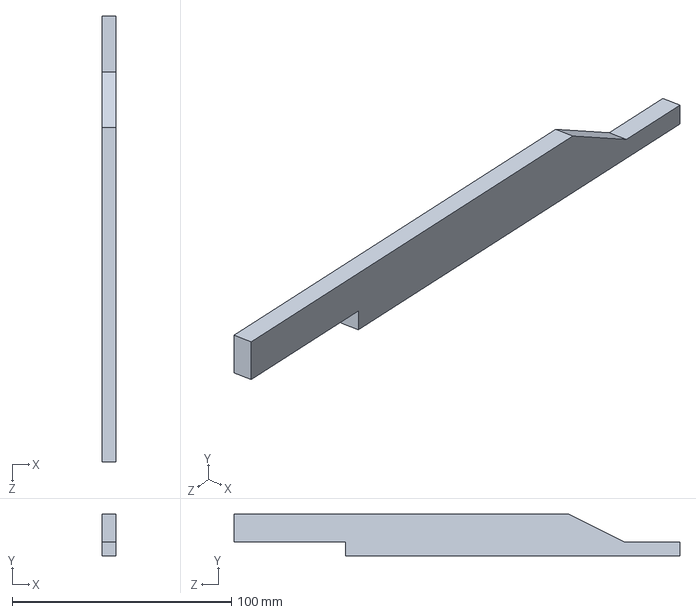
[picture p227: CAD file, 2018-03-20]
Project/CAD/Prototype CAD/CubeIntakeSupport.SLDPRT
6.35 x 19.1 x 203.2 mm
