andrewrichardr/MSE2202BDesignProject/Project/CAD/Final Design CAD/PyrIntakeMotorMount.SLDPRT

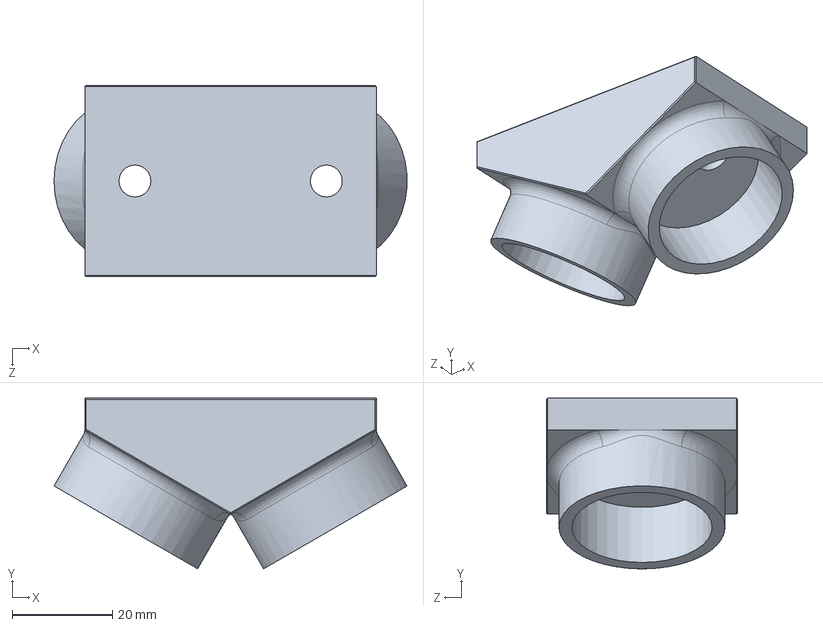
[picture p228: CAD file, 2018-04-11]
Project/CAD/Final Design CAD/PyrIntakeMotorMount.SLDPRT
70.3 x 34.0 x 38.1 mm
