andrewrichardr/MSE2202BDesignProject/Project/CAD/Prototype Assy/BaseUC.SLDPRT

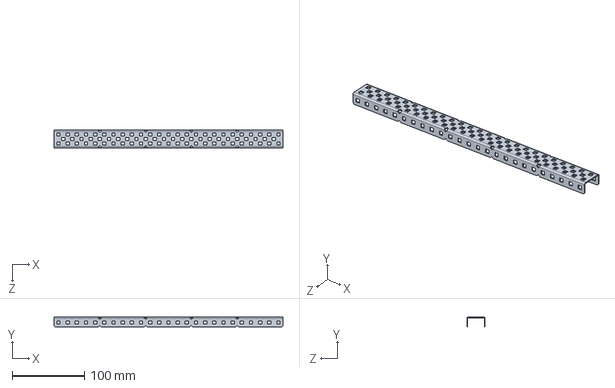
[picture p229: CAD file, 2018-04-08]
Project/CAD/Prototype Assy/BaseUC.SLDPRT
317.5 x 13.9 x 25.4 mm
