andrewrichardr/MSE2202BDesignProject/Project/CAD/Prototype CAD/Standoff2in.SLDPRT

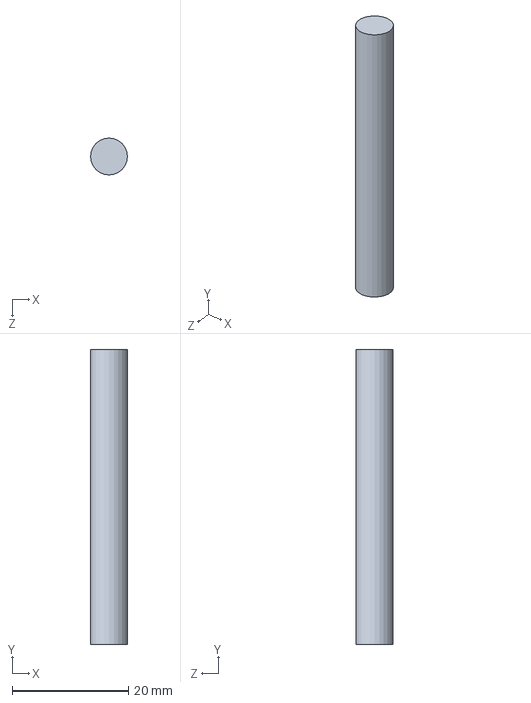
[picture p230: CAD file, 2018-03-20]
Project/CAD/Prototype CAD/Standoff2in.SLDPRT
6.35 x 50.8 x 6.35 mm
