andrewrichardr/MSE2202BDesignProject/Project/CAD/Final Design CAD/LiftLinkage.SLDPRT

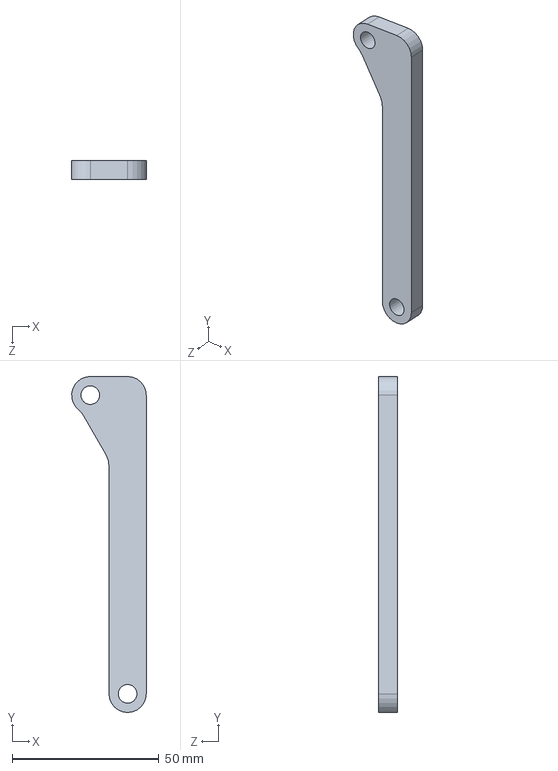
[picture p231: CAD file, 2018-04-11]
Project/CAD/Final Design CAD/LiftLinkage.SLDPRT
25.4 x 114.3 x 6.35 mm
