andrewrichardr/MSE2202BDesignProject/Project/CAD/Prototype Assy/VEX-12-TOOTH-GEAR.SLDPRT

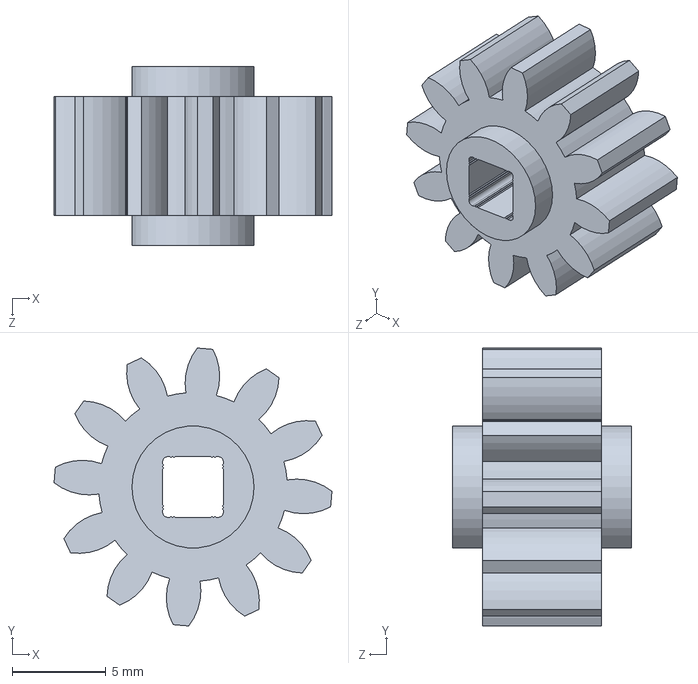
[picture p232: CAD file, 2018-04-08]
Project/CAD/Prototype Assy/VEX-12-TOOTH-GEAR.SLDPRT
14.8 x 14.8 x 9.53 mm
