andrewrichardr/MSE2202BDesignProject/Project/CAD/Prototype CAD/CubeIntakeArm/lnk2.SLDPRT

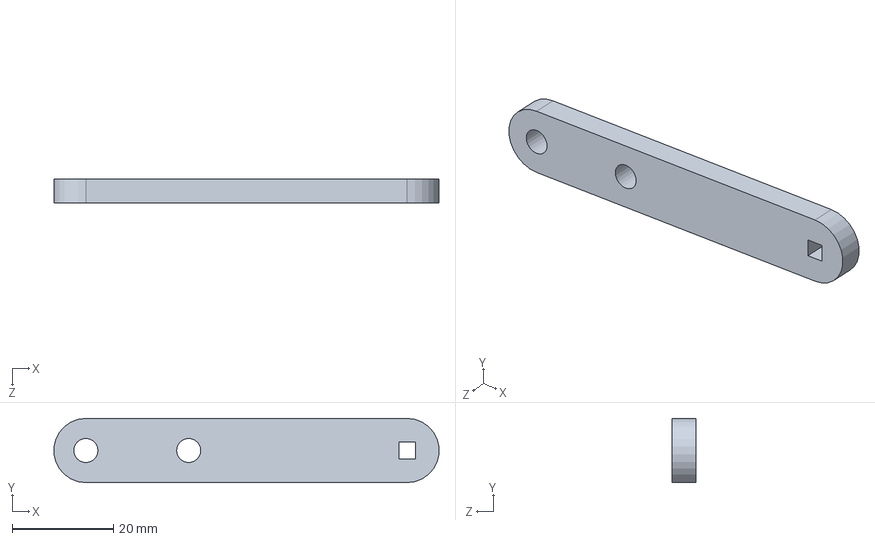
[picture p233: CAD file, 2018-04-02]
Project/CAD/Prototype CAD/CubeIntakeArm/lnk2.SLDPRT
76.1 x 12.7 x 4.76 mm
