andrewrichardr/MSE2202BDesignProject/Project/CAD/Final Design CAD/ClawMount.SLDPRT

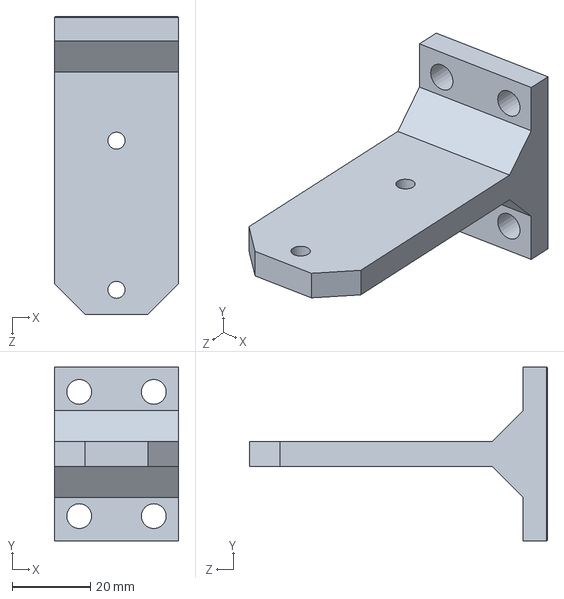
[picture p234: CAD file, 2018-04-11]
Project/CAD/Final Design CAD/ClawMount.SLDPRT
31.8 x 44.5 x 76.2 mm
