andrewrichardr/MSE2202BDesignProject/Project/CAD/Prototype Assy/VEX-60-TOOTH-GEAR.SLDPRT

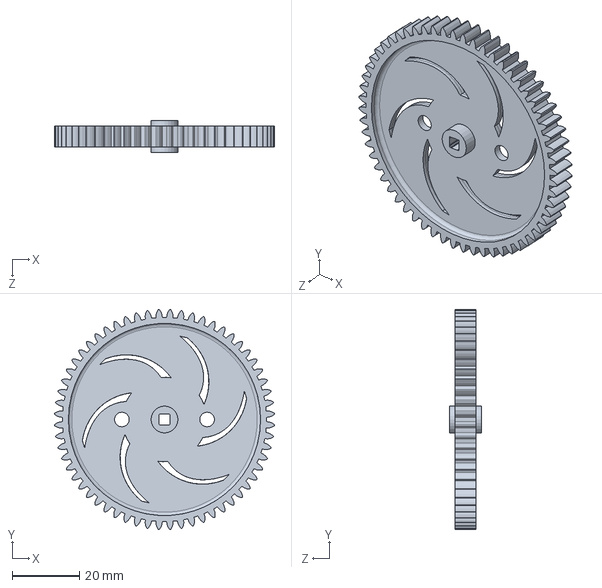
[picture p235: CAD file, 2018-04-08]
Project/CAD/Prototype Assy/VEX-60-TOOTH-GEAR.SLDPRT
65.5 x 65.5 x 9.53 mm
