andrewrichardr/MSE2202BDesignProject/Project/CAD/Prototype CAD/24-tooth-sprocket.SLDPRT

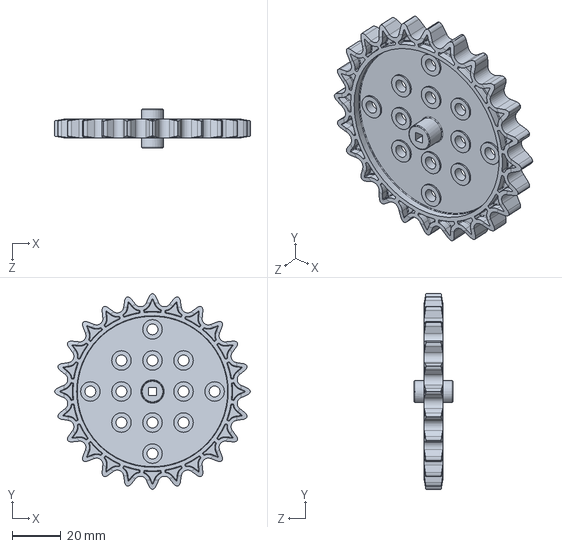
[picture p236: CAD file, 2018-03-16]
Project/CAD/Prototype CAD/24-tooth-sprocket.SLDPRT
80.1 x 80.1 x 15.9 mm
