andrewrichardr/MSE2202BDesignProject/Project/CAD/Final Design CAD/PyrIntakeAngledMount.SLDPRT

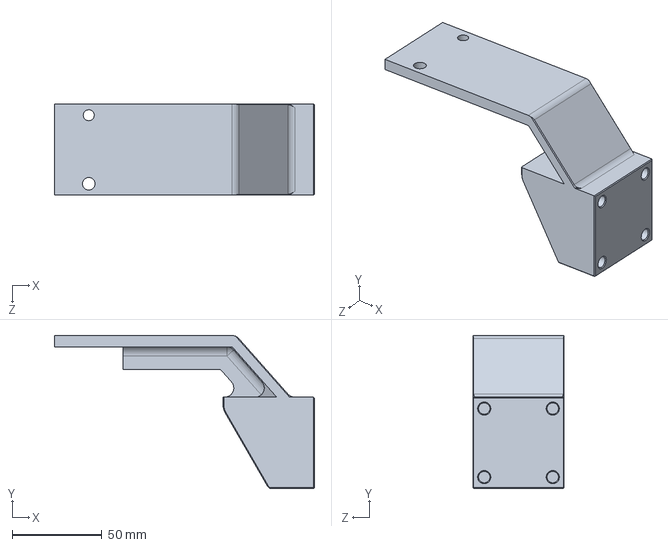
[picture p237: CAD file, 2018-04-11]
Project/CAD/Final Design CAD/PyrIntakeAngledMount.SLDPRT
144.5 x 85.1 x 50.8 mm
