andrewrichardr/MSE2202BDesignProject/Project/CAD/Prototype Assy/ramp.SLDPRT

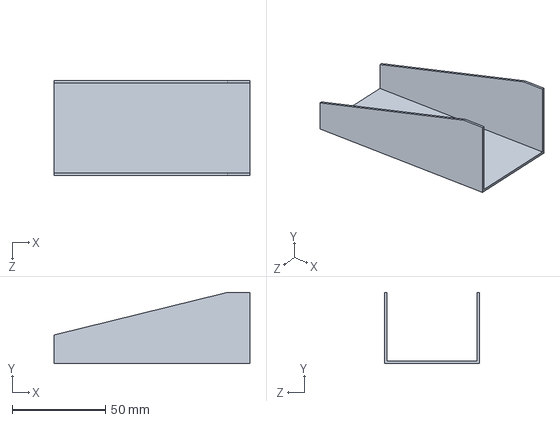
[picture p238: CAD file, 2018-04-08]
Project/CAD/Prototype Assy/ramp.SLDPRT
104.9 x 38.1 x 50.8 mm
