andrewrichardr/MSE2202BDesignProject/Project/CAD/Prototype CAD/CubeIntakeArm/lnk5.SLDPRT

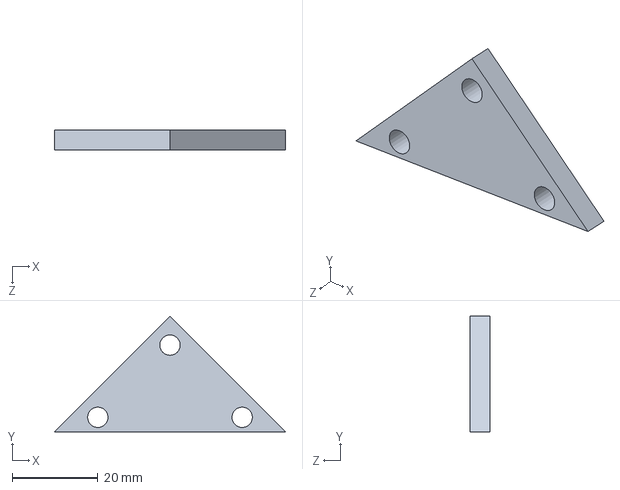
[picture p239: CAD file, 2018-04-02]
Project/CAD/Prototype CAD/CubeIntakeArm/lnk5.SLDPRT
53.9 x 26.9 x 4.76 mm
