andrewrichardr/MSE2202BDesignProject/Project/CAD/Prototype CAD/sidebar.SLDPRT

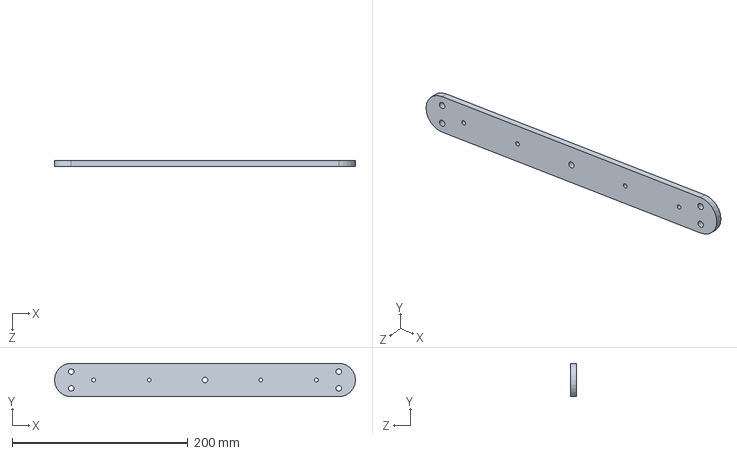
[picture p240: CAD file, 2018-03-16]
Project/CAD/Prototype CAD/sidebar.SLDPRT
342.9 x 38.1 x 6.35 mm
