andrewrichardr/MSE2202BDesignProject/Project/CAD/Final Design CAD/PyrIntakeBacking.SLDPRT

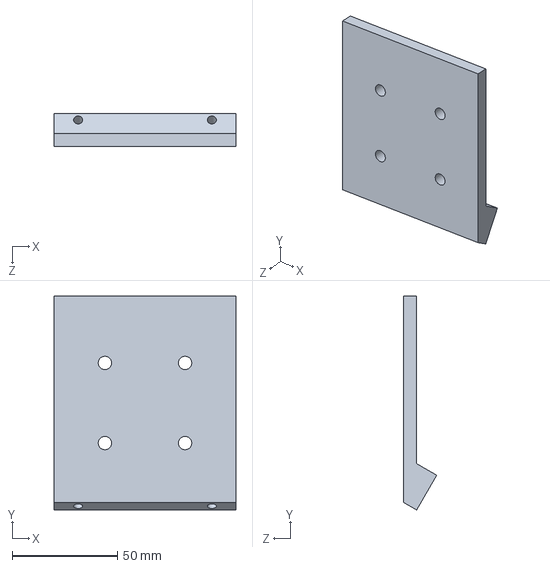
[picture p241: CAD file, 2018-04-11]
Project/CAD/Final Design CAD/PyrIntakeBacking.SLDPRT
86.4 x 101.6 x 15.9 mm
