andrewrichardr/MSE2202BDesignProject/Project/CAD/Prototype Assy/VEX-36-TOOTH-GEAR.SLDPRT

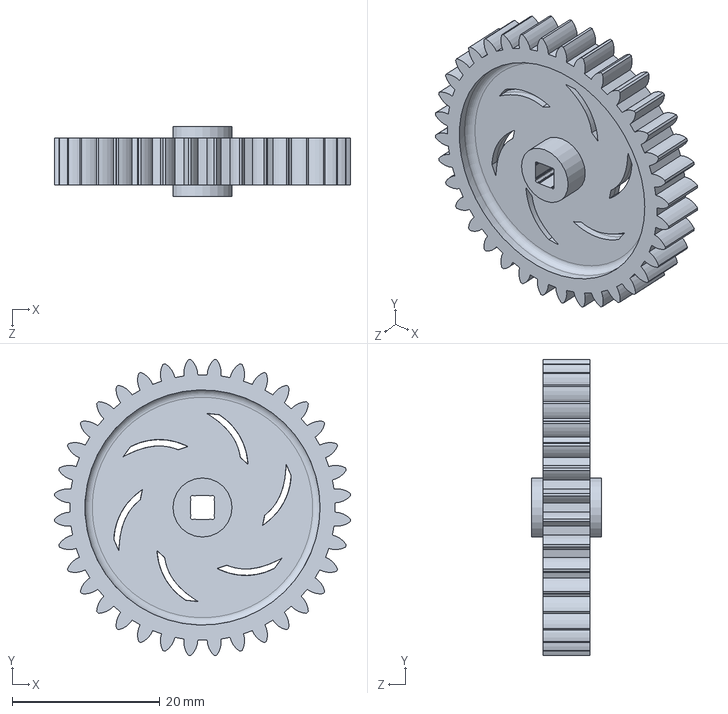
[picture p242: CAD file, 2018-04-08]
Project/CAD/Prototype Assy/VEX-36-TOOTH-GEAR.SLDPRT
40.1 x 40.1 x 9.53 mm
