andrewrichardr/MSE2202BDesignProject/Project/CAD/Prototype CAD/CubeIntakeArm/lnk1.SLDPRT

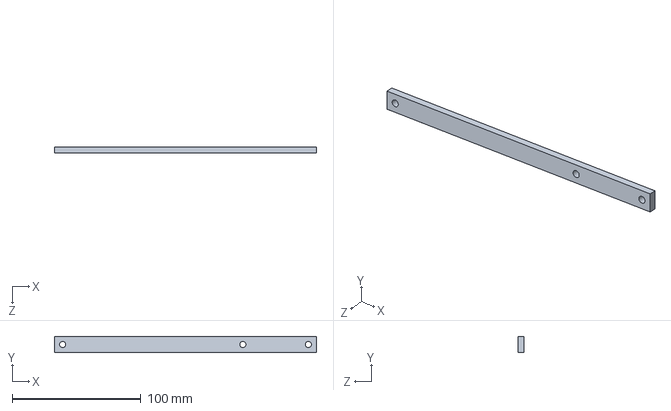
[picture p243: CAD file, 2018-04-02]
Project/CAD/Prototype CAD/CubeIntakeArm/lnk1.SLDPRT
203.2 x 12.7 x 4.76 mm
