andrewrichardr/MSE2202BDesignProject/Project/CAD/Prototype CAD/Rod.SLDPRT

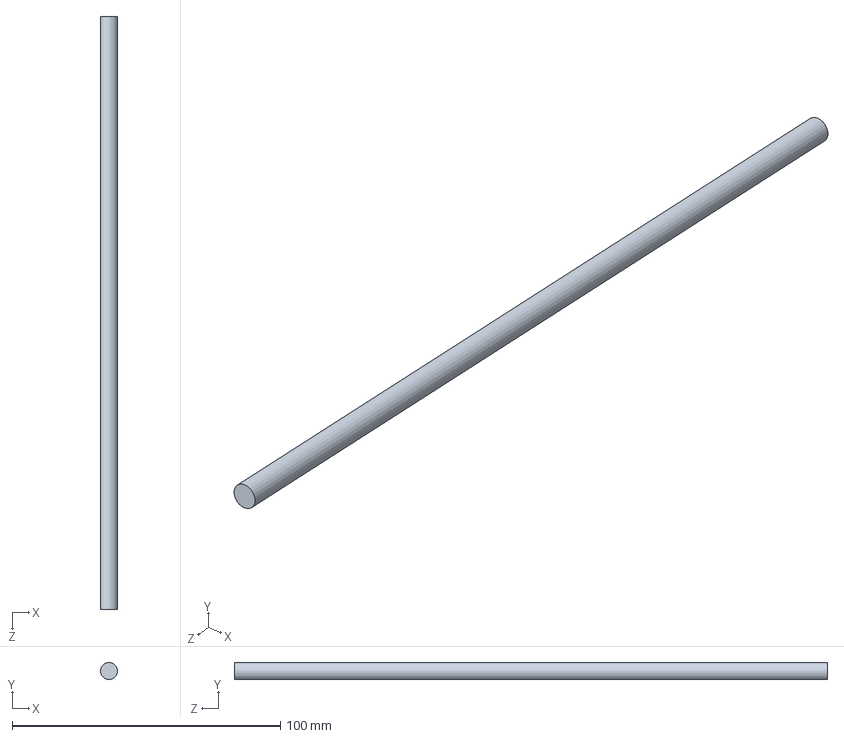
[picture p244: CAD file, 2018-03-16]
Project/CAD/Prototype CAD/Rod.SLDPRT
6.35 x 6.35 x 221.0 mm
