andrewrichardr/MSE2202BDesignProject/Project/CAD/Final Design CAD/ClawArmBearingMount.SLDPRT

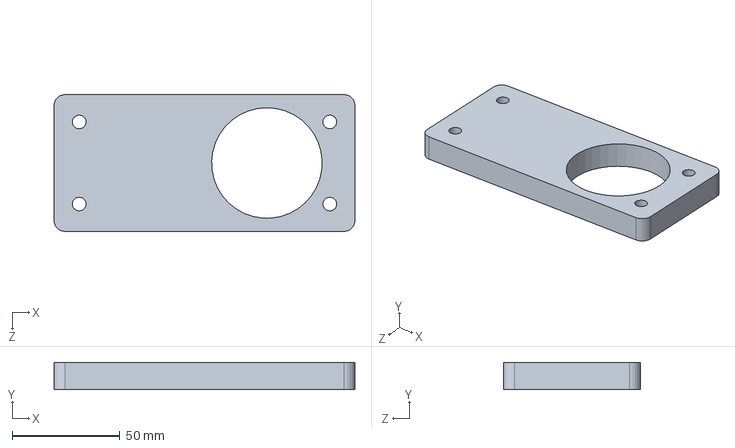
[picture p245: CAD file, 2018-04-11]
Project/CAD/Final Design CAD/ClawArmBearingMount.SLDPRT
139.7 x 12.7 x 63.5 mm
