andrewrichardr/MSE2202BDesignProject/Project/CAD/Prototype Assy/VL-RACK-BRK RevA.SLDPRT

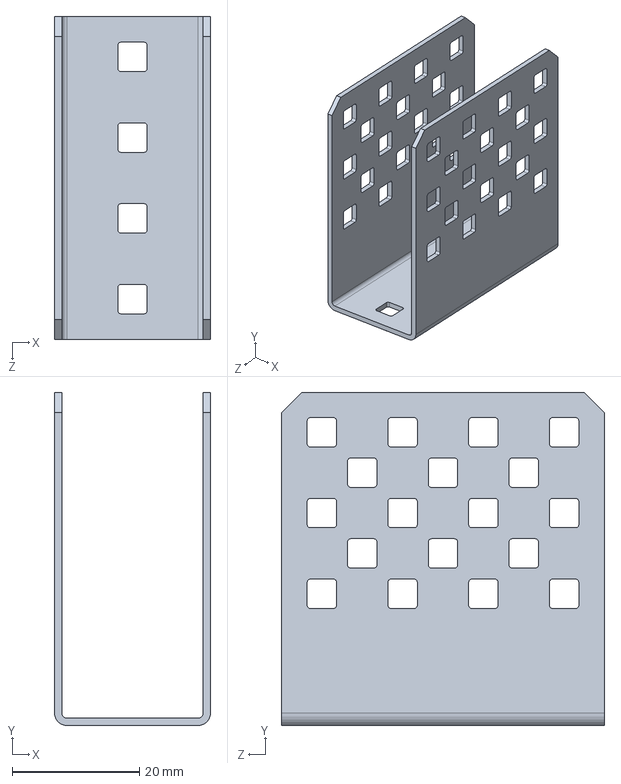
[picture p246: CAD file, 2018-04-07]
Project/CAD/Prototype Assy/VL-RACK-BRK RevA.SLDPRT
24.6 x 52.4 x 50.8 mm
