andrewrichardr/MSE2202BDesignProject/Project/CAD/Prototype CAD/6-tooth-sprocket.SLDPRT

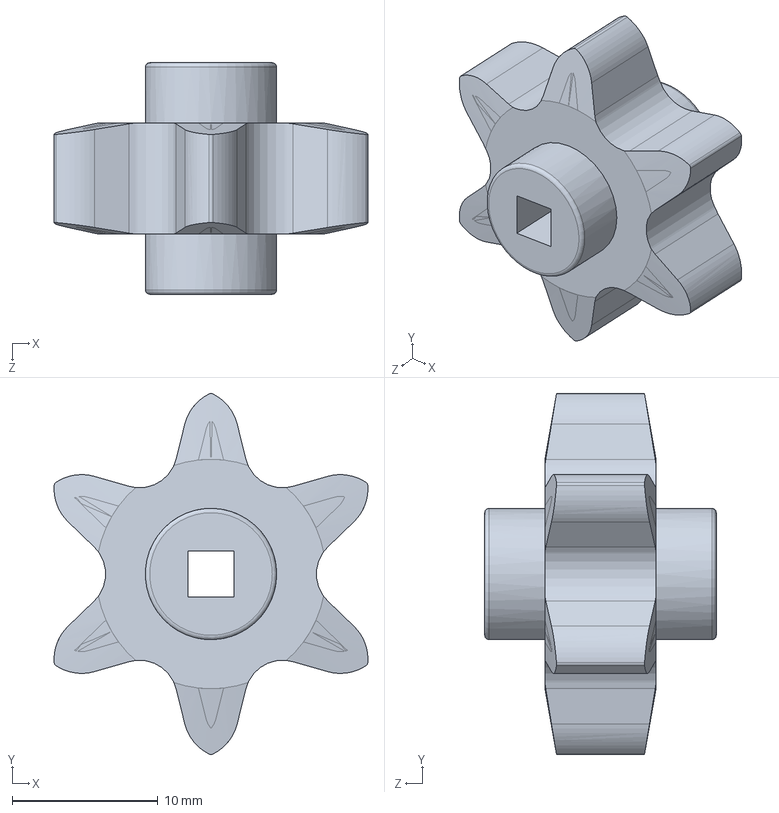
[picture p247: CAD file, 2018-03-16]
Project/CAD/Prototype CAD/6-tooth-sprocket.SLDPRT
21.5 x 24.7 x 15.9 mm
