andrewrichardr/MSE2202BDesignProject/Project/CAD/Prototype CAD/CubeIntakeArm/CLAW_Rb.SLDPRT

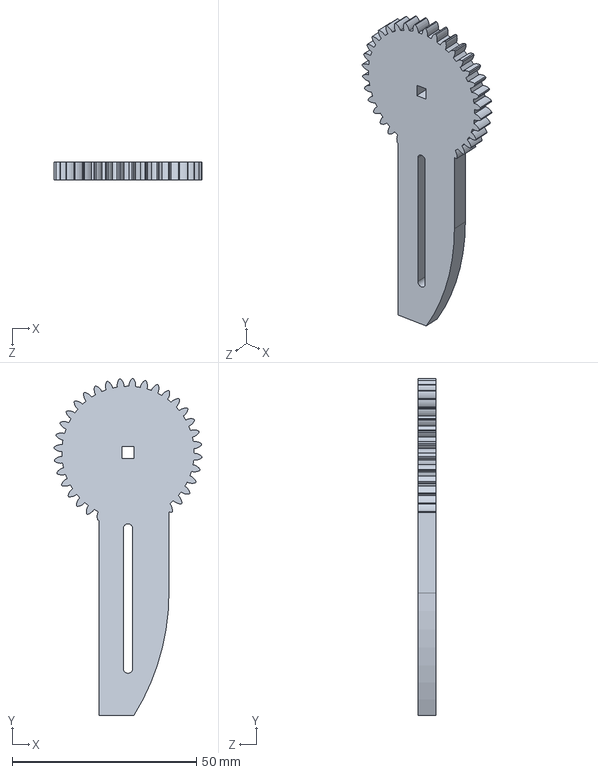
[picture p248: CAD file, 2018-04-02]
Project/CAD/Prototype CAD/CubeIntakeArm/CLAW_Rb.SLDPRT
40.1 x 91.5 x 4.76 mm
