andrewrichardr/MSE2202BDesignProject/Project/CAD/Final Design CAD/ArmRotate.SLDPRT

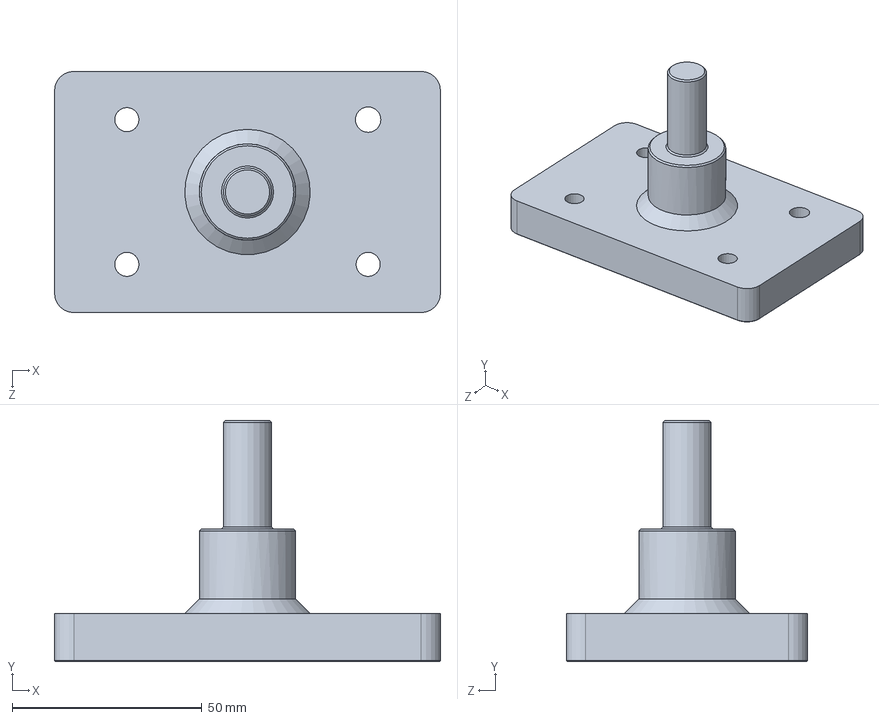
[picture p249: CAD file, 2018-04-11]
Project/CAD/Final Design CAD/ArmRotate.SLDPRT
101.6 x 63.5 x 63.5 mm
