andrewrichardr/MSE2202BDesignProject/Project/CAD/Prototype Assy/276-1926-004 Rev1.SLDPRT

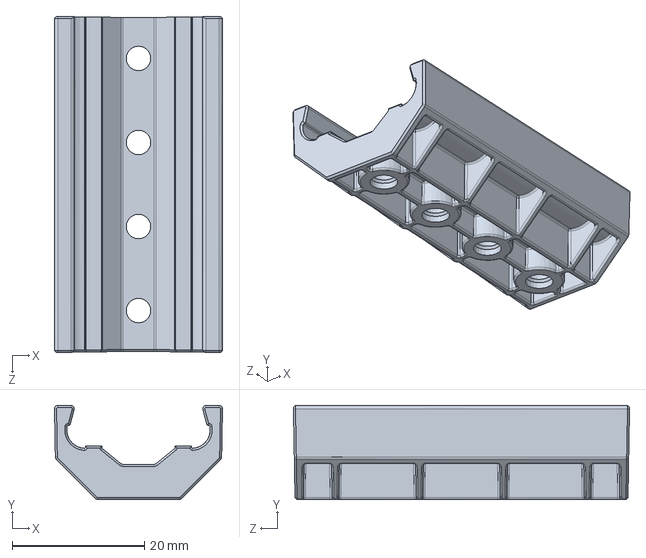
[picture p250: CAD file, 2018-04-07]
Project/CAD/Prototype Assy/276-1926-004 Rev1.SLDPRT
25.4 x 14.2 x 50.8 mm
