andrewrichardr/MSE2202BDesignProject/Project/CAD/Final Design CAD/PyrIntakeLinkageRod.SLDPRT

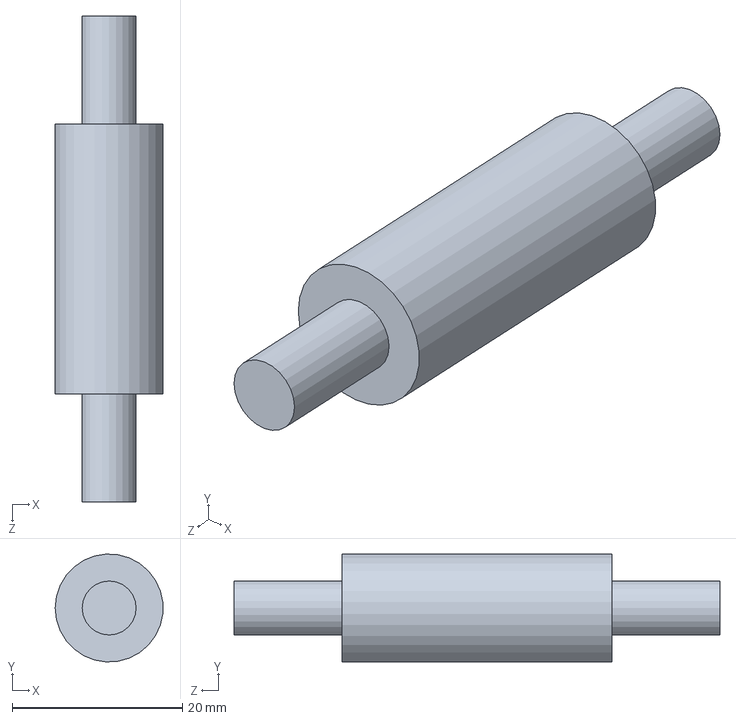
[picture p251: CAD file, 2018-04-11]
Project/CAD/Final Design CAD/PyrIntakeLinkageRod.SLDPRT
12.7 x 12.7 x 57.1 mm
