andrewrichardr/MSE2202BDesignProject/Project/CAD/Prototype Assy/276-1926-001 Rev1.SLDPRT

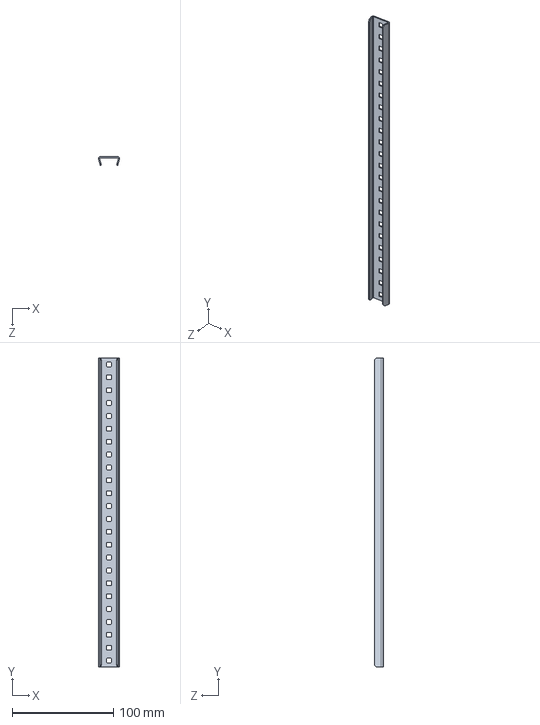
[picture p252: CAD file, 2018-04-07]
Project/CAD/Prototype Assy/276-1926-001 Rev1.SLDPRT
20.8 x 304.8 x 8.80 mm
