andrewrichardr/MSE2202BDesignProject/Project/CAD/Prototype CAD/CubeIntakeArm/lnk3.SLDPRT

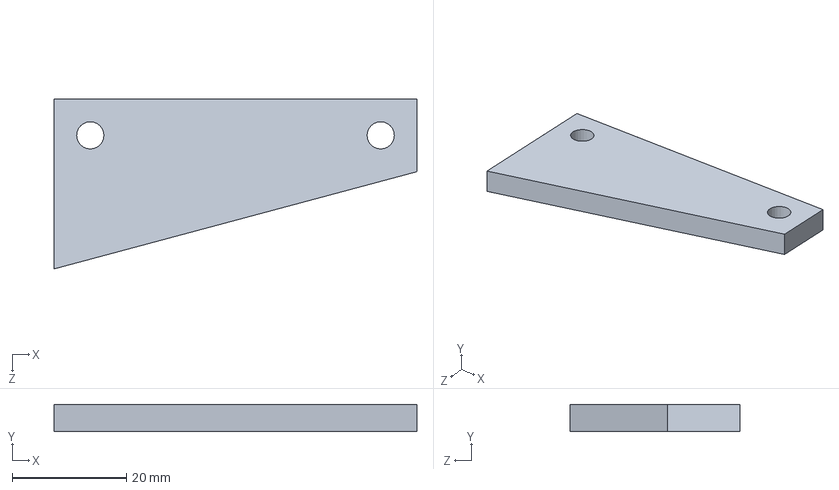
[picture p253: CAD file, 2018-04-02]
Project/CAD/Prototype CAD/CubeIntakeArm/lnk3.SLDPRT
63.5 x 4.76 x 29.7 mm
