andrewrichardr/MSE2202BDesignProject/Project/CAD/Prototype CAD/DRIVE-WHEEL.SLDPRT

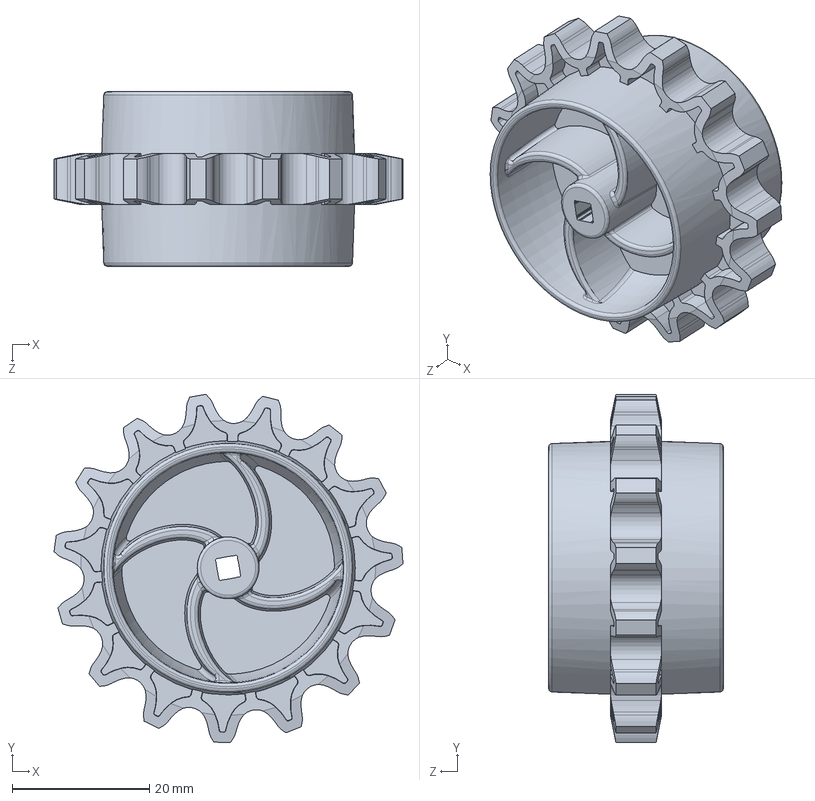
[picture p254: CAD file, 2018-03-14]
Project/CAD/Prototype CAD/DRIVE-WHEEL.SLDPRT
50.8 x 50.7 x 25.4 mm
