andrewrichardr/MSE2202BDesignProject/Project/CAD/Final Design CAD/SideSensorMount.SLDPRT

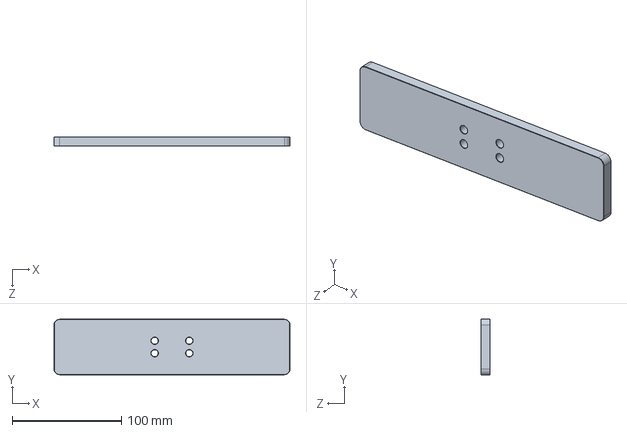
[picture p255: CAD file, 2018-04-11]
Project/CAD/Final Design CAD/SideSensorMount.SLDPRT
215.9 x 50.8 x 8.38 mm
