andrewrichardr/MSE2202BDesignProject/Project/CAD/Prototype Assy/276-1926-002 Rev1.SLDPRT

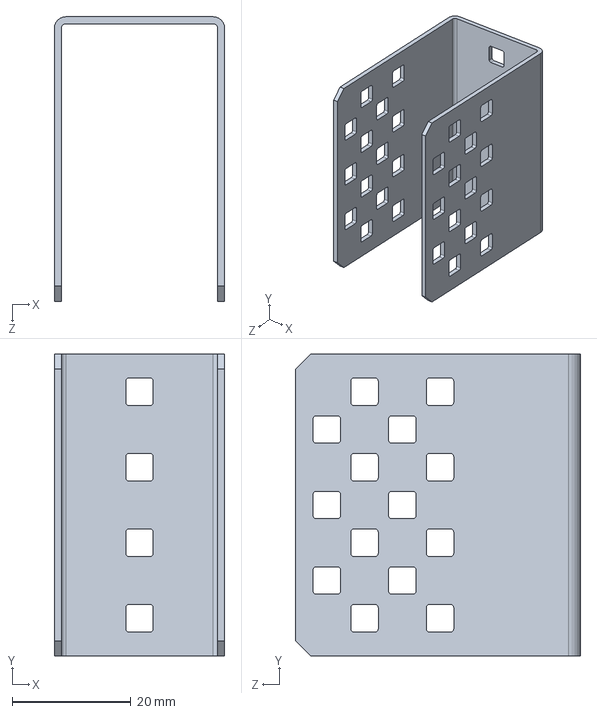
[picture p256: CAD file, 2018-04-07]
Project/CAD/Prototype Assy/276-1926-002 Rev1.SLDPRT
28.7 x 50.8 x 47.9 mm
