andrewrichardr/MSE2202BDesignProject/Project/CAD/Final Design CAD/RackStand.SLDPRT

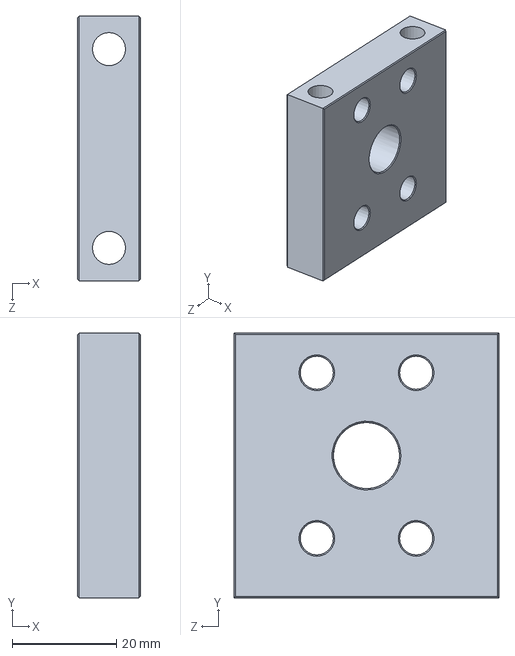
[picture p257: CAD file, 2018-04-11]
Project/CAD/Final Design CAD/RackStand.SLDPRT
12.0 x 50.8 x 50.8 mm
