andrewrichardr/MSE2202BDesignProject/Project/CAD/Final Design CAD/CubeArmMountBracket.SLDPRT

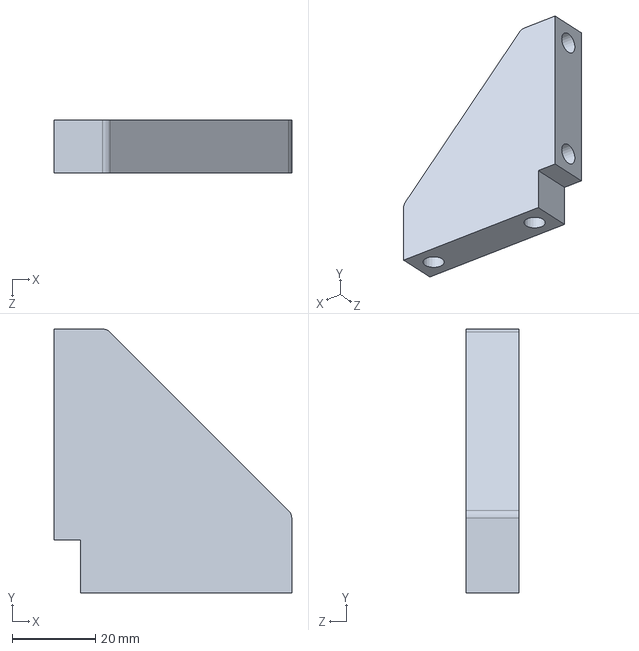
[picture p258: CAD file, 2018-04-11]
Project/CAD/Final Design CAD/CubeArmMountBracket.SLDPRT
57.1 x 63.5 x 12.7 mm
