andrewrichardr/MSE2202BDesignProject/Project/CAD/Prototype Assy/BEAM-1500.SLDPRT

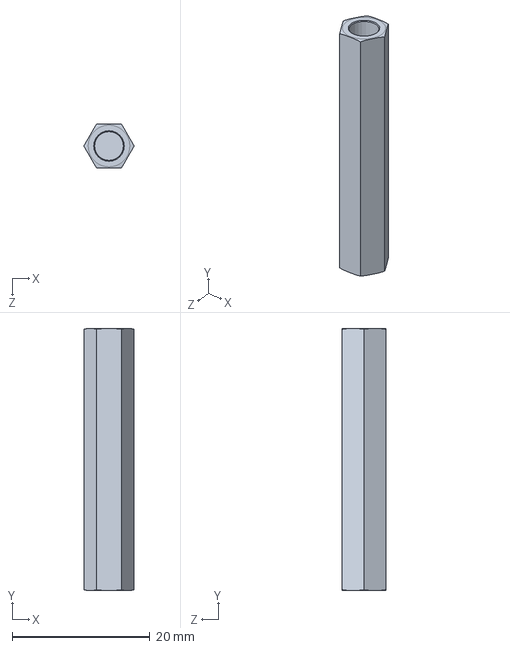
[picture p259: CAD file, 2018-04-07]
Project/CAD/Prototype Assy/BEAM-1500.SLDPRT
7.33 x 38.1 x 6.35 mm
