andrewrichardr/MSE2202BDesignProject/Project/CAD/Prototype CAD/Base-Link.SLDPRT

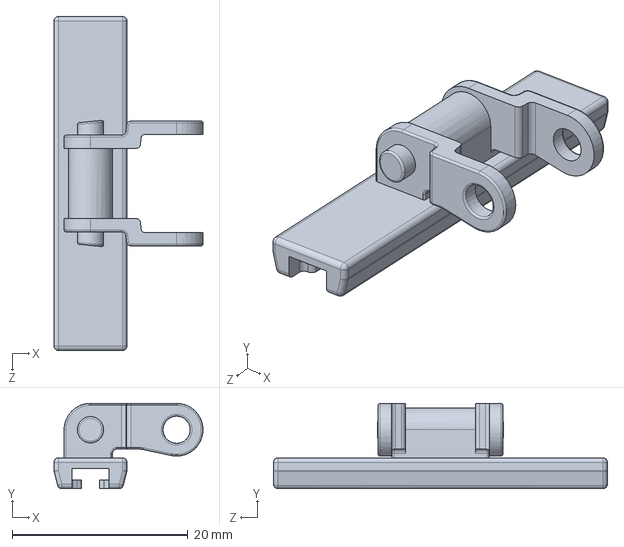
[picture p260: CAD file, 2018-03-14]
Project/CAD/Prototype CAD/Base-Link.SLDPRT
17.0 x 9.70 x 38.0 mm
