andrewrichardr/MSE2202BDesignProject/Project/CAD/Final Design CAD/ClawWormCoupler.SLDPRT

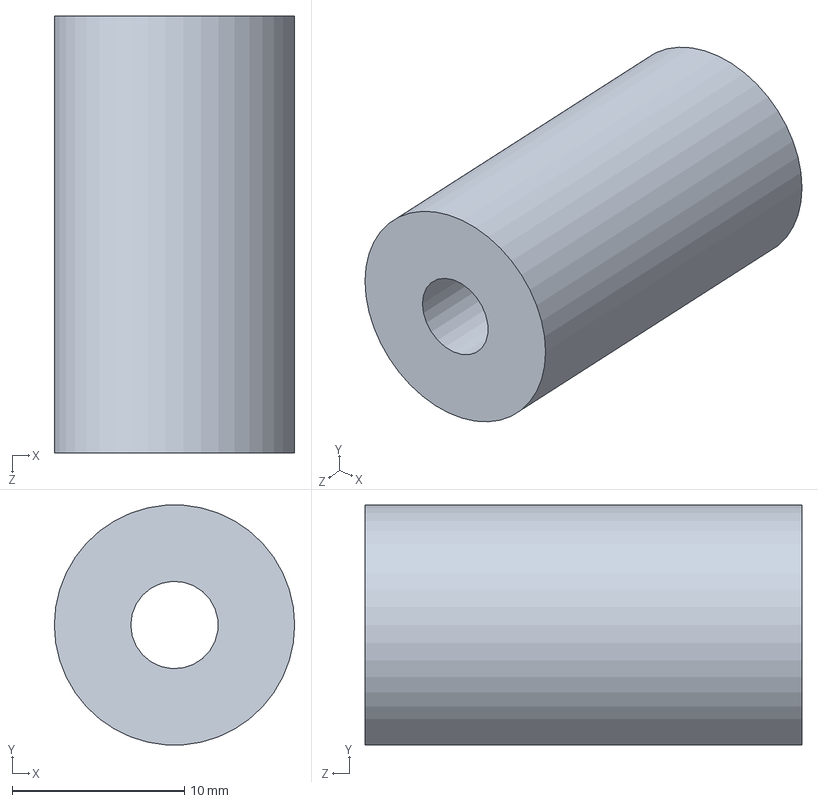
[picture p261: CAD file, 2018-04-11]
Project/CAD/Final Design CAD/ClawWormCoupler.SLDPRT
14.0 x 13.9 x 25.4 mm
