andrewrichardr/MSE2202BDesignProject/Project/CAD/Final Design CAD/RotationBushing.SLDPRT

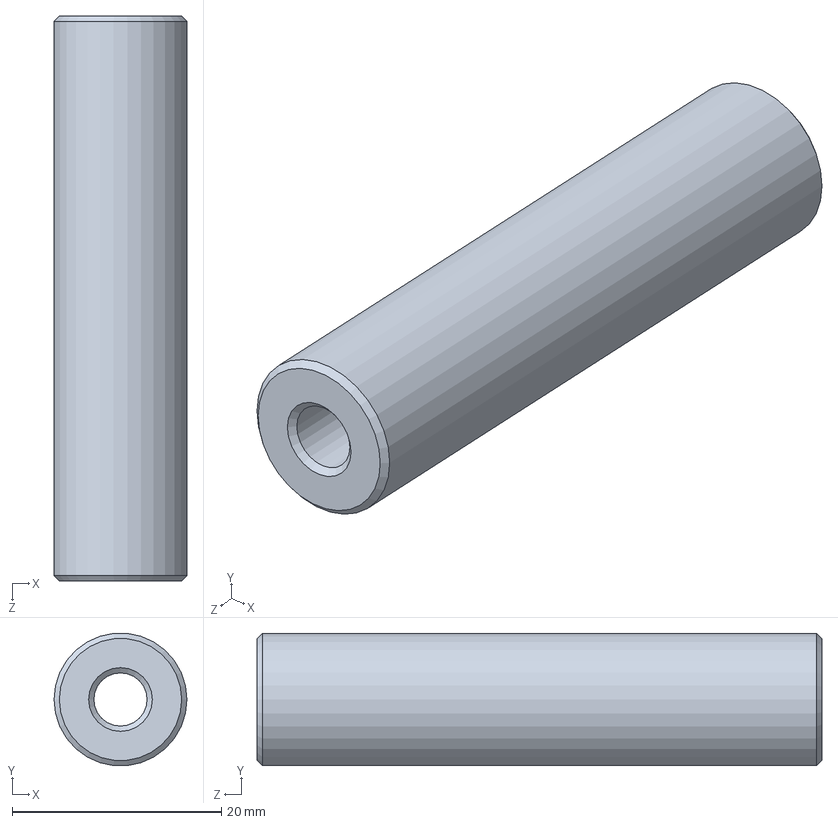
[picture p262: CAD file, 2018-04-11]
Project/CAD/Final Design CAD/RotationBushing.SLDPRT
12.7 x 12.6 x 54.0 mm
