andrewrichardr/MSE2202BDesignProject/Project/CAD/Prototype Assy/SHAFT-4000.SLDPRT

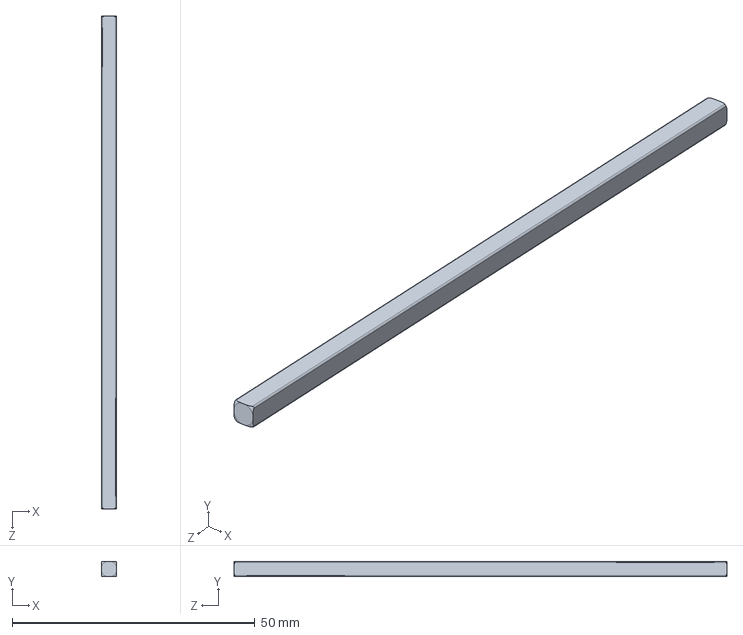
[picture p263: CAD file, 2018-04-07]
Project/CAD/Prototype Assy/SHAFT-4000.SLDPRT
3.17 x 3.17 x 101.6 mm
