andrewrichardr/MSE2202BDesignProject/Project/CAD/Final Design CAD/ClawBracket.SLDPRT

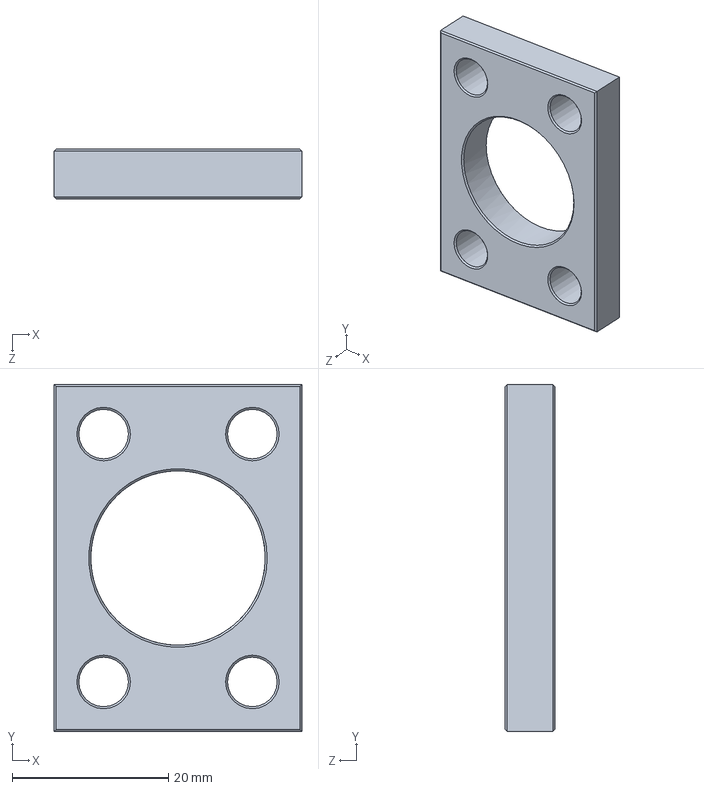
[picture p264: CAD file, 2018-04-11]
Project/CAD/Final Design CAD/ClawBracket.SLDPRT
31.8 x 44.5 x 6.35 mm
