andrewrichardr/MSE2202BDesignProject/Project/CAD/Prototype Assy/BEAM-4000.SLDPRT

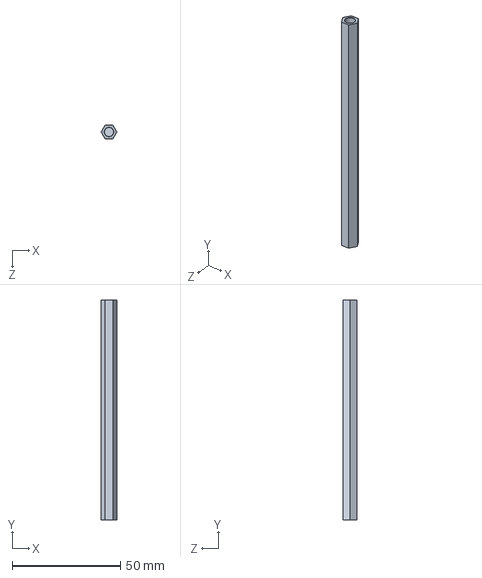
[picture p265: CAD file, 2018-04-07]
Project/CAD/Prototype Assy/BEAM-4000.SLDPRT
7.33 x 101.6 x 6.35 mm
