andrewrichardr/MSE2202BDesignProject/Project/CAD/Final Design CAD/Wheel_Bushing.SLDPRT

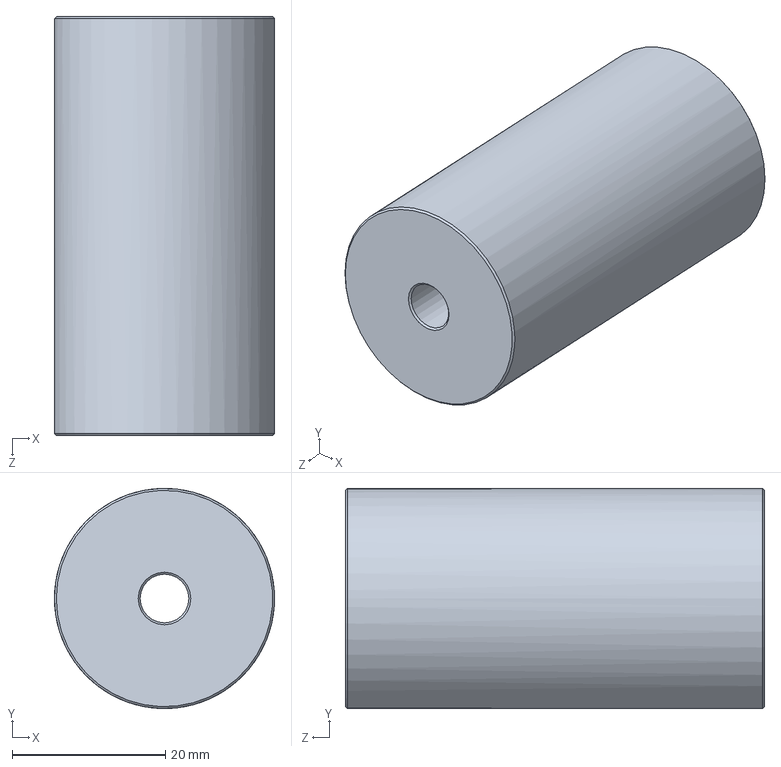
[picture p266: CAD file, 2018-04-11]
Project/CAD/Final Design CAD/Wheel_Bushing.SLDPRT
28.7 x 28.7 x 54.6 mm
