andrewrichardr/MSE2202BDesignProject/Project/CAD/Prototype Assy/BEAM-2000.SLDPRT

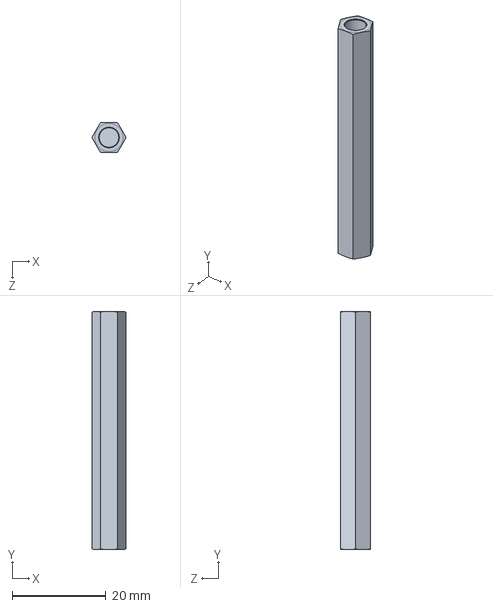
[picture p267: CAD file, 2018-04-07]
Project/CAD/Prototype Assy/BEAM-2000.SLDPRT
7.33 x 50.8 x 6.35 mm
