andrewrichardr/MSE2202BDesignProject/Project/CAD/Final Design CAD/ChassisSidePlate.SLDPRT

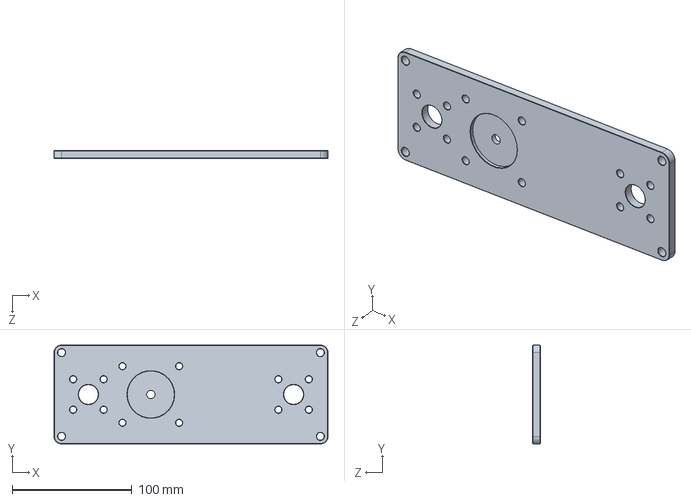
[picture p268: CAD file, 2018-04-10]
Project/CAD/Final Design CAD/ChassisSidePlate.SLDPRT
228.6 x 82.5 x 6.35 mm
