andrewrichardr/MSE2202BDesignProject/Project/CAD/Final Design CAD/ChassisMotorHousing.SLDPRT

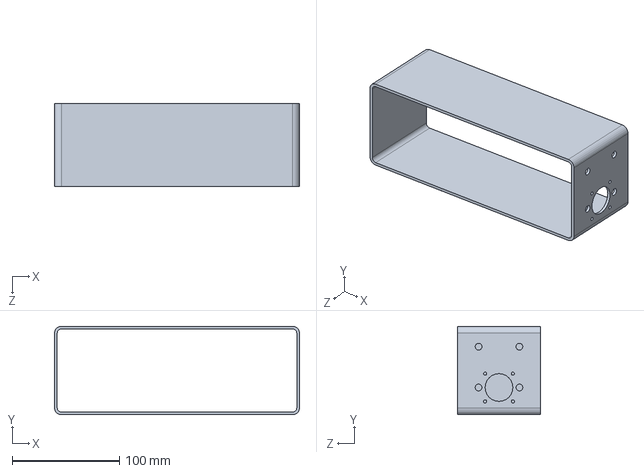
[picture p269: CAD file, 2018-04-10]
Project/CAD/Final Design CAD/ChassisMotorHousing.SLDPRT
228.6 x 82.5 x 77.5 mm
