andrewrichardr/MSE2202BDesignProject/Project/CAD/Prototype Assy/BEAM-3000.SLDPRT

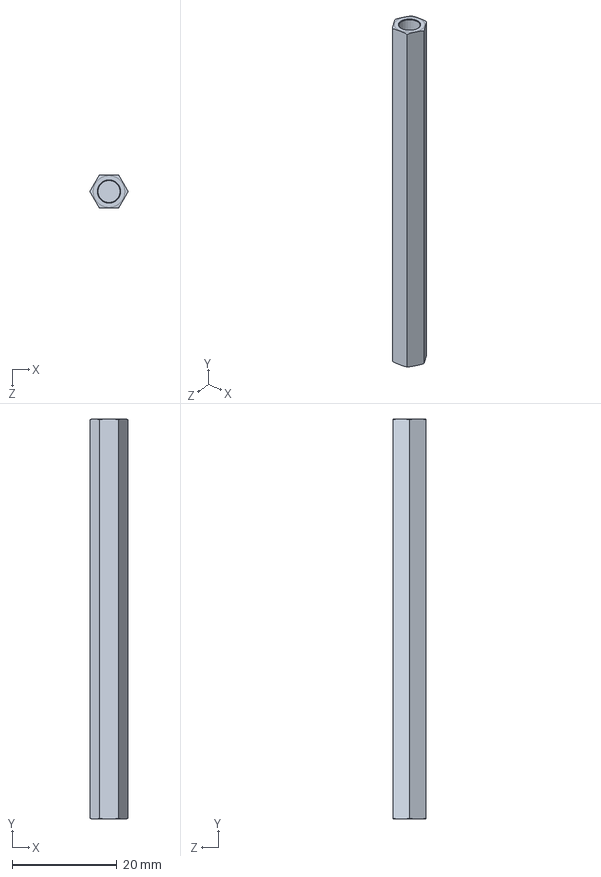
[picture p270: CAD file, 2018-04-07]
Project/CAD/Prototype Assy/BEAM-3000.SLDPRT
7.33 x 76.2 x 6.35 mm
