andrewrichardr/MSE2202BDesignProject/Project/CAD/Prototype Assy/BEARING-FLAT.SLDPRT

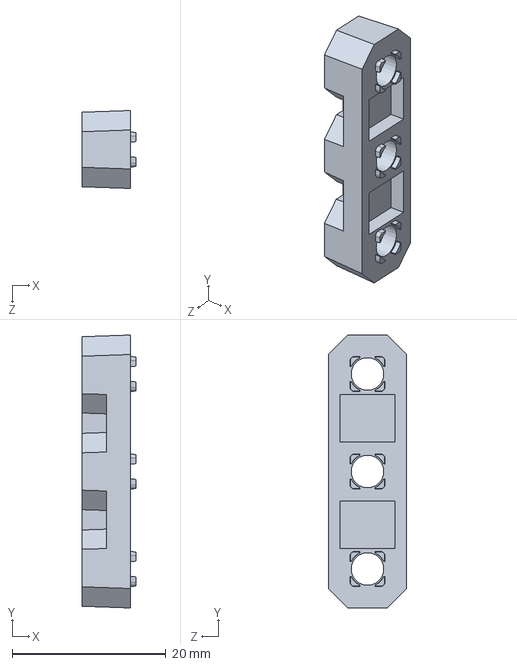
[picture p271: CAD file, 2018-04-07]
Project/CAD/Prototype Assy/BEARING-FLAT.SLDPRT
7.04 x 35.6 x 10.2 mm
