andrewrichardr/MSE2202BDesignProject/Project/CAD/Prototype CAD/CubeIntakePlate.SLDPRT

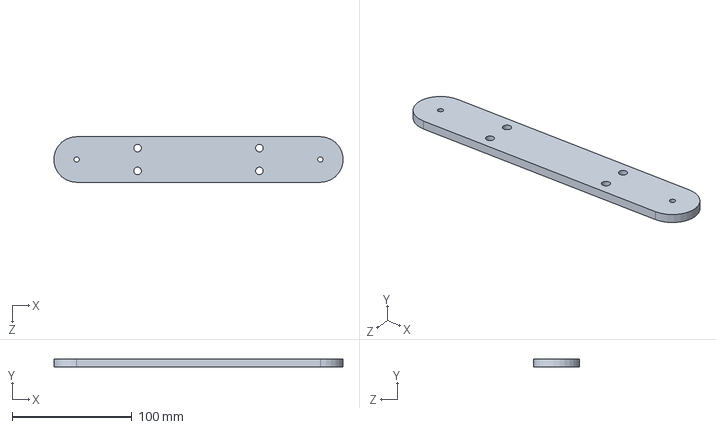
[picture p272: CAD file, 2018-03-14]
Project/CAD/Prototype CAD/CubeIntakePlate.SLDPRT
241.0 x 6.35 x 38.1 mm
