andrewrichardr/MSE2202BDesignProject/Project/CAD/Prototype CAD/collar.SLDPRT

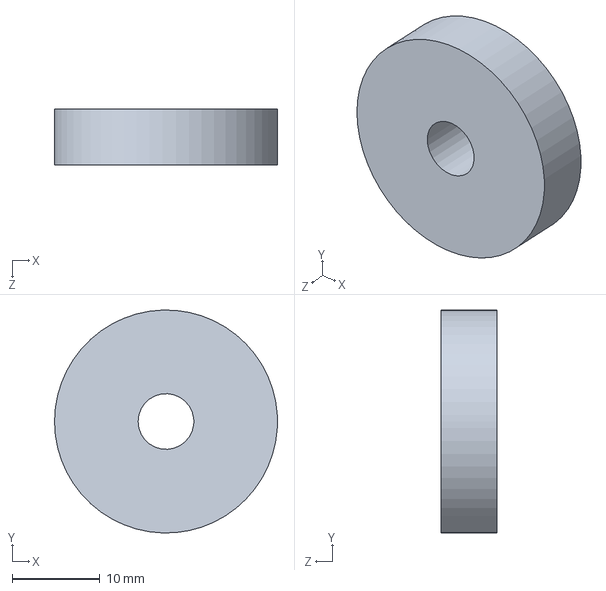
[picture p273: CAD file, 2018-03-14]
Project/CAD/Prototype CAD/collar.SLDPRT
25.4 x 25.4 x 6.35 mm
