andrewrichardr/MSE2202BDesignProject/Project/CAD/Final Design CAD/SideSensorEntension.SLDPRT

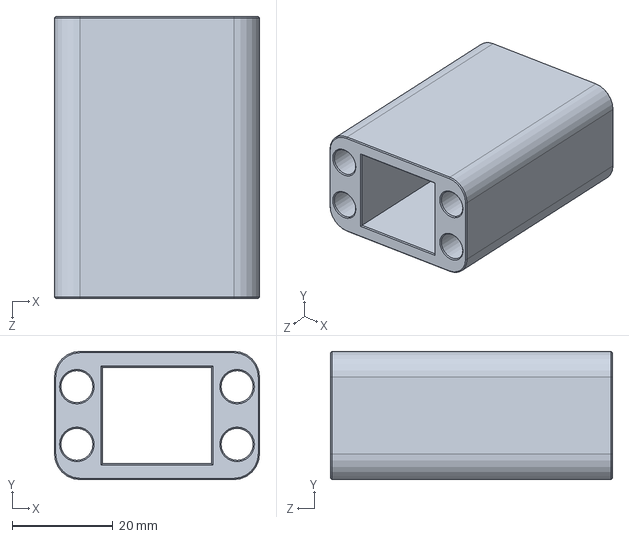
[picture p274: CAD file, 2018-04-09]
Project/CAD/Final Design CAD/SideSensorEntension.SLDPRT
40.6 x 25.4 x 55.9 mm
