andrewrichardr/MSE2202BDesignProject/Project/CAD/Final Design CAD/Step Motor 28BYJ-48.SLDPRT

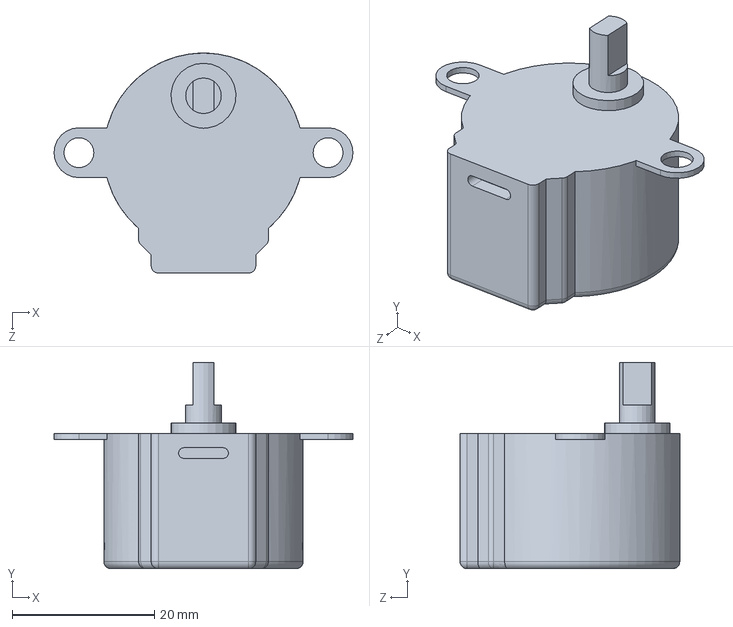
[picture p275: CAD file, 2018-04-09]
Project/CAD/Final Design CAD/Step Motor 28BYJ-48.SLDPRT
42.0 x 29.0 x 30.9 mm
