andrewrichardr/MSE2202BDesignProject/Project/CAD/Final Design CAD/nema_17_motor.SLDPRT

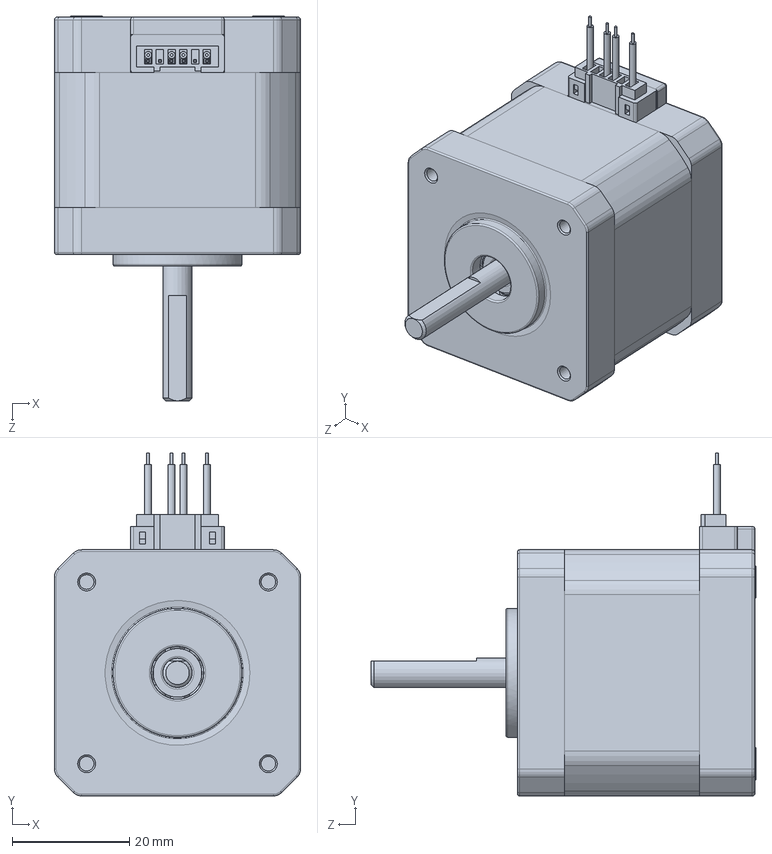
[picture p276: CAD file, 2018-04-09]
Project/CAD/Final Design CAD/nema_17_motor.SLDPRT
42.0 x 58.5 x 65.7 mm
