andrewrichardr/MSE2202BDesignProject/Project/CAD/Final Design CAD/Rail.SLDPRT

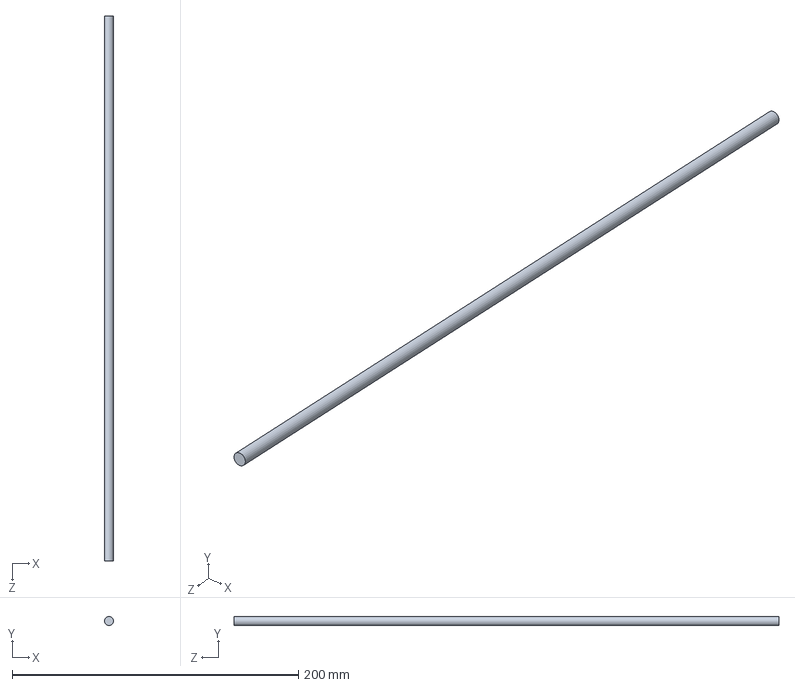
[picture p277: CAD file, 2018-04-09]
Project/CAD/Final Design CAD/Rail.SLDPRT
6.35 x 6.35 x 381.0 mm
