andrewrichardr/MSE2202BDesignProject/(list of files, cad)

Other CAD files:
Project/CAD/Prototype CAD/NUCLEO64Mount.SLDASM
Project/CAD/Prototype Assy/ClawAssy.SLDASM
Project/CAD/Prototype Assy/ControllerTray.SLDASM
Project/CAD/Prototype CAD/PIN_ASM_1_ASM.sldasm
Project/CAD/Prototype CAD/276-1321-INST1.sldasm
Project/CAD/Prototype CAD/aftermarket drive motor/sprocket-d.SLDPRT
Project/CAD/Prototype CAD/aftermarket drive motor/sprocket-a.SLDPRT
Project/CAD/Prototype CAD/aftermarket drive motor/sprocket-c.SLDPRT
Project/CAD/Prototype CAD/Pyramid Lift Assembly/back.SLDPRT
Project/CAD/Prototype CAD/back.SLDPRT
Project/CAD/Prototype CAD/Pyramid Lift Assembly/Circles 3 inch Linkage.SLDPRT
Project/CAD/Prototype CAD/Pyramid Lift Assembly/Circles 5.5in Inch Shaft Bar.SLDPRT
Project/CAD/Prototype CAD/MEDIUM-WHEEL-TIRE.sldprt
Project/CAD/Prototype CAD/CubeIntakeArm/CLAW_Lb.SLDPRT
Project/CAD/Prototype CAD/ChainLink.SLDPRT
Project/CAD/Prototype CAD/CubeIntakeArm/CLAW_R.SLDPRT
Project/CAD/Prototype CAD/276-2177-012 Rev1.sldprt
Project/CAD/Prototype CAD/276-2177-016 Rev2.sldprt
Project/CAD/Prototype CAD/LABLE_1.sldprt
Project/CAD/Prototype CAD/276-2177-019 Rev1.sldprt
Project/CAD/Prototype CAD/276-2177-018 Rev1.sldprt
Project/CAD/Prototype CAD/276-2177-009 Rev1.sldprt
Project/CAD/Prototype Assy/sprocket-hs-06-tooth.SLDPRT
Project/CAD/Prototype CAD/276-2177-010 Rev1.sldprt
Project/CAD/Prototype CAD/276-2177-005 Rev1.sldprt
Project/CAD/Prototype CAD/276-2177-013 Rev1.sldprt
Project/CAD/Prototype CAD/276-2177-011 Rev1.sldprt
Project/CAD/Prototype CAD/276-2177-006 Rev1.sldprt
Project/CAD/Prototype CAD/276-2177-014 Rev1.sldprt
Project/CAD/Final Design CAD/COG tall one layer export.SLDPRT
Project/CAD/Prototype CAD/SPPM204-0050BO.sldprt
Project/CAD/Final Design CAD/PyrIntakeRoller.STEP
Project/CAD/Prototype CAD/SPPM206-0150BO.sldprt
Project/CAD/Prototype CAD/PIN_1.sldprt
Project/CAD/Prototype CAD/PIN2_1.sldprt
Project/CAD/Prototype CAD/276-2177-015 Rev2.sldprt
Project/CAD/Prototype CAD/FS130-FT-21100.sldprt
Project/CAD/Prototype CAD/BOX-BOTTOM2_3.sldprt
Project/CAD/Final Design CAD/1327K113_MINIATURE 12L14 DRIVE STEEL SHAFT.SLDPRT
Project/CAD/Final Design CAD/2737T131_FINISHED-BORE SPROCKET FOR ANSI ROLLER CHAIN.SLDPRT
Project/CAD/Final Design CAD/2737T200_FINISHED-BORE SPROCKET FOR ANSI ROLLER CHAIN.SLDPRT
Project/CAD/Final Design CAD/57545K511_SPEED-REDUCING WORM GEAR FOR 90 DEG TRANSFER-cutoff.SLDPRT
Project/CAD/Final Design CAD/57545K511_SPEED-REDUCING WORM GEAR FOR 90 DEG TRANSFER.SLDPRT
Project/CAD/Final Design CAD/57545K527_SPEED-REDUCING WORM GEAR FOR 90 DEG TRANSFER.SLDPRT
Project/CAD/Final Design CAD/60355K503_BALL BEARING.SLDPRT
Project/CAD/Final Design CAD/60355K504_BALL BEARING.SLDPRT
Project/CAD/Final Design CAD/60355K509_BALL BEARING.SLDPRT
Project/CAD/Final Design CAD/6261K281_ROLLER CHAIN.SLDPRT
Project/CAD/Final Design CAD/6627T370_POSITION-CONTROL DC MOTOR.SLDPRT
Project/CAD/Final Design CAD/6627T380_POSITION-CONTROL DC MOTOR (1).SLDPRT
Project/CAD/Final Design CAD/6627T380_POSITION-CONTROL DC MOTOR.SLDPRT
Project/CAD/Final Design CAD/6627T530_POSITION-CONTROL DC MOTOR.SLDPRT
Project/CAD/Final Design CAD/6627T560_POSITION-CONTROL DC MOTOR.SLDPRT
Project/CAD/Final Design CAD/6627T650_POSITION-CONTROL DC MOTOR.SLDPRT
Project/CAD/Final Design CAD/93410A912_ASTM A193 STEEL ACME LEAD SCREW.SLDPRT
Project/CAD/Final Design CAD/93410A920_ASTM A193 STEEL ACME LEAD SCREW.SLDPRT
Project/CAD/Final Design CAD/95120A523_BRONZE GENERAL PURPOSE ACME FLANGE NUT.SLDPRT
Project/CAD/Final Design CAD/95120A592_BRONZE GENERAL PURPOSE ACME FLANGE NUT.SLDPRT
Project/CAD/Final Design CAD/ArmRotate.SLDDRW
Project/CAD/Final Design CAD/CasterWheel_5in.ipt.SLDPRT
Project/CAD/Final Design CAD/ChassisDrw.SLDDRW
Project/CAD/Final Design CAD/ChassisMotorCover.SLDPRT
Project/CAD/Final Design CAD/ChassisMotorHousing.SLDDRW
Project/CAD/Final Design CAD/ChassisSideCover.SLDDRW
Project/CAD/Final Design CAD/ChassisSidePlate.SLDDRW
Project/CAD/Final Design CAD/ClawArmBearingMount.SLDDRW
Project/CAD/Final Design CAD/ClawBracket.SLDDRW
Project/CAD/Final Design CAD/ClawMount.SLDDRW
Project/CAD/Final Design CAD/ClawRailMotorBracket.SLDDRW
Project/CAD/Final Design CAD/ClawWormCoupler.SLDDRW
Project/CAD/Final Design CAD/CubeArmMountBracket.SLDDRW
Project/CAD/Final Design CAD/CubeClawAssy.SLDDRW
Project/CAD/Final Design CAD/DriveStepper.SLDPRT
Project/CAD/Final Design CAD/LiftAssy.SLDDRW
Project/CAD/Final Design CAD/LiftLinkageBaseMount.SLDDRW
Project/CAD/Final Design CAD/Part9.SLDPRT
Project/CAD/Final Design CAD/PyrIntakeAngledMount.SLDDRW
Project/CAD/Final Design CAD/PyrIntakeForks.SLDDRW
Project/CAD/Final Design CAD/PyrIntakeLinkageRod.SLDDRW
Project/CAD/Final Design CAD/PyrIntakeMotorMount.SLDDRW
Project/CAD/Final Design CAD/RackStand.SLDDRW
Project/CAD/Final Design CAD/RotationBushing.SLDDRW
Project/CAD/Final Design CAD/SideSensorEntension.SLDDRW
Project/CAD/Final Design CAD/SideSensorMount.SLDDRW
Project/CAD/Final Design CAD/WheelAssy.SLDDRW
Project/CAD/Final Design CAD/Wheel_Bushing.SLDDRW
Project/CAD/Final Design CAD/__FINAL_DESIGN.SLDDRW
Project/CAD/Prototype Assy/ClawAssy-NoMates.SLDDRW
Project/CAD/Prototype Assy/ControllerTray-NoMates.SLDDRW
Project/CAD/Prototype Assy/LiftAssy-NoMates.SLDDRW
Project/CAD/Prototype Assy/__PROTOTYPE_ASSY.SLDDRW
Project/CAD/Prototype Assy/ramp.SLDDRW
Project/CAD/Prototype CAD/276-2177-003 Rev1.sldprt
Project/CAD/Prototype CAD/276-2177-004 Rev1.sldprt
Project/CAD/Prototype CAD/Chassis.SLDDRW
Project/CAD/Prototype CAD/Claw/Claw Holder.SLDDRW
Project/CAD/Prototype CAD/Claw/New Claw 2 Detached.SLDDRW
Project/CAD/Prototype CAD/Claw/New Claw.SLDDRW
Project/CAD/Prototype CAD/CubeIntakeArm/CLAW_L.SLDDRW
Project/CAD/Prototype CAD/CubeIntakeArm/CLAW_R.SLDDRW
Project/CAD/Prototype CAD/CubeIntakeArm/Claw-Holder.SLDDRW
Project/CAD/Prototype CAD/CubeIntakeArm/LiftLinkage.SLDDRW
Project/CAD/Prototype CAD/CubeIntakeArm/PyrIntakeBacking.SLDDRW
Project/CAD/Prototype CAD/CubeIntakeArm/ToBeCut.SLDDRW
Project/CAD/Prototype CAD/CubeIntakeArm/__FINAL_DESIGN.SLDDRW
Project/CAD/Prototype CAD/CubeIntakeArm/cuter.SLDDRW
Project/CAD/Prototype CAD/LIGHT_1.sldprt
Project/CAD/Prototype CAD/Lift Linkages/3 inch Linkage.SLDDRW
Project/CAD/Prototype CAD/Lift Linkages/5.5in Inch Shaft Bar and Connector.SLDDRW
Project/CAD/Prototype CAD/Lift Linkages/5.5in Inch Shaft Bar.SLDDRW
Project/CAD/Prototype CAD/Lift Linkages/ABS Group 9.SLDDRW
Project/CAD/Prototype CAD/Lift Linkages/Connector 3.5 inch Linkage.SLDDRW
Project/CAD/Prototype CAD/Lift Linkages/Linkage Bars.SLDDRW
Project/CAD/Prototype CAD/M2_1.sldprt
Project/CAD/Prototype CAD/MEDIUM-WHEEL-HUB.sldprt
Project/CAD/Prototype CAD/NUCLEO64Mount.SLDPRT
Project/CAD/Prototype CAD/PCB2_3.sldprt
Project/CAD/Prototype CAD/aftermarket drive motor/sprockets.SLDDRW
Project/CAD/Prototype CAD/fin.SLDPRT
Project/CAD/Prototype CAD/sprocket.SLDPRT
