andrewrichardr/MSE2202BDesignProject/Project/Documentation/MSE2202B Design Project-20180412T013709Z-001/MSE2202B Design Project/Stuff for PDF/MCU Benchmarks and Comparison.xlsx

 | STM32-F429ZI | STM32-F446RE | MSE-Duino | Arduino Mega
Test: | ARM Cortex-M4 @ 180MHz | ARM Cortex-M4 @ 180MHz | AVR ATmega328p @ 16MHz | AVR ATmega2560 @ 8MHz |  | ARM improvement over AVR
INT_LOOP(30000) | 19.95 | 19.95 | 3.98 |  | MIPS | 501.26%
LONG_LOOP(30000) | 19.99 | 19.99 | 2.24 |  | MIPS | 892.41%
FLOAT_DIV(30000) | 2.22 | 2.22 | 0.21 |  | MFLOPS | 1057.14%
DOUBLE_DIV(30000) | 2.05 | 2.05 | 0.21 |  | MFLOPS | 976.19%
FLOAT_MUL(30000) | 1.63 | 1.63 | 0.21 |  | MFLOPS | 776.19%
DOUBLE_MUL(30000) | 1.51 | 1.51 | 0.21 |  | MFLOPS | 719.05%
CoreMark |  | 602.44 |  | 4.25 | Points | 14175.06%
Calculate PI as fast as possible | 5000 | 5000 | 63000 | 80000 | milliseconds | 1260.00%
Specs:
Architecture | 32-bit ARM | 32-bit ARM | 8-bit AVR | 8-bit AVR
CPU Freq | 180 | 180 | 16 | 8 | MHz
RAM | 256 | 128 | 2 | 8 | KB
FLASH | 2048 | 512 | 32 | 256 | KB
I/O Pins | 144 | 64 | 28 | 64 | Pins
UART / USART Buses | 8 | 6 | 1 | 4 | Buses
I2C Buses | 3 | 3 | 1 | 1 | Buses
SPI Buses | 6 | 4 | 2 | 5 | Buses
ADC | 12-bit, 24-ch | 12-bit, 24-ch | 10-bit | 10-bit | Bits
Interrupts | All GPIO | All GPIO | 2 | ?
https://forum.arduino.cc/index.php?topic=431169.0
https://www.eembc.org/coremark//index.php
https://www.microchip.com/wwwproducts/en/ATmega2560
http://www.microchip.com/wwwproducts/en/ATmega328p
https://os.mbed.com/platforms/ST-Nucleo-F446RE/
https://os.mbed.com/platforms/ST-Nucleo-F429ZI/
