andrewrichardr/MSE2202BDesignProject/Project/Documentation/MSE2202B Design Project-20180412T013709Z-001/MSE2202B Design Project/Docs/Journal.docx

FEB 15

Problem breakdown:

- Find Cube
  - Cube Location Strategy
- Pickup Cube
- Find Correct Pyramid
  - Deposit Cube Here
- Pickup Correct Pyramid
- Insert Cube in Pyramid

General Concerns

- Running into walls
- Running over obstacles
- Pushing cube of the perimeter wall

CAD up ideas over reading week

FEB 16

- Began compiling list of questions to be answered

FEB 23

- Prelim arm ideas made and in CAD
- Worked on design review
