andrewrichardr/MSE2202BDesignProject/Project/CAD/Final Design CAD/ChassisDrw.PDF

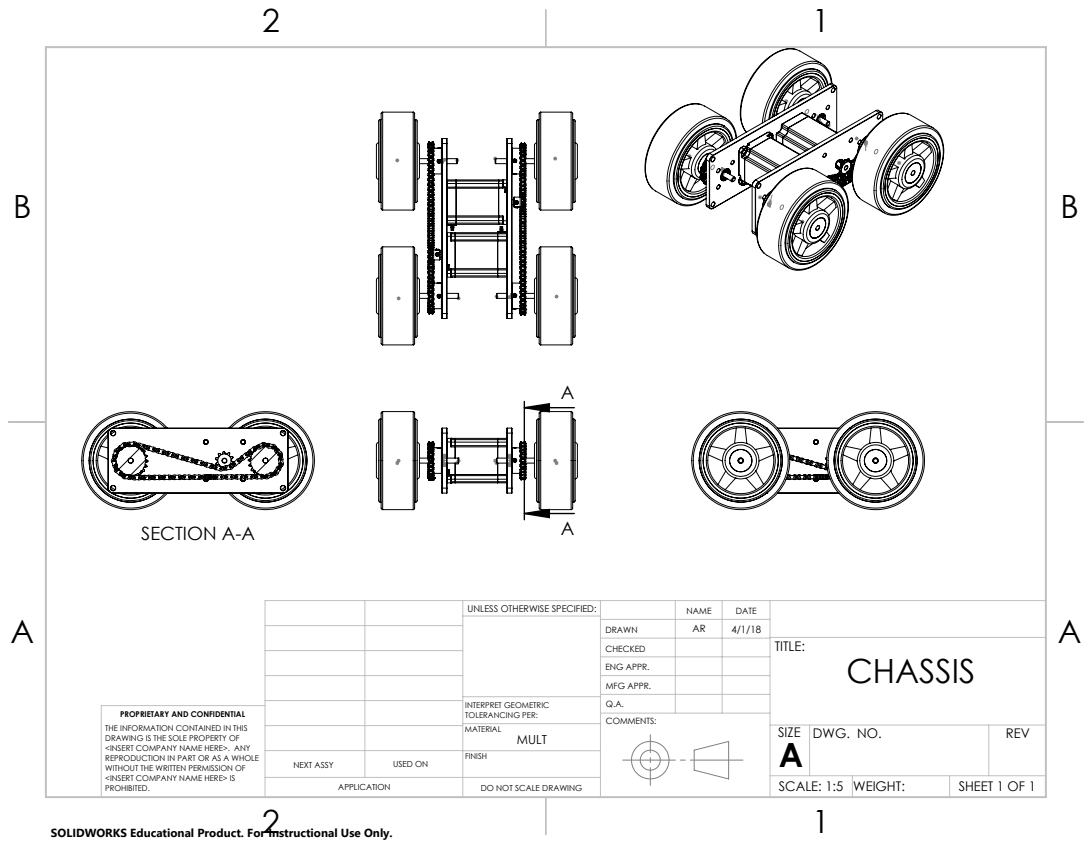
[picture p278: page 1]
SECTION A-A; DWG. NO.; REV

UNLESS OTHERWISE SPECIFIED: | | NAME | DATE

DRAWN | AR | 4/1/18
CHECKED | | | TITLE: CHASSIS

ENG APPR.
MFG APPR.

INTERPRET GEOMETRIC TOLERANCING PER: | Q.A.

PROPRIETARY AND CONFIDENTIAL
THE INFORMATION CONTAINED IN THIS
DRAWING IS THE SOLE PROPERTY OF
<INSERT COMPANY NAME HERE>. ANY
REPRODUCTION IN PART OR AS A WHOLE
WITHOUT THE WRITTEN PERMISSION OF
<INSERT COMPANY NAME HERE> IS
PROHIBITED.

COMMENTS:

NEXT ASSY | USED ON | FINISH

APPLICATION | DO NOT SCALE DRAWING | | SCALE: 1:5 | WEIGHT: | SHEET 1 OF 1

SOLIDWORKS Educational Product. For Instructional Use Only.
