andrewrichardr/MSE2202BDesignProject/Project/CAD/Final Design CAD/CubeClawAssy.PDF

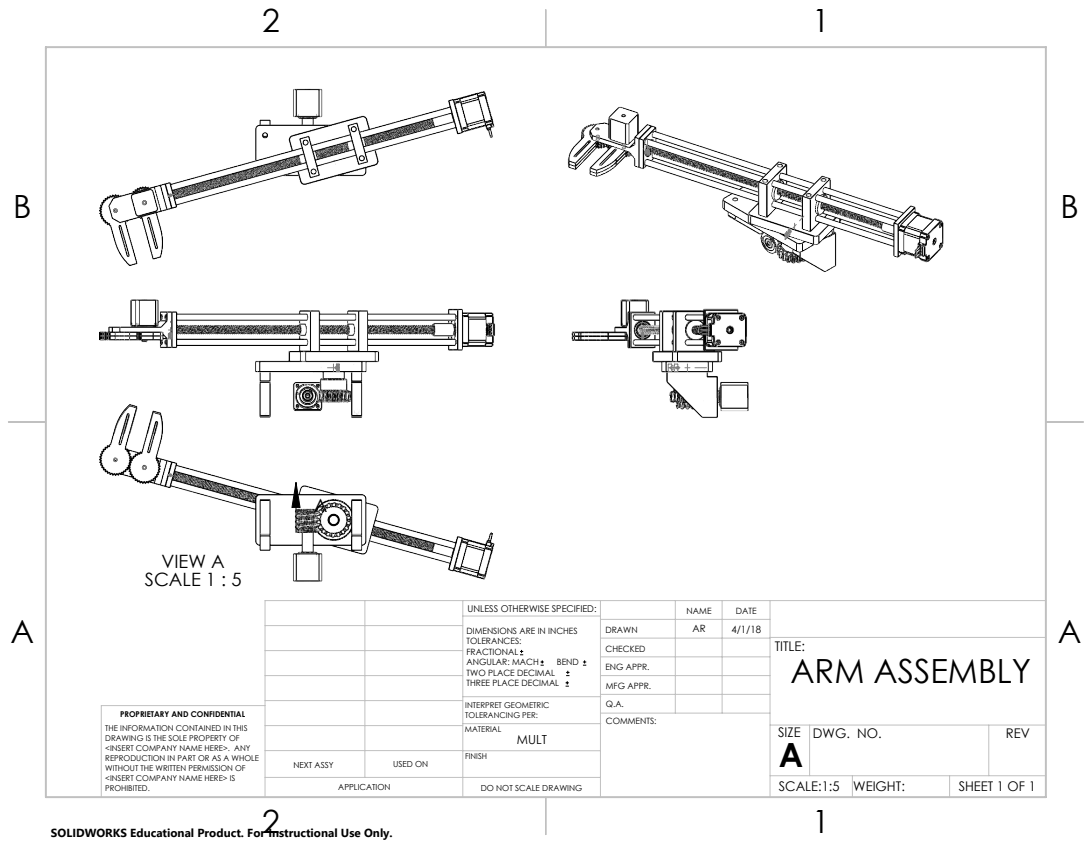
[picture p279: page 1]
VIEW A SCALE 1 : 5

UNLESS OTHERWISE SPECIFIED: | | NAME | DATE
DIMENSIONS ARE IN INCHES TOLERANCES: FRACTIONAL ANGULAR: MACH BEND TWO PLACE DECIMAL THREE PLACE DECIMAL | DRAWN | AR | 4/1/18

CHECKED | | | TITLE: ARM ASSEMBLY

ENG APPR.
MFG APPR.

INTERPRET GEOMETRIC TOLERANCING PER: | Q.A.
MATERIAL MULT | | SIZE A | DWG. NO. | REV

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

NEXT ASSY | USED ON | FINISH

APPLICATION | DO NOT SCALE DRAWING | | SCALE:1:5 | WEIGHT: | SHEET 1 OF 1

SOLIDWORKS Educational Product. For Instructional Use Only.
