andrewrichardr/MSE2202BDesignProject/Project/CAD/Final Design CAD/LiftLinkage.PDF

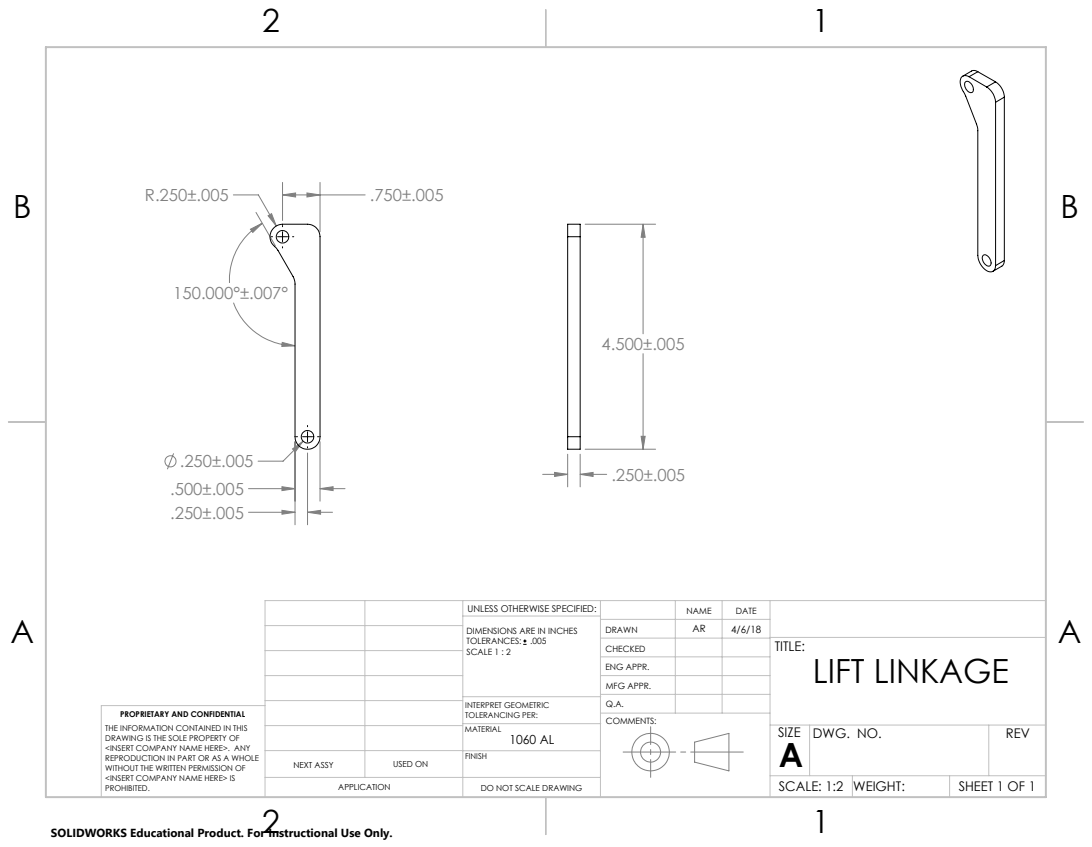
[picture p280: page 1]
DWG. NO.; REV

UNLESS OTHERWISE SPECIFIED: | | NAME | DATE
DIMENSIONS ARE IN INCHES TOLERANCES: .005 SCALE 1 : 2 | DRAWN | AR | 4/6/18

CHECKED | | | TITLE: LIFT LINKAGE

ENG APPR.
MFG APPR.

INTERPRET GEOMETRIC TOLERANCING PER: | Q.A.

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

COMMENTS:

NEXT ASSY | USED ON | FINISH

APPLICATION | DO NOT SCALE DRAWING | | SCALE: 1:2 | WEIGHT: | SHEET 1 OF 1

SOLIDWORKS Educational Product. For Instructional Use Only.
