andrewrichardr/MSE2202BDesignProject/Project/CAD/Final Design CAD/PyrIntakeBacking.PDF

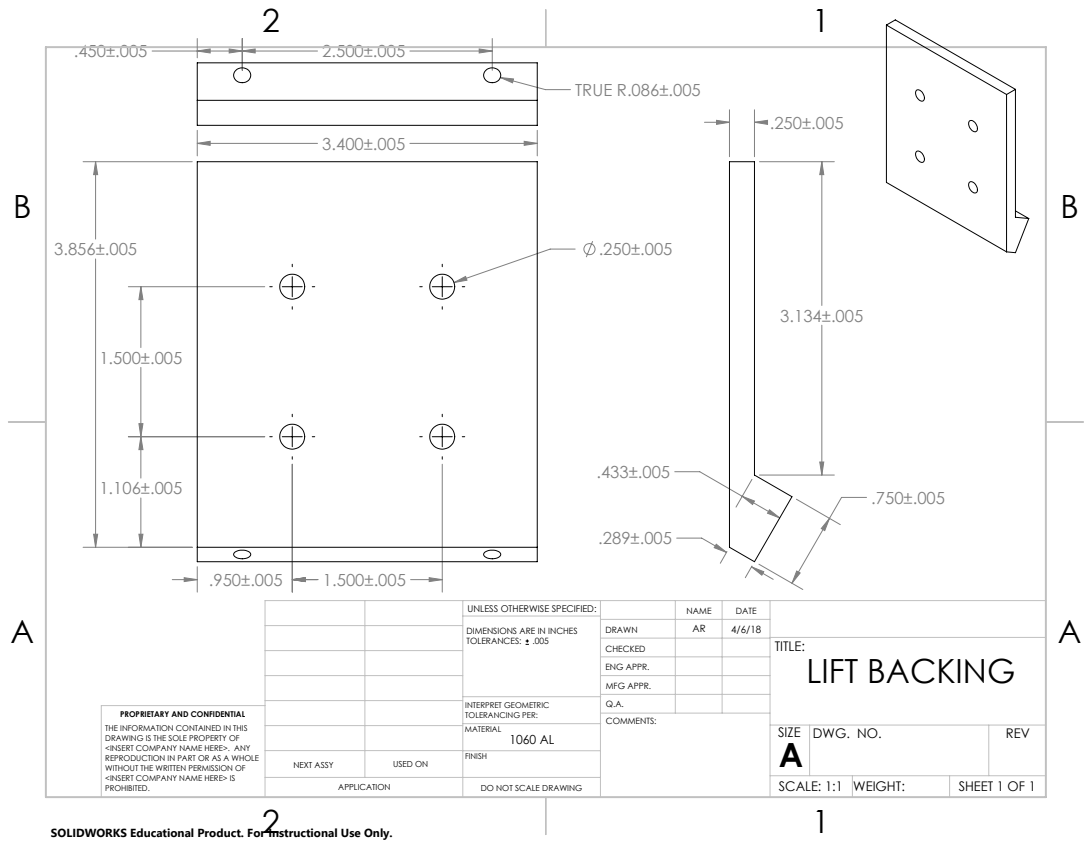
[picture p281: page 1]
TRUE R.086±.005

UNLESS OTHERWISE SPECIFIED: | | NAME | DATE
DIMENSIONS ARE IN INCHES TOLERANCES: .005 | DRAWN | AR | 4/6/18

CHECKED | | | TITLE: LIFT BACKING

ENG APPR.
MFG APPR.

INTERPRET GEOMETRIC TOLERANCING PER: | Q.A.
MATERIAL 1060 AL | | SIZE A | DWG. NO. | REV

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

NEXT ASSY | USED ON | FINISH

APPLICATION | DO NOT SCALE DRAWING | | SCALE: 1:1 | WEIGHT: | SHEET 1 OF 1

SOLIDWORKS Educational Product. For Instructional Use Only.
