andrewrichardr/MSE2202BDesignProject/Project/Documentation/MSE2202B Design Project-20180412T013709Z-001/MSE2202B Design Project/Stuff for PDF/Planned Daughter Board.pdf

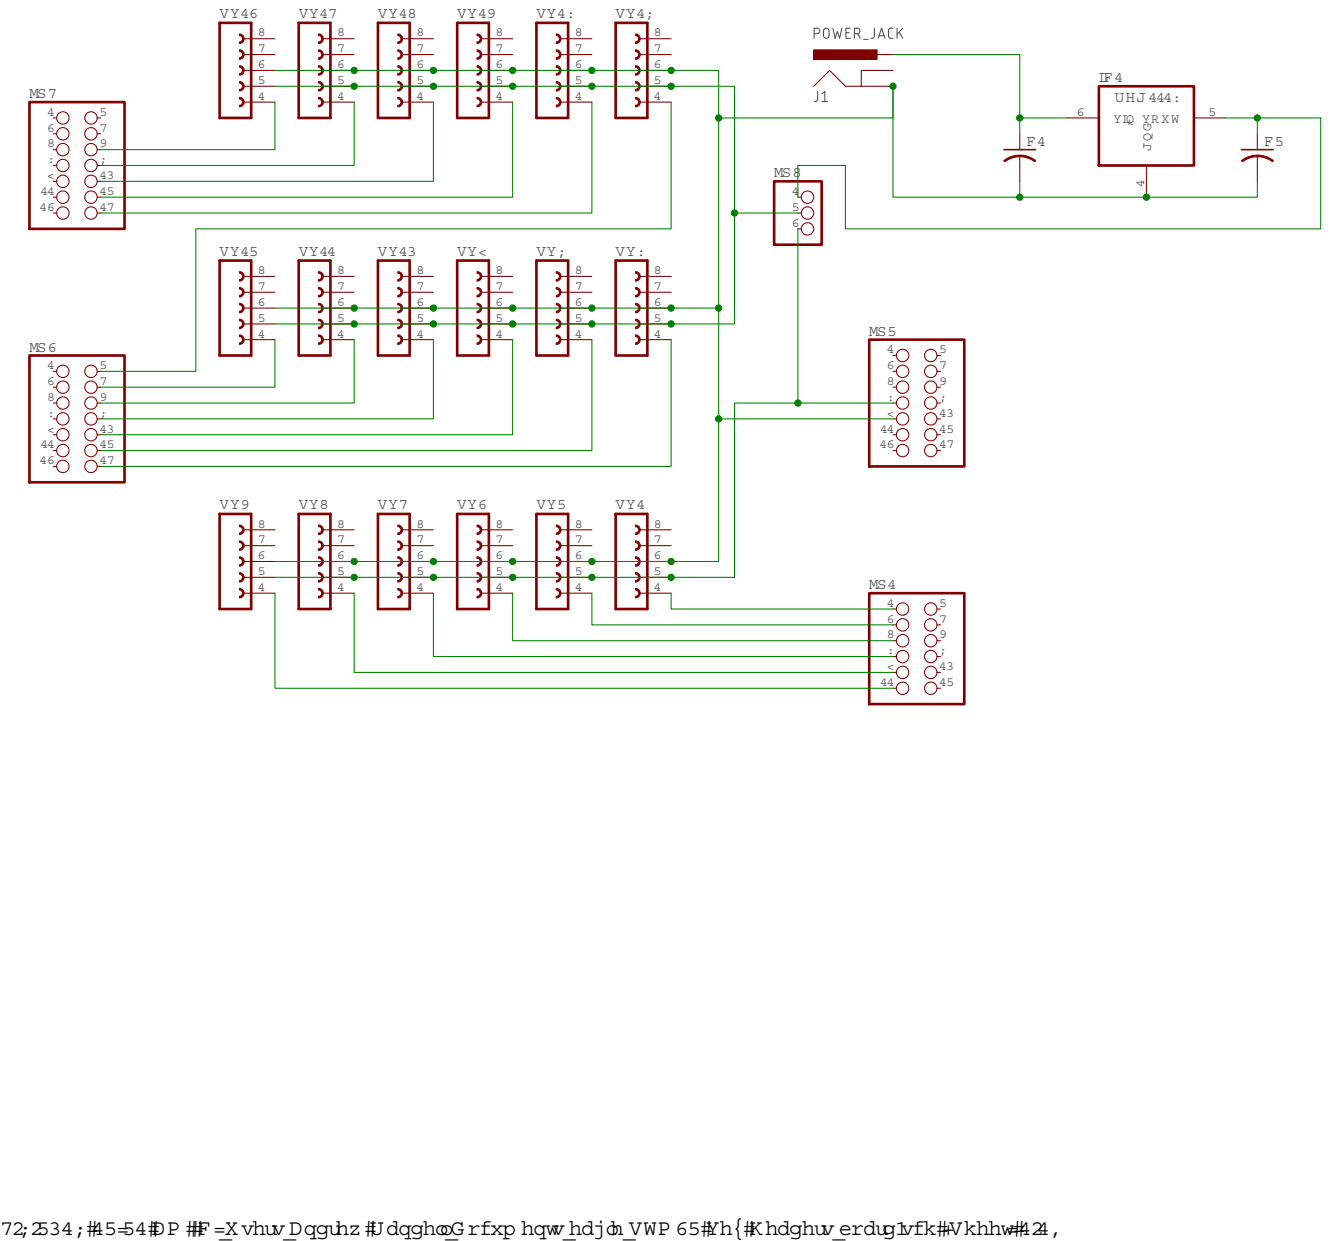
[picture p283: page 1]

4/8/2018 12:21 AM C:\U sers\Andrew R andell\D ocum ents\eagle\STM 32 Vex H eaders\board.sch (Sheet: 1/1)
