andrewrichardr/MSE2202BDesignProject/Project/Documentation/MSE2202B Design Project-20180412T013709Z-001/MSE2202B Design Project/Stuff for PDF/BlockDiagram-Planned-1.pdf

## MSE2202B Project Block Diagram

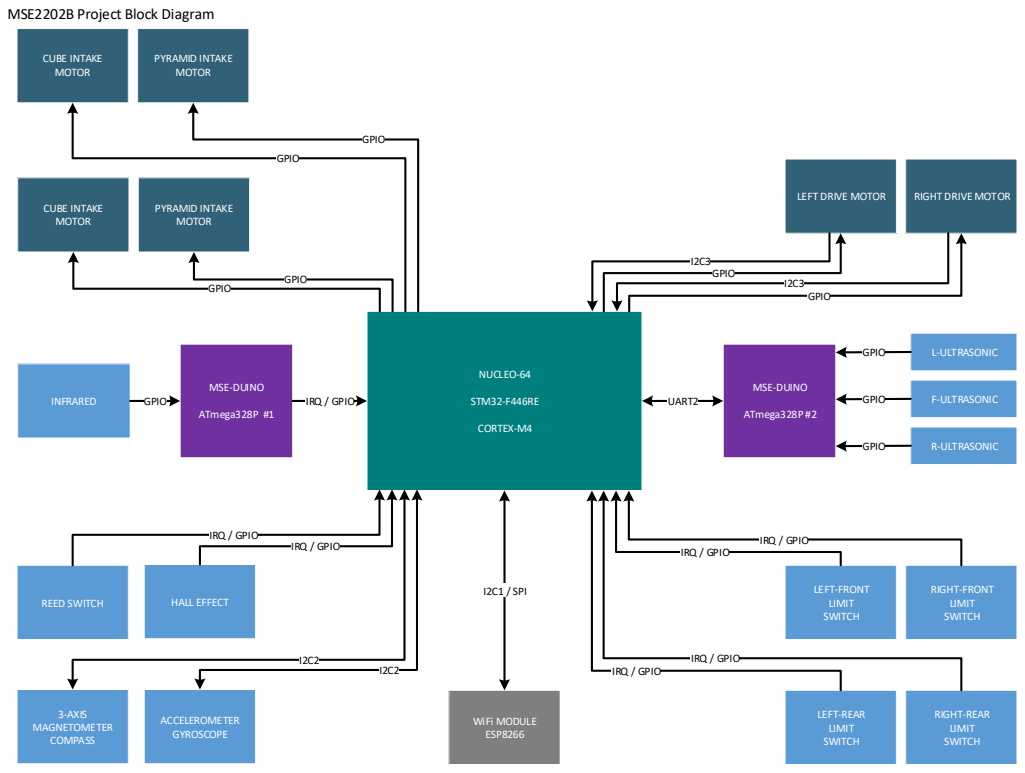
[picture p285: page 1]
NUCLEO-64; STM32-F446RE; CORTEX-M4; MSE-DUINO; ATmega328P #2; L-ULTRASONIC; R-ULTRASONIC; LEFT DRIVE MOTOR; RIGHT DRIVE MOTOR; RIGHT-FRONT LIMIT SWITCH; LEFT-FRONT LIMIT SWITCH; RIGHT-REAR LIMIT SWITCH; LEFT-REAR LIMIT SWITCH; IRQ / GPIO; PYRAMID INTAKE MOTOR; CUBE INTAKE MOTOR; ATmega328P #1; GPIO; INFRARED; UART2; REED SWITCH; HALL EFFECT; 3-AXIS MAGNETOMETER COMPASS; ACCELEROMETER GYROSCOPE; F-ULTRASONIC; WiFi MODULE ESP8266; I2C1 / SPI
