andrewrichardr/MSE2202BDesignProject/Project/Documentation/MSE2202B Design Project-20180412T013709Z-001/MSE2202B Design Project/Concepts/Daughter board for STM32/daughterboard.pdf

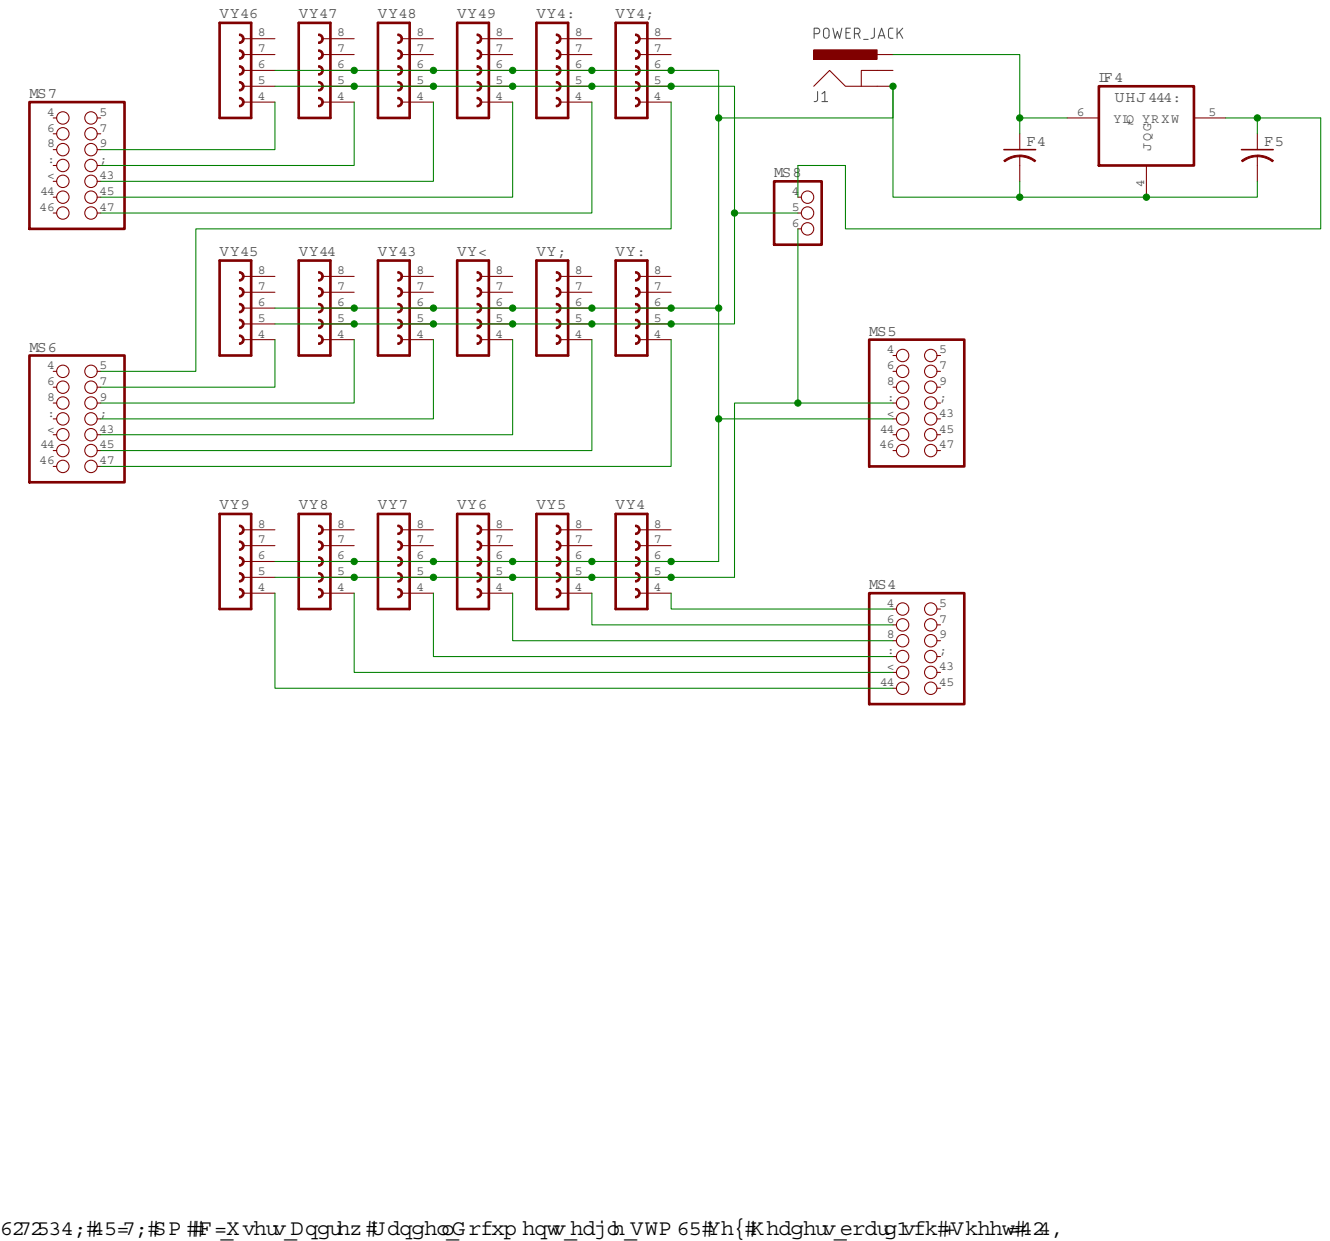
[picture p286: page 1]

3/4/2018 12:48 PM C:\U sers\Andrew R andell\D ocum ents\eagle\STM 32 Vex H eaders\board.sch (Sheet: 1/1)
