andrewrichardr/MSE2202BDesignProject/Project/Documentation/MSE2202B Design Project-20180412T013709Z-001/MSE2202B Design Project/Concepts/Daughter board for STM32/daughterboardlayout.pdf

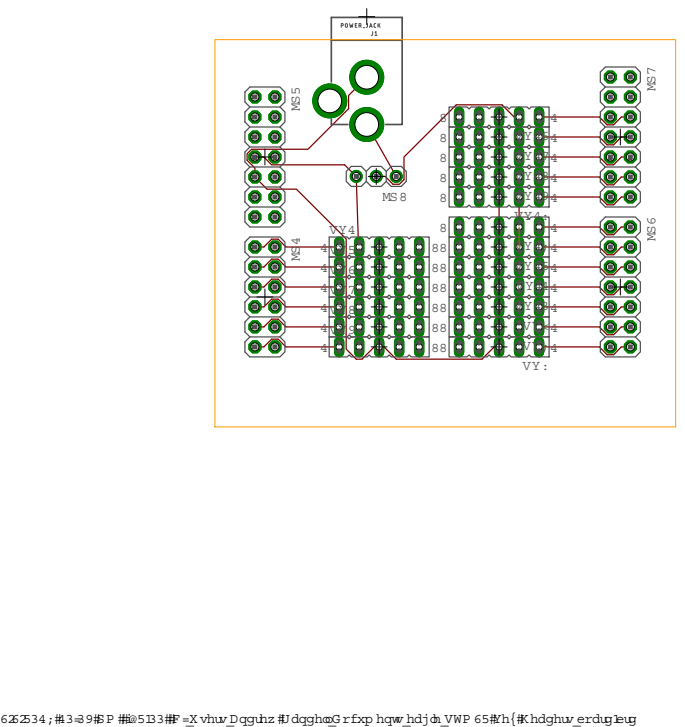
[picture p287: page 1]

3/3/2018 10:06 PM f=2.00 C:\U sers\Andrew R andell\D ocum ents\eagle\STM 32 Vex H eaders\board.brd
