andrewrichardr/MSE2202BDesignProject/Project/Documentation/MSE2202B Design Project-20180412T013709Z-001/MSE2202B Design Project/Stuff for PDF/Product Drawings/1327K113_MINIATURE 12L14 DRIVE STEEL SHAFT.PDF

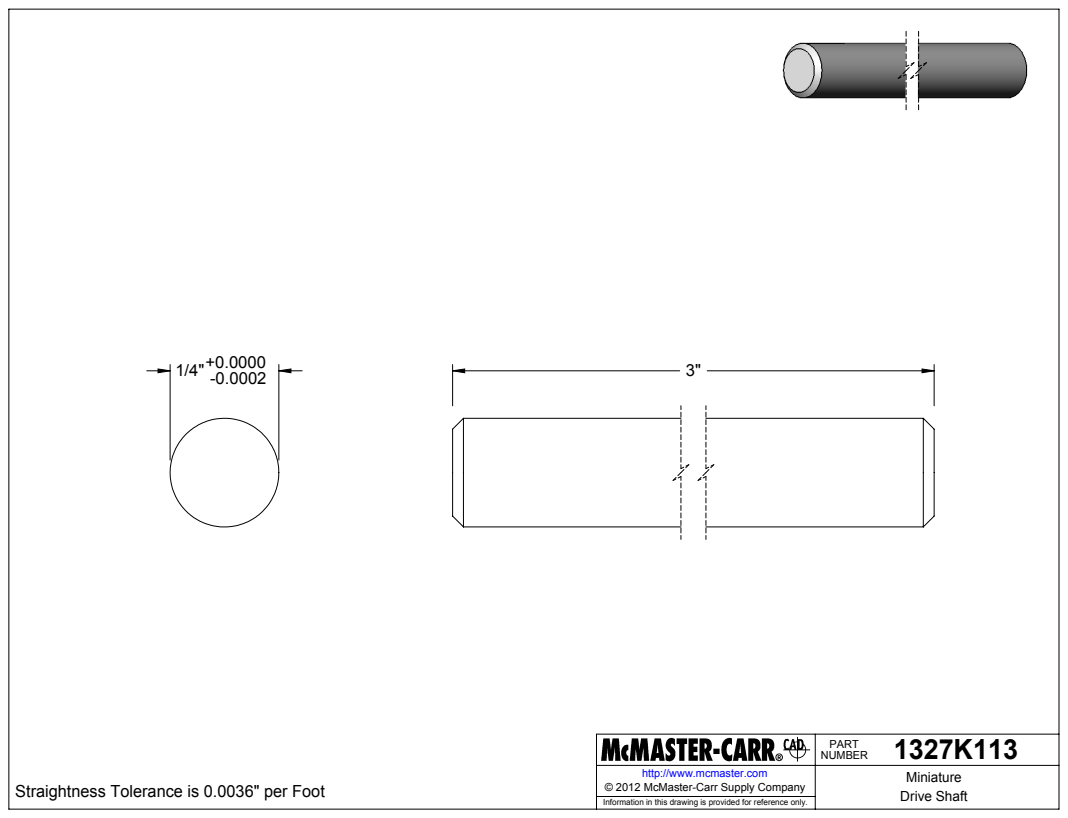
[picture p288: page 1]
Straightness Tolerance is 0.0036" per Foot; Drive Shaft © 2012 McMaster-Carr Supply Company

1327K113 PART NUMBER

http://www.mcmaster.com | Miniature

Information in this drawing is provided for reference only.
