andrewrichardr/MSE2202BDesignProject/Project/Documentation/MSE2202B Design Project-20180412T013709Z-001/MSE2202B Design Project/Stuff for PDF/Product Drawings/2709K120_COMPACT ROUND-FACE DC GEARMOTOR.PDF

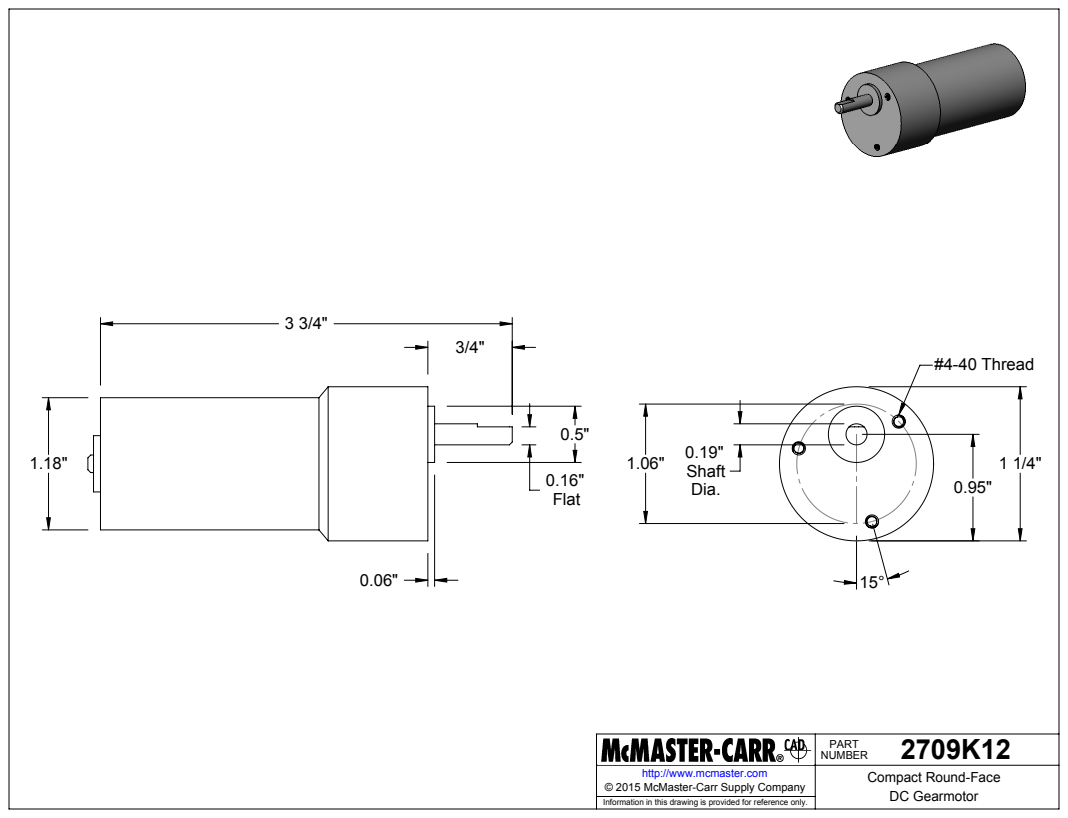
[picture p289: page 1]
#4-40 Thread

2709K12 PART NUMBER

http://www.mcmaster.com | Compact Round-Face DC Gearmotor © 2015 McMaster-Carr Supply Company

Information in this drawing is provided for reference only.
