andrewrichardr/MSE2202BDesignProject/Project/Documentation/MSE2202B Design Project-20180412T013709Z-001/MSE2202B Design Project/Stuff for PDF/Product Drawings/2737T200_FINISHED-BORE SPROCKET FOR ANSI ROLLER CHAIN.PDF

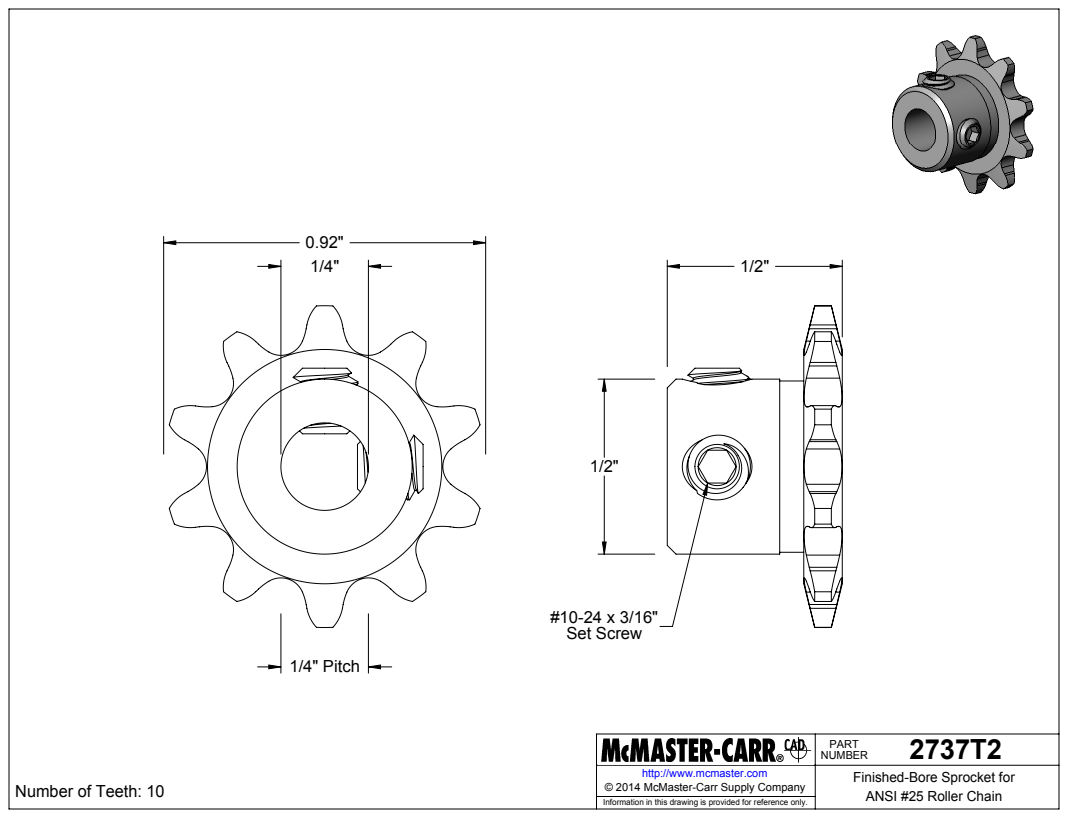
[picture p291: page 1]
1/4" Pitch; #10-24 x 3/16" Set Screw; Number of Teeth: 10; ANSI #25 Roller Chain © 2014 McMaster-Carr Supply Company

2737T2 PART NUMBER

http://www.mcmaster.com | Finished-Bore Sprocket for

Information in this drawing is provided for reference only.
