andrewrichardr/MSE2202BDesignProject/Project/Documentation/MSE2202B Design Project-20180412T013709Z-001/MSE2202B Design Project/Stuff for PDF/Product Drawings/57545K511_SPEED-REDUCING WORM GEAR FOR 90 DEG TRANSFER.PDF

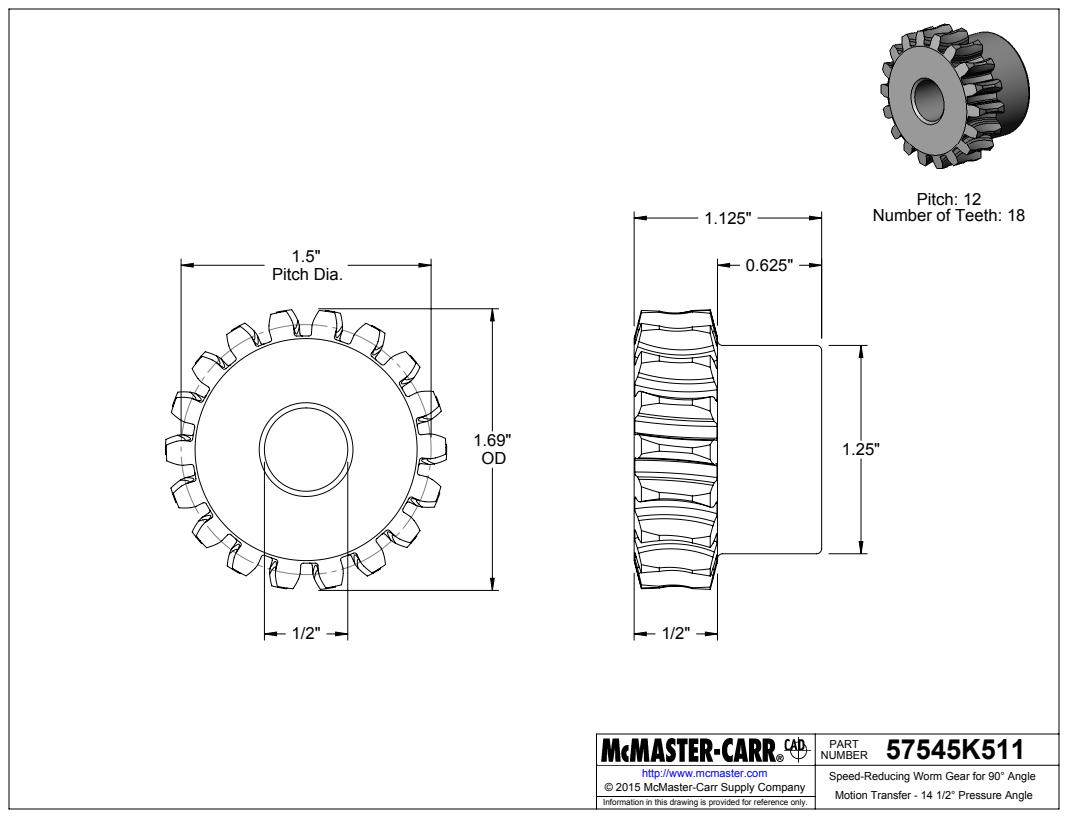
[picture p292: page 1]
Pitch Dia.

Pitch: 12
Number of Teeth: 18

57545K511 PART NUMBER

http://www.mcmaster.com | Speed-Reducing Worm Gear for 90° Angle Motion Transfer - 14 1/2° Pressure Angle © 2015 McMaster-Carr Supply Company

Information in this drawing is provided for reference only.
