andrewrichardr/MSE2202BDesignProject/Project/Documentation/MSE2202B Design Project-20180412T013709Z-001/MSE2202B Design Project/Stuff for PDF/Product Drawings/60355K503_BALL BEARING.PDF

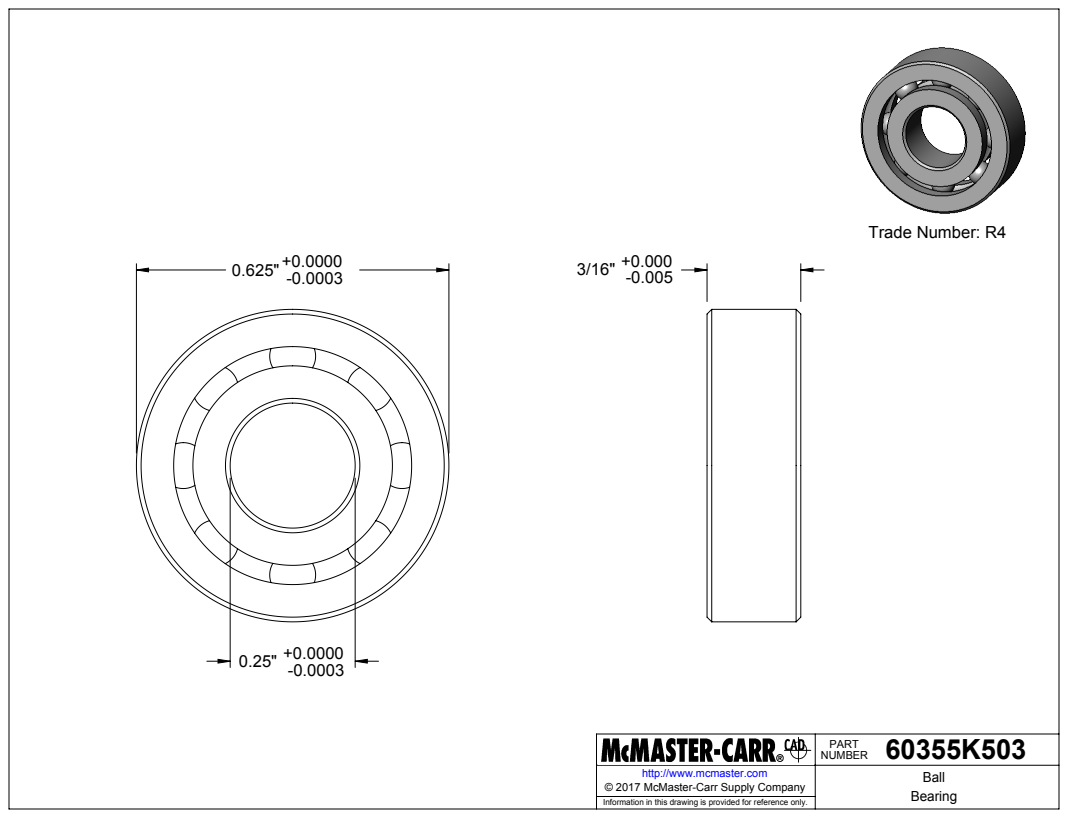
[picture p294: page 1]
Trade Number: R4

60355K503 PART NUMBER

http://www.mcmaster.com | Ball Bearing © 2017 McMaster-Carr Supply Company

Information in this drawing is provided for reference only.
