andrewrichardr/MSE2202BDesignProject/Project/Documentation/MSE2202B Design Project-20180412T013709Z-001/MSE2202B Design Project/Stuff for PDF/Product Drawings/6261K281_ROLLER CHAIN.PDF

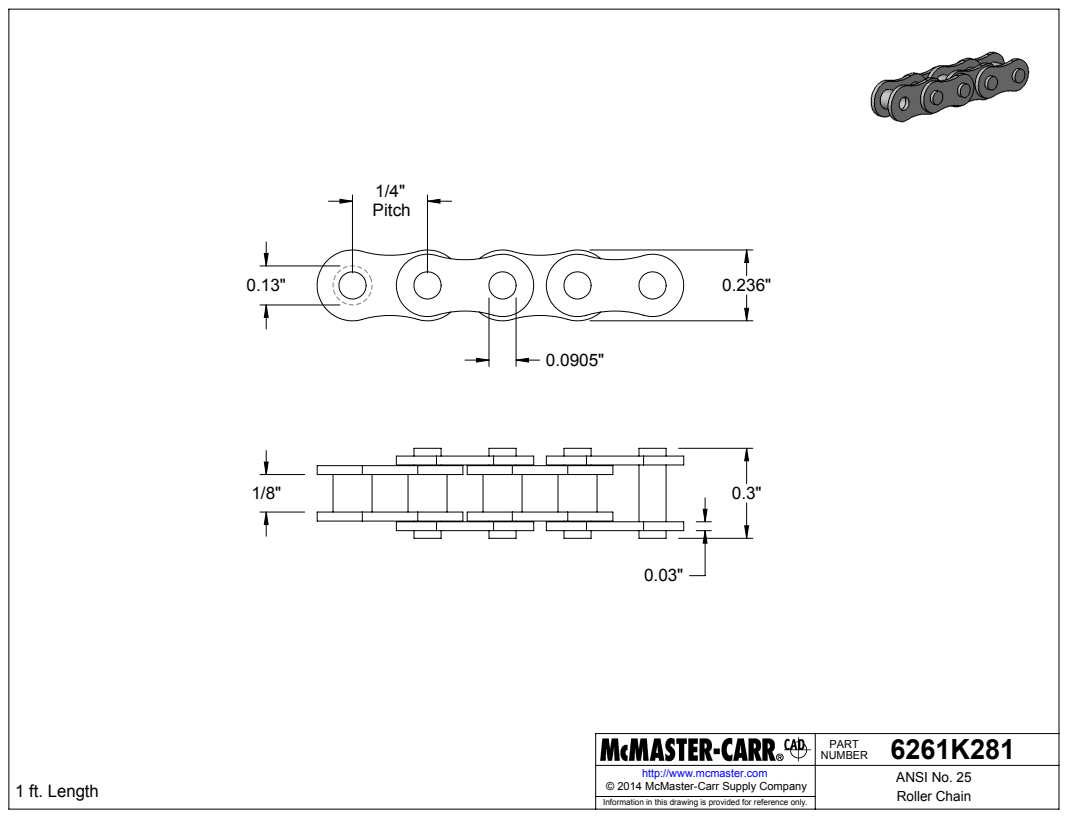
[picture p295: page 1]
1 ft. Length; Roller Chain © 2014 McMaster-Carr Supply Company

6261K281 PART NUMBER

http://www.mcmaster.com | ANSI No. 25

Information in this drawing is provided for reference only.
