andrewrichardr/MSE2202BDesignProject/Project/Documentation/MSE2202B Design Project-20180412T013709Z-001/MSE2202B Design Project/Stuff for PDF/Product Drawings/6627T380_POSITION-CONTROL DC MOTOR.PDF

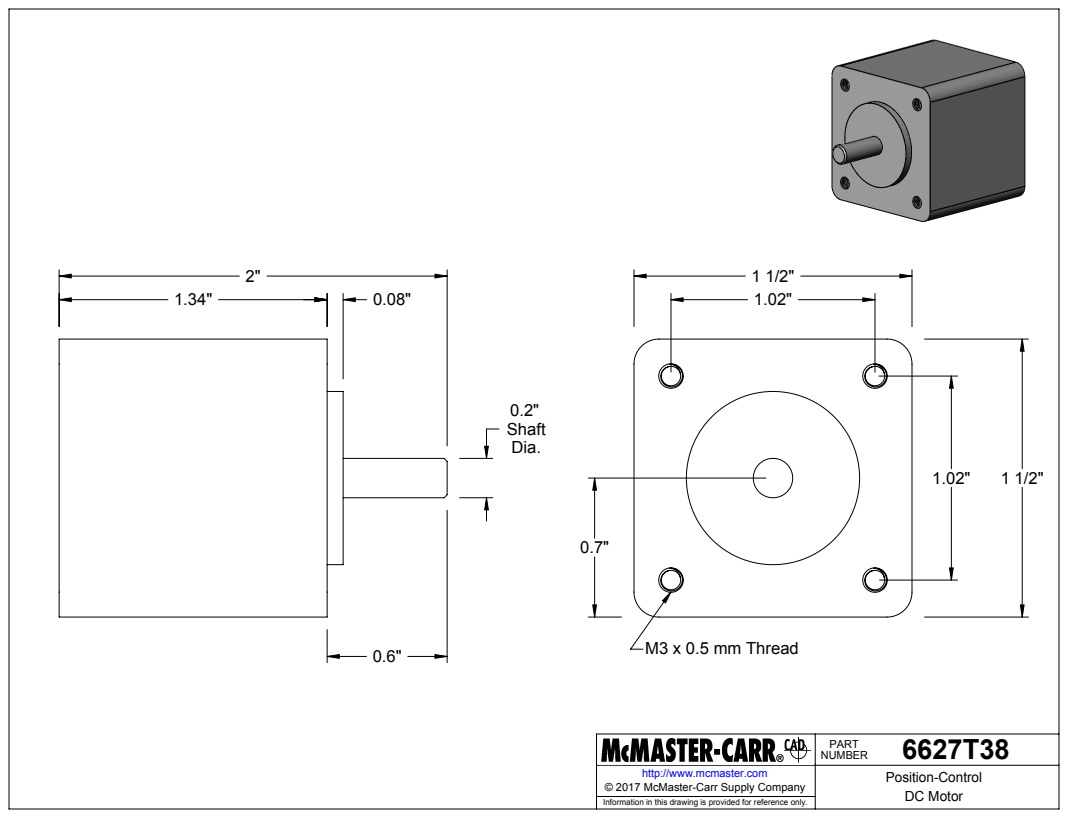
[picture p296: page 1]
M3 x 0.5 mm Thread

6627T38 PART NUMBER

http://www.mcmaster.com | Position-Control DC Motor © 2017 McMaster-Carr Supply Company

Information in this drawing is provided for reference only.
