andrewrichardr/MSE2202BDesignProject/Project/Documentation/MSE2202B Design Project-20180412T013709Z-001/MSE2202B Design Project/Stuff for PDF/Product Drawings/6627T540_POSITION-CONTROL DC MOTOR.PDF

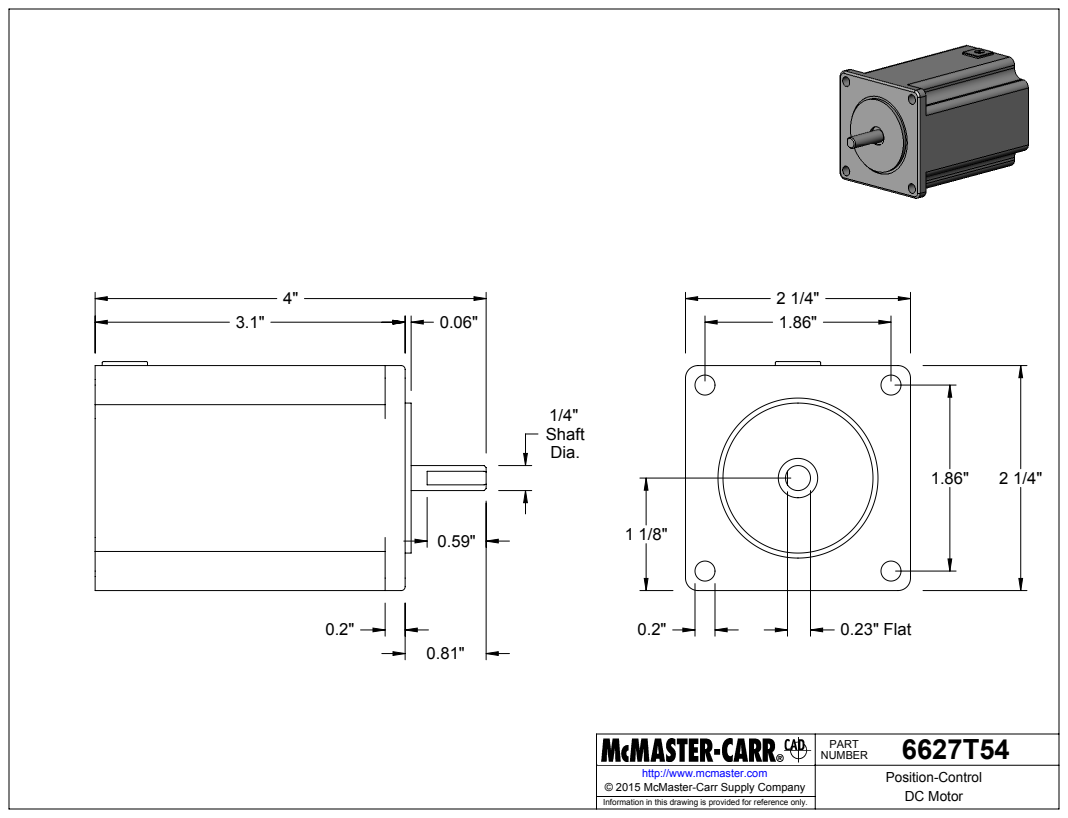
[picture p297: page 1]
0.23" Flat

6627T54 PART NUMBER

http://www.mcmaster.com | Position-Control DC Motor © 2015 McMaster-Carr Supply Company

Information in this drawing is provided for reference only.
