andrewrichardr/MSE2202BDesignProject/Project/Documentation/MSE2202B Design Project-20180412T013709Z-001/MSE2202B Design Project/Stuff for PDF/Product Drawings/93410A111_ASTM A193 STEEL ACME LEAD SCREW.PDF

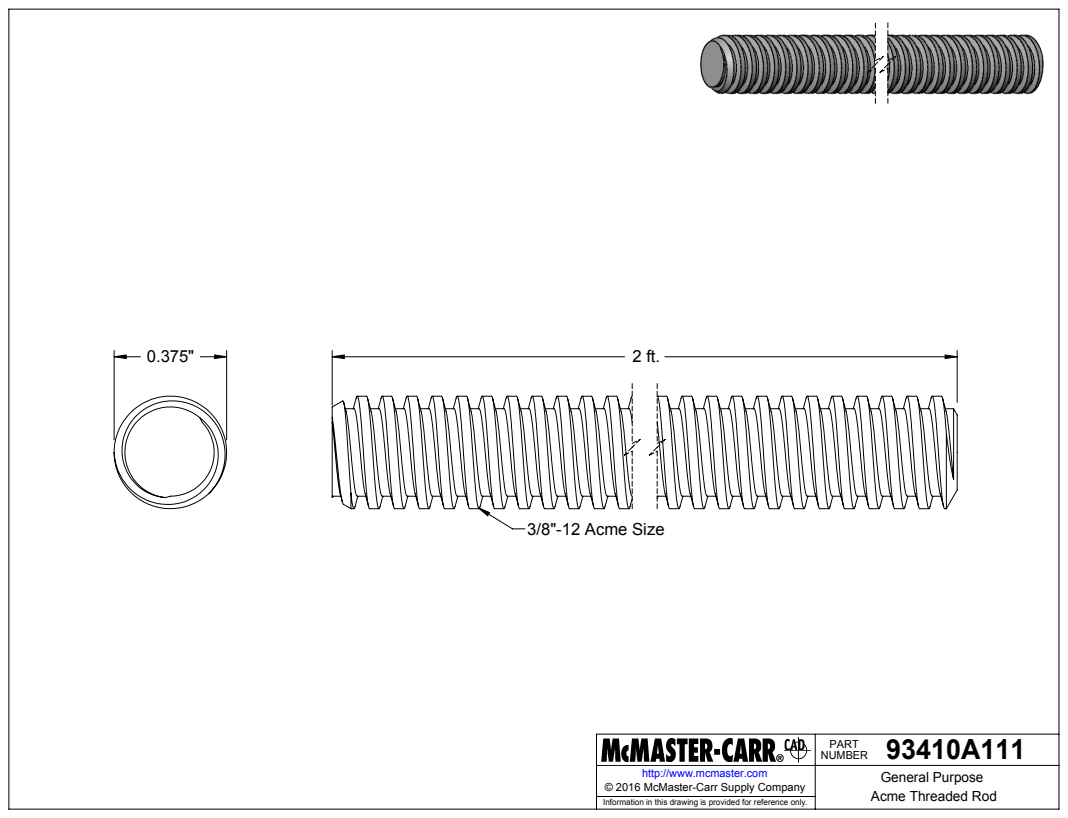
[picture p298: page 1]
3/8"-12 Acme Size

93410A111 PART NUMBER

http://www.mcmaster.com | General Purpose Acme Threaded Rod © 2016 McMaster-Carr Supply Company

Information in this drawing is provided for reference only.
