andrewrichardr/MSE2202BDesignProject/Project/Documentation/MSE2202B Design Project-20180412T013709Z-001/MSE2202B Design Project/Stuff for PDF/Product Drawings/95120A592_BRONZE GENERAL PURPOSE ACME FLANGE NUT.PDF

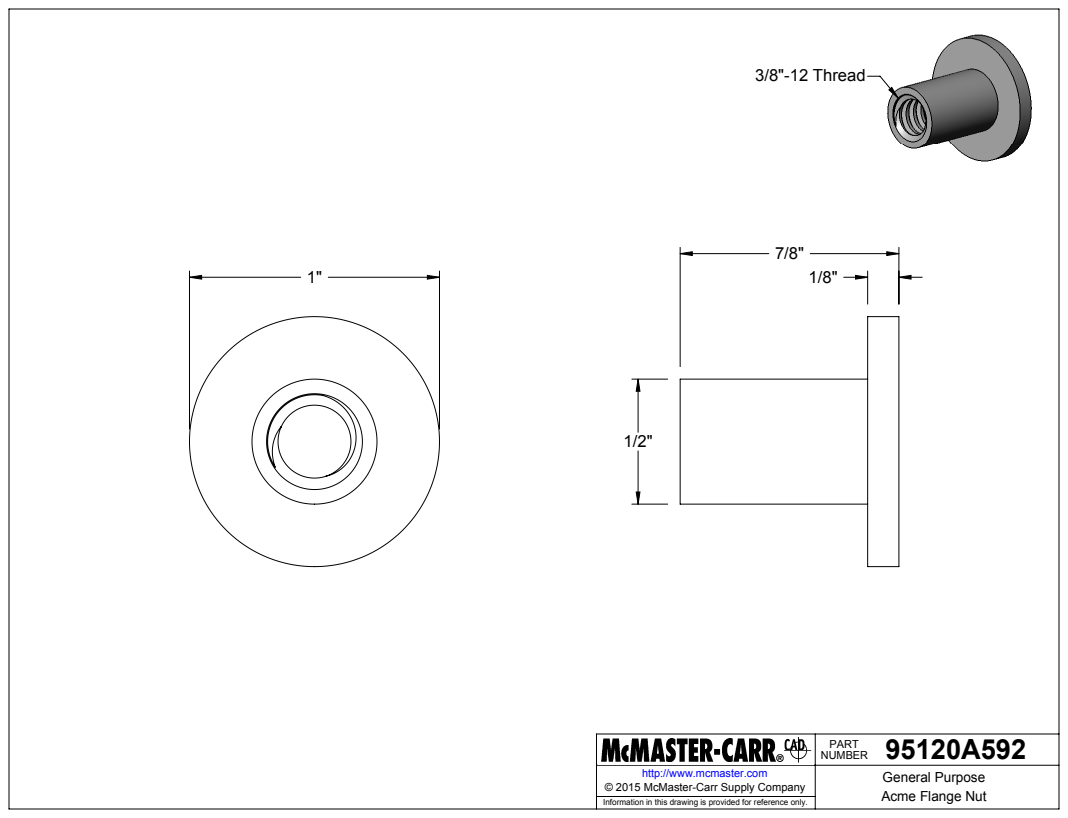
[picture p299: page 1]
3/8"-12 Thread

95120A592 PART NUMBER

http://www.mcmaster.com | General Purpose Acme Flange Nut © 2015 McMaster-Carr Supply Company

Information in this drawing is provided for reference only.
