andrewrichardr/MSE2202BDesignProject/Project/Documentation/MSE2202B Design Project-20180412T013709Z-001/MSE2202B Design Project/Stuff for PDF/Product Drawings/CLAW_R.PDF

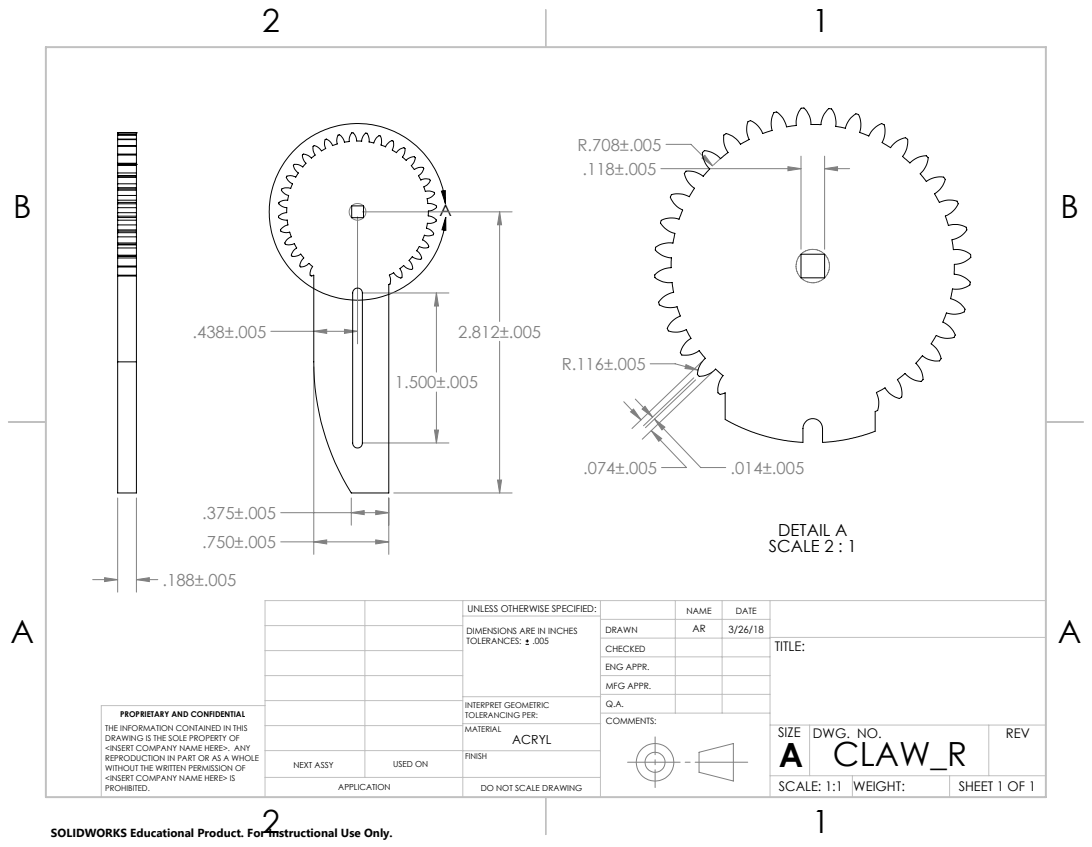
[picture p300: page 1]
DETAIL A SCALE 2 : 1; SHEET 1 OF 1; SCALE: 1:1; WEIGHT:; DWG. NO.; REV; NEXT ASSY; USED ON

UNLESS OTHERWISE SPECIFIED: | | NAME | DATE
DIMENSIONS ARE IN INCHES TOLERANCES: .005 | DRAWN | AR | 3/26/18

CHECKED | | | TITLE:

ENG APPR.
MFG APPR.

INTERPRET GEOMETRIC TOLERANCING PER: | Q.A.

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

COMMENTS:

DO NOT SCALE DRAWING

SOLIDWORKS Educational Product. For Instructional Use Only.
