andrewrichardr/MSE2202BDesignProject/Project/Documentation/MSE2202B Design Project-20180412T013709Z-001/MSE2202B Design Project/Stuff for PDF/Product Drawings/RackStand.PDF

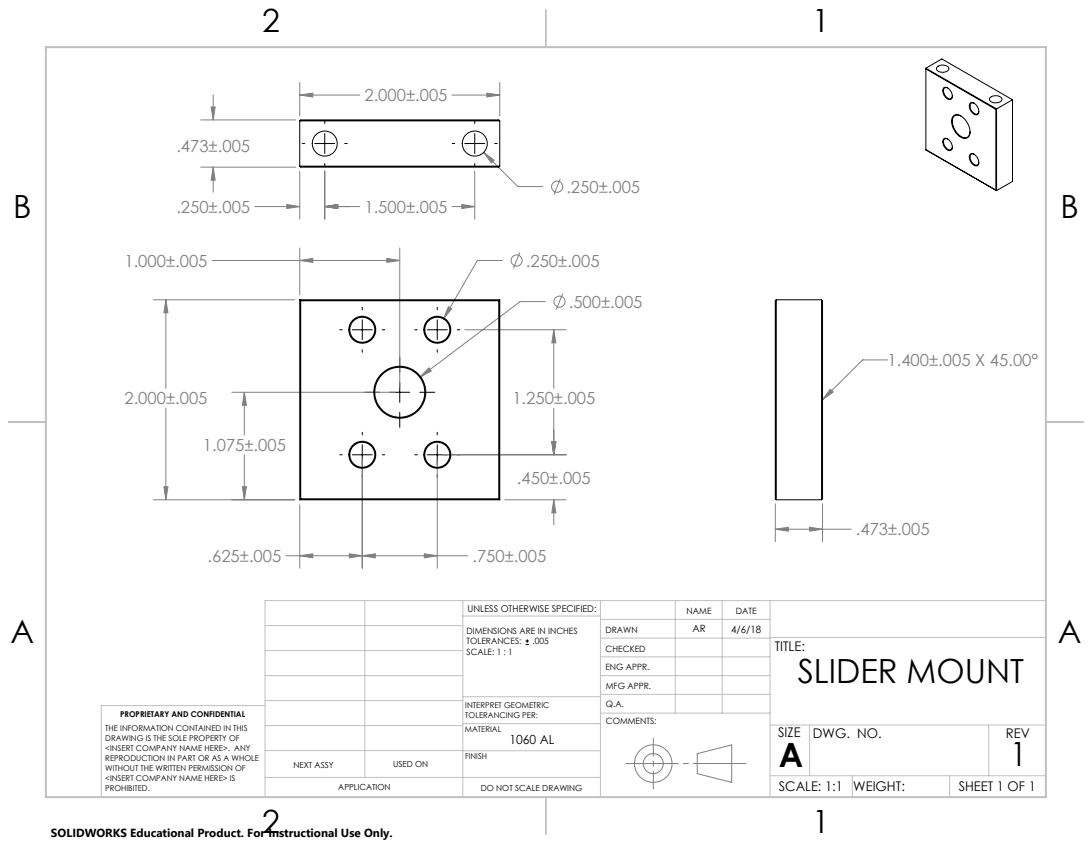
[picture p301: page 1]
DO NOT SCALE DRAWING; SHEET 1 OF 1; SCALE: 1:1; WEIGHT:

UNLESS OTHERWISE SPECIFIED: | | NAME | DATE
DIMENSIONS ARE IN INCHES TOLERANCES: .005 SCALE: 1 : 1 | DRAWN | AR | 4/6/18

CHECKED | | | TITLE: SLIDER MOUNT

ENG APPR.
MFG APPR.

INTERPRET GEOMETRIC TOLERANCING PER: | Q.A.
MATERIAL 1060 AL | | SIZE A | DWG. NO. | REV 1

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

COMMENTS:

NEXT ASSY | USED ON | FINISH

SOLIDWORKS Educational Product. For Instructional Use Only.
