andrewrichardr/MSE2202BDesignProject/Project/CAD/STM32 Vex Headers/board.brd

## EAGLE design Project/CAD/STM32 Vex Headers/board.brd (2018-03-15)

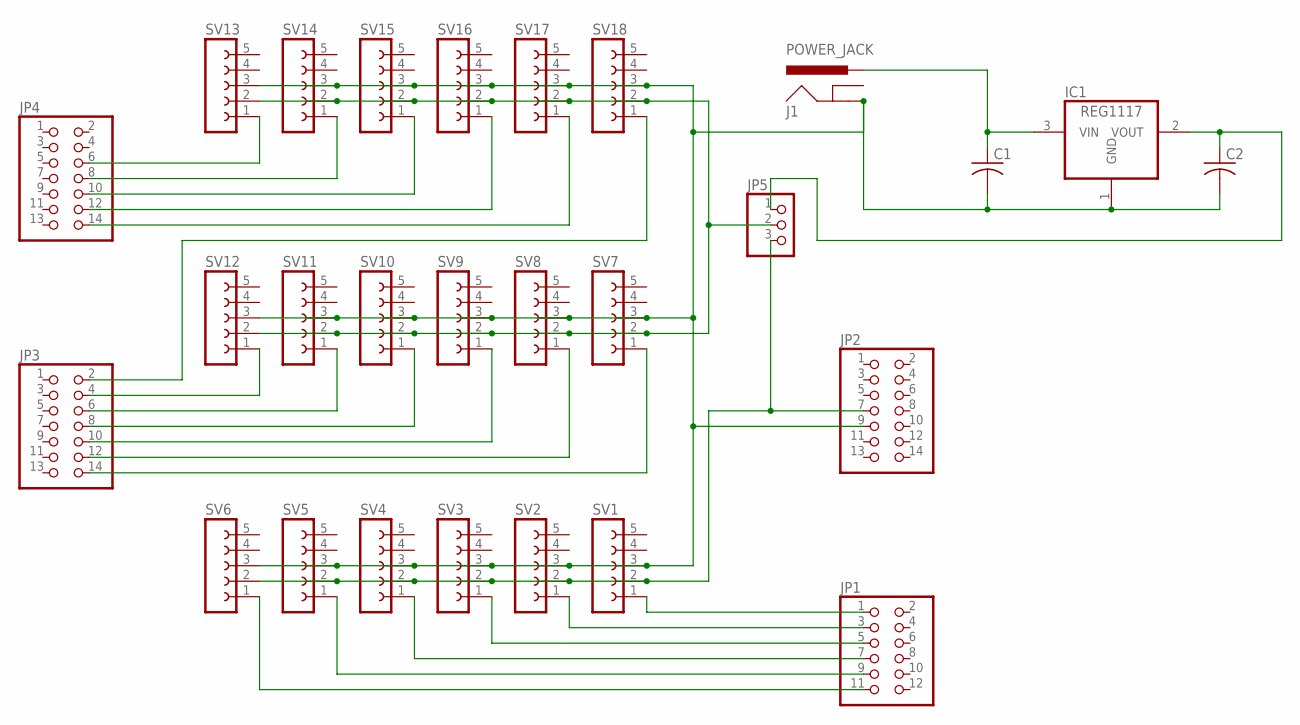
[picture p302: schematic board.sch]

Parts:
C1, C2: C-US025-024X044; C025-024X044
IC1: REG1117; SOT223
J1: POWER_JACK; POWER_JACK_PTH
JP1: PINHD-2X6; 2X06
JP2, JP3, JP4: PINHD-2X7; 2X07
JP5: PINHD-1X3; 1X03
SV1, SV2, SV3, SV4, SV5, SV6, SV7, SV8, SV9, SV10, SV11, SV12, SV13, SV14, SV15, SV16, SV17, SV18: FE05-1

Connections:
unnamed: JP1.1, SV1.1
unnamed: JP3.2, SV18.1
unnamed: JP1.3, SV2.1
unnamed: JP4.14, SV17.1
unnamed: JP1.5, SV3.1
unnamed: JP1.7, SV4.1
unnamed: JP1.9, SV5.1
unnamed: JP1.11, SV6.1
unnamed: JP3.14, SV7.1
unnamed: JP3.12, SV8.1
unnamed: JP3.10, SV9.1
unnamed: JP3.8, SV10.1
unnamed: JP3.6, SV11.1
unnamed: JP3.4, SV12.1
unnamed: JP4.12, SV16.1
unnamed: JP4.10, SV15.1
unnamed: C1.2, C2.2, IC1.1 (GND), J1.GND, JP2.9, SV1.3, SV2.3, SV3.3, SV4.3, SV5.3, SV6.3, SV7.3, SV8.3, SV9.3, SV10.3, SV11.3, SV12.3, SV13.3, SV14.3, SV15.3, SV16.3, SV17.3, SV18.3
unnamed: JP5.2, SV7.2, SV8.2, SV9.2, SV10.2, SV11.2, SV12.2, SV13.2, SV14.2, SV15.2, SV16.2, SV17.2, SV18.2
unnamed: JP4.8, SV14.1
unnamed: JP4.6, SV13.1
unnamed: C1.1, IC1.3 (VIN), J1.PWR
unnamed: JP2.7, JP5.3, SV1.2, SV2.2, SV3.2, SV4.2, SV5.2, SV6.2
unnamed: C2.1, IC1.2 (VOUT), JP5.1

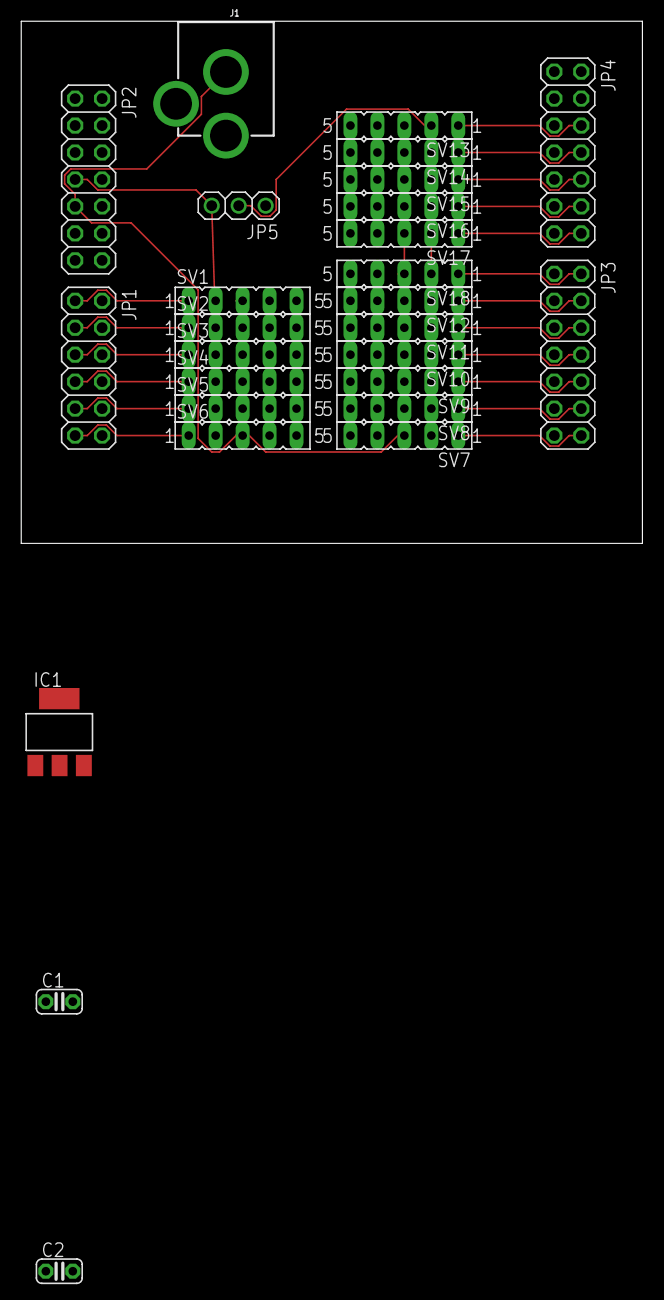
[picture p303: board board.brd from above]

Board: 2 copper layers, 58.5 x 49.2 mm, 27 parts (0 on the bottom side), 23 nets.
