andrewrichardr/MSE2202BDesignProject/Depreciated/Lab03/MSEBot_base/MSEBot_base.ino

/*

 MSE 2202 MSEBot base code for Labs 3 and 4
 Language: Arduino
 Authors: Michael Naish and Eugen Porter
 Date: 16/01/17
 
 Rev 1 - Initial version
 Rev 2 - Update for MSEduino v. 2
 
 */

#include <Servo.h>
#include <EEPROM.h>
#include <uSTimer2.h>
#include <CharliePlexM.h>
#include <Wire.h>
#include <I2CEncoder.h>

Servo servo_RightMotor;
Servo servo_LeftMotor;
Servo servo_ArmMotor;    
Servo servo_GripMotor;

I2CEncoder encoder_RightMotor;
I2CEncoder encoder_LeftMotor;

// Uncomment keywords to enable debugging output

//#define DEBUG_MODE_DISPLAY
//#define DEBUG_MOTORS
//#define DEBUG_LINE_TRACKERS
//#define DEBUG_ENCODERS
//#define DEBUG_ULTRASONIC
//#define DEBUG_LINE_TRACKER_CALIBRATION
//#define DEBUG_MOTOR_CALIBRATION

boolean deadEnd = false;
unsigned int deadFwd = 0;
unsigned int deadRev = 0;
unsigned int deadEndCount = 0;
unsigned int deadEndReset = 0;
unsigned int deadEndTimeout = 0;

boolean bt_Motors_Enabled = true;

unsigned long startTime = 0;
unsigned long currentTime = 0;
unsigned long totalDist = 0;

//port pin constants
const int ci_Ultrasonic_Ping = 2;   //input plug
const int ci_Ultrasonic_Data = 3;   //output plug
const int ci_Charlieplex_LED1 = 4;
const int ci_Charlieplex_LED2 = 5;
const int ci_Charlieplex_LED3 = 6;
const int ci_Charlieplex_LED4 = 7;
const int ci_Mode_Button = 7;
const int ci_Right_Motor = 8;
const int ci_Left_Motor = 9;
const int ci_Arm_Motor = 10;
const int ci_Grip_Motor = 11;
const int ci_Motor_Enable_Switch = 12;
const int ci_Right_Line_Tracker = A0;
const int ci_Middle_Line_Tracker = A1;
const int ci_Left_Line_Tracker = A2;
const int ci_Light_Sensor = A3;
const int ci_I2C_SDA = A4;         // I2C data = white
const int ci_I2C_SCL = A5;         // I2C clock = yellow

// Charlieplexing LED assignments
const int ci_Heartbeat_LED = 1;
const int ci_Indicator_LED = 4;
const int ci_Right_Line_Tracker_LED = 6;
const int ci_Middle_Line_Tracker_LED = 9;
const int ci_Left_Line_Tracker_LED = 12;

//constants

int phase = 1;

// EEPROM addresses
const int ci_Left_Line_Tracker_Dark_Address_L = 0;
const int ci_Left_Line_Tracker_Dark_Address_H = 1;
const int ci_Left_Line_Tracker_Light_Address_L = 2;
const int ci_Left_Line_Tracker_Light_Address_H = 3;
const int ci_Middle_Line_Tracker_Dark_Address_L = 4;
const int ci_Middle_Line_Tracker_Dark_Address_H = 5;
const int ci_Middle_Line_Tracker_Light_Address_L = 6;
const int ci_Middle_Line_Tracker_Light_Address_H = 7;
const int ci_Right_Line_Tracker_Dark_Address_L = 8;
const int ci_Right_Line_Tracker_Dark_Address_H = 9;
const int ci_Right_Line_Tracker_Light_Address_L = 10;
const int ci_Right_Line_Tracker_Light_Address_H = 11;
const int ci_Left_Motor_Offset_Address_L = 12;
const int ci_Left_Motor_Offset_Address_H = 13;
const int ci_Right_Motor_Offset_Address_L = 14;
const int ci_Right_Motor_Offset_Address_H = 15;

const int ci_Left_Motor_Stop = 1500;        // 200 for brake mode; 1500 for stop
const int ci_Right_Motor_Stop = 1500;
const int ci_Grip_Motor_Open = 140;         // Experiment to determine appropriate value
const int ci_Grip_Motor_Closed = 50;        //  "
const int ci_Arm_Servo_Retracted = 55;      //  "
const int ci_Arm_Servo_Extended = 120;      //  "
const int ci_Display_Time = 500;
const int ci_Line_Tracker_Calibration_Interval = 100;
const int ci_Line_Tracker_Cal_Measures = 20;
const int ci_Line_Tracker_Tolerance = 150;   // May need to adjust this
const int ci_Motor_Calibration_Cycles = 3;
const int ci_Motor_Calibration_Time = 5000;

//variables
byte b_LowByte;
byte b_HighByte;
unsigned long ul_Echo_Time;
unsigned int ui_Left_Line_Tracker_Data;
unsigned int ui_Middle_Line_Tracker_Data;
unsigned int ui_Right_Line_Tracker_Data;
unsigned int ui_Motors_Speed = 1800;        // Default run speed
unsigned int ui_Left_Motor_Speed;
unsigned int ui_Right_Motor_Speed;
long l_Left_Motor_Position;
long l_Right_Motor_Position;

unsigned long ul_3_Second_timer = 0;
unsigned long ul_Display_Time;
unsigned long ul_Calibration_Time;
unsigned long ui_Left_Motor_Offset;
unsigned long ui_Right_Motor_Offset;

unsigned int ui_Cal_Count;
unsigned int ui_Cal_Cycle;
unsigned int ui_Left_Line_Tracker_Dark;
unsigned int ui_Left_Line_Tracker_Light;
unsigned int ui_Middle_Line_Tracker_Dark;
unsigned int ui_Middle_Line_Tracker_Light;
unsigned int ui_Right_Line_Tracker_Dark;
unsigned int ui_Right_Line_Tracker_Light;
unsigned int ui_Line_Tracker_Tolerance;

unsigned int  ui_Robot_State_Index = 0;
//0123456789ABCDEF
unsigned int  ui_Mode_Indicator[6] = {
  0x00,    //B0000000000000000,  //Stop
  0x00FF,  //B0000000011111111,  //Run
  0x0F0F,  //B0000111100001111,  //Calibrate line tracker light level
  0x3333,  //B0011001100110011,  //Calibrate line tracker dark level
  0xAAAA,  //B1010101010101010,  //Calibrate motors
  0xFFFF   //B1111111111111111   //Unused
};

unsigned int  ui_Mode_Indicator_Index = 0;

//display Bits 0,1,2,3, 4, 5, 6,  7,  8,  9,  10,  11,  12,  13,   14,   15
int  iArray[16] = {
  1,2,4,8,16,32,64,128,256,512,1024,2048,4096,8192,16384,65536};
int  iArrayIndex = 0;

boolean bt_Heartbeat = true;
boolean bt_3_S_Time_Up = false;
boolean bt_Do_Once = false;
boolean bt_Cal_Initialized = false;

void setup() {
  Wire.begin();       // Wire library required for I2CEncoder library
  Serial.begin(9600);

  CharliePlexM::setBtn(ci_Charlieplex_LED1,ci_Charlieplex_LED2,
                       ci_Charlieplex_LED3,ci_Charlieplex_LED4,ci_Mode_Button);

  pinMode(3, OUTPUT);
  digitalWrite(3, HIGH);

  // set up ultrasonic
  pinMode(ci_Ultrasonic_Ping, OUTPUT);
  pinMode(ci_Ultrasonic_Data, INPUT);

  // set up drive motors
  pinMode(ci_Right_Motor, OUTPUT);
  servo_RightMotor.attach(ci_Right_Motor);
  pinMode(ci_Left_Motor, OUTPUT);
  servo_LeftMotor.attach(ci_Left_Motor);

  // set up arm motors
  pinMode(ci_Arm_Motor, OUTPUT);
  servo_ArmMotor.attach(ci_Arm_Motor);
  pinMode(ci_Grip_Motor, OUTPUT);
  servo_GripMotor.attach(ci_Grip_Motor);

  // set up motor enable switch
  pinMode(ci_Motor_Enable_Switch, INPUT);

  // set up encoders. Must be initialized in order that they are chained together, 
  // starting with the encoder directly connected to the Arduino. See I2CEncoder docs
  // for more information
  encoder_LeftMotor.init(1.0/3.0*MOTOR_393_SPEED_ROTATIONS, MOTOR_393_TIME_DELTA);
  encoder_LeftMotor.setReversed(false);  // adjust for positive count when moving forward
  encoder_RightMotor.init(1.0/3.0*MOTOR_393_SPEED_ROTATIONS, MOTOR_393_TIME_DELTA);  
  encoder_RightMotor.setReversed(true);  // adjust for positive count when moving forward

  // set up line tracking sensors
  pinMode(ci_Right_Line_Tracker, INPUT);
  pinMode(ci_Middle_Line_Tracker, INPUT);
  pinMode(ci_Left_Line_Tracker, INPUT);
  ui_Line_Tracker_Tolerance = ci_Line_Tracker_Tolerance;

  // read saved values from EEPROM
  b_LowByte = EEPROM.read(ci_Left_Line_Tracker_Dark_Address_L);
  b_HighByte = EEPROM.read(ci_Left_Line_Tracker_Dark_Address_H);
  ui_Left_Line_Tracker_Dark = word(b_HighByte, b_LowByte);
  b_LowByte = EEPROM.read(ci_Left_Line_Tracker_Light_Address_L);
  b_HighByte = EEPROM.read(ci_Left_Line_Tracker_Dark_Address_H);
  ui_Left_Line_Tracker_Light = word(b_HighByte, b_LowByte);
  b_LowByte = EEPROM.read(ci_Middle_Line_Tracker_Dark_Address_L);
  b_HighByte = EEPROM.read(ci_Left_Line_Tracker_Dark_Address_H);
  ui_Middle_Line_Tracker_Dark = word(b_HighByte, b_LowByte); 
  b_LowByte = EEPROM.read(ci_Middle_Line_Tracker_Light_Address_L);
  b_HighByte = EEPROM.read(ci_Left_Line_Tracker_Dark_Address_H);
  ui_Middle_Line_Tracker_Light = word(b_HighByte, b_LowByte);
  b_LowByte = EEPROM.read(ci_Right_Line_Tracker_Dark_Address_L);
  b_HighByte = EEPROM.read(ci_Left_Line_Tracker_Dark_Address_H);
  ui_Right_Line_Tracker_Dark = word(b_HighByte, b_LowByte);
  b_LowByte = EEPROM.read(ci_Right_Line_Tracker_Light_Address_L);
  b_HighByte = EEPROM.read(ci_Left_Line_Tracker_Dark_Address_H);
  ui_Right_Line_Tracker_Light = word(b_HighByte, b_LowByte);
  b_LowByte = EEPROM.read(ci_Left_Motor_Offset_Address_L);
  b_HighByte = EEPROM.read(ci_Left_Motor_Offset_Address_H);
  ui_Left_Motor_Offset = word(b_HighByte, b_LowByte);
  b_LowByte = EEPROM.read(ci_Right_Motor_Offset_Address_L);
  b_HighByte = EEPROM.read(ci_Right_Motor_Offset_Address_H);
  ui_Right_Motor_Offset = word(b_HighByte, b_LowByte);
}

int run = 1;
boolean hasFlag = 0;
boolean crossedCrack = 0;
unsigned int flagTime;
unsigned int currMillis;

void loop()
{
  if((millis() - ul_3_Second_timer) > 10)
  {
    bt_3_S_Time_Up = true;
  }

  // button-based mode selection
  if(CharliePlexM::ui_Btn)
  {
    if(bt_Do_Once == false)
    {
      bt_Do_Once = true;
      ui_Robot_State_Index++;
      ui_Robot_State_Index = ui_Robot_State_Index & 7;
      ul_3_Second_timer = millis();
      bt_3_S_Time_Up = false;
      bt_Cal_Initialized = false;
      ui_Cal_Cycle = 0;
    }
  }
  else
  {
    bt_Do_Once = LOW;
  }

  // check if drive motors should be powered
  bt_Motors_Enabled = digitalRead(ci_Motor_Enable_Switch);

  // modes 
  // 0 = default after power up/reset
  // 1 = Press mode button once to enter. Run robot.
  // 2 = Press mode button twice to enter. Calibrate line tracker light level.
  // 3 = Press mode button three times to enter. Calibrate line tracker dark level.
  // 4 = Press mode button four times to enter. Calibrate motor speeds to drive straight.
  switch(ui_Robot_State_Index)
  {
    case 0:    //Robot stopped
    {
      readLineTrackers();
      Ping();
      servo_LeftMotor.writeMicroseconds(ci_Left_Motor_Stop); 
      servo_RightMotor.writeMicroseconds(ci_Right_Motor_Stop); 
      servo_ArmMotor.write(ci_Arm_Servo_Retracted);
      servo_GripMotor.write(ci_Grip_Motor_Closed);
      encoder_LeftMotor.zero();
      encoder_RightMotor.zero();
      ui_Mode_Indicator_Index = 0;
      totalDist = 0;
      Serial.print("Ultrasonic: ");
      Serial.println(ul_Echo_Time/58);
      startTime = millis();
      break;
    } 
  
    case 1:    //Robot Run after 3 seconds
    {
      if(bt_3_S_Time_Up)
      {
        readLineTrackers();

#ifdef DEBUG_ENCODERS           
        l_Left_Motor_Position = encoder_LeftMotor.getRawPosition();
        l_Right_Motor_Position = encoder_RightMotor.getRawPosition();

        Serial.print("Encoders L: ");
        Serial.print(l_Left_Motor_Position);
        Serial.print(", R: ");
        Serial.println(l_Right_Motor_Position);
#endif

       // set motor speeds
        ui_Left_Motor_Speed = constrain(ui_Motors_Speed + ui_Left_Motor_Offset, 1600, 2100);
        ui_Right_Motor_Speed = constrain(ui_Motors_Speed + ui_Right_Motor_Offset, 1600, 2100);

       /***************************************************************************************
         Add line tracking code here. 
         Adjust motor speed according to information from line tracking sensors and 
         possibly encoder counts.
       /*************************************************************************************/

          if(millis() - deadEndReset > 2000) {
            deadEnd = false;
          }

          currMillis = millis();

          followLogic(1);

          Ping();



          if(ul_Echo_Time/58 < 4 && ul_Echo_Time/58 != 0 && hasFlag == 0&& 1 == 0) {
            //scanFlag();

            goStop();

            openGrip();
            extendArm();
            closeGrip();
            retractArm();

            turnAround();

            hasFlag = 1; //check if flag is held via IR sensor
            flagTime = millis()/1000;

          }

          if(deadEnd){
            servo_LeftMotor.writeMicroseconds(1700);
            servo_RightMotor.writeMicroseconds(1675);
            Serial.println("DeadEnd Crossed");
            delay(1000);
            deadEnd = false;
            crossedCrack = 1;
            deadEndCount = 0;
          }

          if(ul_Echo_Time/58 < 4 && ul_Echo_Time/58 != 0 && hasFlag == 1 && crossedCrack == 1 && 1 == 0) {
            //scanFlag();

            goStop();

            extendArm();
            openGrip();
            retractArm();

            while(1) goStop();

          }          





































        //Serial.print("deadEnd: ");
        //Serial.println(deadEnd);

        //if(bt_Motors_Enabled)
        //{
        //  servo_LeftMotor.writeMicroseconds(ui_Left_Motor_Speed);
        //  servo_RightMotor.writeMicroseconds(ui_Right_Motor_Speed);
        //}
        //else
        //{  
        //  servo_LeftMotor.writeMicroseconds(ci_Left_Motor_Stop); 
        //  servo_RightMotor.writeMicroseconds(ci_Right_Motor_Stop); 
        //}
#ifdef DEBUG_MOTORS
        Serial.print("Motors enabled: ");
        Serial.print(bt_Motors_Enabled);
        Serial.print(", Default: ");
        Serial.print(ui_Motors_Speed);
        Serial.print(", Left = ");
        Serial.print(ui_Left_Motor_Speed);
        Serial.print(", Right = ");
        Serial.println(ui_Right_Motor_Speed);
#endif    
        ui_Mode_Indicator_Index = 1;
      }
      break;
    } 
    
    case 2:    //Calibrate line tracker light levels after 3 seconds
    {

      if(bt_3_S_Time_Up)
      {
        if(!bt_Cal_Initialized)
        {
          bt_Cal_Initialized = true;
          ui_Left_Line_Tracker_Light = 0;
          ui_Middle_Line_Tracker_Light = 0;
          ui_Right_Line_Tracker_Light = 0;
          ul_Calibration_Time = millis();
          ui_Cal_Count = 0;
        }
        else if((millis() - ul_Calibration_Time) > ci_Line_Tracker_Calibration_Interval)
        {
          ul_Calibration_Time = millis();
          readLineTrackers();
          ui_Left_Line_Tracker_Light += ui_Left_Line_Tracker_Data;
          ui_Middle_Line_Tracker_Light += ui_Middle_Line_Tracker_Data;
          ui_Right_Line_Tracker_Light += ui_Right_Line_Tracker_Data;
          ui_Cal_Count++;
        }
        if(ui_Cal_Count == ci_Line_Tracker_Cal_Measures)
        {
          ui_Left_Line_Tracker_Light /= ci_Line_Tracker_Cal_Measures;
          ui_Middle_Line_Tracker_Light /= ci_Line_Tracker_Cal_Measures;
          ui_Right_Line_Tracker_Light /= ci_Line_Tracker_Cal_Measures;
#ifdef DEBUG_LINE_TRACKER_CALIBRATION
          Serial.print("Light Levels: Left = ");
          Serial.print(ui_Left_Line_Tracker_Light,DEC);
          Serial.print(", Middle = ");
          Serial.print(ui_Middle_Line_Tracker_Light,DEC);
          Serial.print(", Right = ");
          Serial.println(ui_Right_Line_Tracker_Light,DEC);
#endif           
          EEPROM.write(ci_Left_Line_Tracker_Light_Address_L, lowByte(ui_Left_Line_Tracker_Light));
          EEPROM.write(ci_Left_Line_Tracker_Light_Address_H, highByte(ui_Left_Line_Tracker_Light));
          EEPROM.write(ci_Middle_Line_Tracker_Light_Address_L, lowByte(ui_Middle_Line_Tracker_Light));
          EEPROM.write(ci_Middle_Line_Tracker_Light_Address_H, highByte(ui_Middle_Line_Tracker_Light));
          EEPROM.write(ci_Right_Line_Tracker_Light_Address_L, lowByte(ui_Right_Line_Tracker_Light));
          EEPROM.write(ci_Right_Line_Tracker_Light_Address_H, highByte(ui_Right_Line_Tracker_Light));
          ui_Robot_State_Index = 0;    // go back to Mode 0
        }
        ui_Mode_Indicator_Index = 2; 
      }
      break;


    }
    
    case 3:    // Calibrate line tracker dark levels after 3 seconds
    {
      if(bt_3_S_Time_Up)
      {
        if(!bt_Cal_Initialized)
        {
          bt_Cal_Initialized = true;
          ui_Left_Line_Tracker_Dark = 0;
          ui_Middle_Line_Tracker_Dark = 0;
          ui_Right_Line_Tracker_Dark = 0;
          ul_Calibration_Time = millis();
          ui_Cal_Count = 0;
        }
        else if((millis() - ul_Calibration_Time) > ci_Line_Tracker_Calibration_Interval)
        {
          ul_Calibration_Time = millis();
          readLineTrackers();
          ui_Left_Line_Tracker_Dark += ui_Left_Line_Tracker_Data;
          ui_Middle_Line_Tracker_Dark += ui_Middle_Line_Tracker_Data;
          ui_Right_Line_Tracker_Dark += ui_Right_Line_Tracker_Data;
          ui_Cal_Count++;
        }
        if(ui_Cal_Count == ci_Line_Tracker_Cal_Measures)
        {
          ui_Left_Line_Tracker_Dark /= ci_Line_Tracker_Cal_Measures;
          ui_Middle_Line_Tracker_Dark /= ci_Line_Tracker_Cal_Measures;
          ui_Right_Line_Tracker_Dark /= ci_Line_Tracker_Cal_Measures;
#ifdef DEBUG_LINE_TRACKER_CALIBRATION
          Serial.print("Dark Levels: Left = ");
          Serial.print(ui_Left_Line_Tracker_Dark,DEC);
          Serial.print(", Middle = ");
          Serial.print(ui_Middle_Line_Tracker_Dark,DEC);
          Serial.print(", Right = ");
          Serial.println(ui_Right_Line_Tracker_Dark,DEC);
#endif           
          EEPROM.write(ci_Left_Line_Tracker_Dark_Address_L, lowByte(ui_Left_Line_Tracker_Dark));
          EEPROM.write(ci_Left_Line_Tracker_Dark_Address_H, highByte(ui_Left_Line_Tracker_Dark));
          EEPROM.write(ci_Middle_Line_Tracker_Dark_Address_L, lowByte(ui_Middle_Line_Tracker_Dark));
          EEPROM.write(ci_Middle_Line_Tracker_Dark_Address_H, highByte(ui_Middle_Line_Tracker_Dark));
          EEPROM.write(ci_Right_Line_Tracker_Dark_Address_L, lowByte(ui_Right_Line_Tracker_Dark));
          EEPROM.write(ci_Right_Line_Tracker_Dark_Address_H, highByte(ui_Right_Line_Tracker_Dark));
          ui_Robot_State_Index = 0;    // go back to Mode 0
        }
        ui_Mode_Indicator_Index = 3;
      }
      break;
    }
   
    case 4:    //Calibrate motor straightness after 3 seconds.
    {
      if(bt_3_S_Time_Up)
      {
        if(!bt_Cal_Initialized)
        {
          bt_Cal_Initialized = true;
          encoder_LeftMotor.zero();
          encoder_RightMotor.zero();
          ul_Calibration_Time = millis();
          servo_LeftMotor.writeMicroseconds(ui_Motors_Speed);
          servo_RightMotor.writeMicroseconds(ui_Motors_Speed);
        }
        else if((millis() - ul_Calibration_Time) > ci_Motor_Calibration_Time) 
        {
          servo_LeftMotor.writeMicroseconds(ci_Left_Motor_Stop); 
          servo_RightMotor.writeMicroseconds(ci_Right_Motor_Stop); 
          l_Left_Motor_Position = encoder_LeftMotor.getRawPosition();
          l_Right_Motor_Position = encoder_RightMotor.getRawPosition();
          if(l_Left_Motor_Position > l_Right_Motor_Position)
          {
           // May have to update this if different calibration time is used
            ui_Right_Motor_Offset = 0;
            ui_Left_Motor_Offset = (l_Left_Motor_Position - l_Right_Motor_Position) / 4;  
          }
          else
          {
           // May have to update this if different calibration time is used
            ui_Right_Motor_Offset = (l_Right_Motor_Position - l_Left_Motor_Position) / 4;
            ui_Left_Motor_Offset = 0;
          }
          
#ifdef DEBUG_MOTOR_CALIBRATION
          Serial.print("Motor Offsets: Left = ");
          Serial.print(ui_Left_Motor_Offset);
          Serial.print(", Right = ");
          Serial.println(ui_Right_Motor_Offset);
#endif              
          EEPROM.write(ci_Right_Motor_Offset_Address_L, lowByte(ui_Right_Motor_Offset));
          EEPROM.write(ci_Right_Motor_Offset_Address_H, highByte(ui_Right_Motor_Offset));
          EEPROM.write(ci_Left_Motor_Offset_Address_L, lowByte(ui_Left_Motor_Offset));
          EEPROM.write(ci_Left_Motor_Offset_Address_H, highByte(ui_Left_Motor_Offset));
          
          ui_Robot_State_Index = 0;    // go back to Mode 0 
        }
#ifdef DEBUG_MOTOR_CALIBRATION           
          Serial.print("Encoders L: ");
          Serial.print(encoder_LeftMotor.getRawPosition());
          Serial.print(", R: ");
          Serial.println(encoder_RightMotor.getRawPosition());
#endif        
        ui_Mode_Indicator_Index = 4;
      } 
      break;
    }    
  }

  if((millis() - ul_Display_Time) > ci_Display_Time)
  {
    ul_Display_Time = millis();

#ifdef DEBUG_MODE_DISPLAY  
    Serial.print("Mode: ");
    Serial.println(ui_Mode_Indicator[ui_Mode_Indicator_Index], DEC);
#endif
    bt_Heartbeat = !bt_Heartbeat;
    CharliePlexM::Write(ci_Heartbeat_LED, bt_Heartbeat);
    digitalWrite(13, bt_Heartbeat);
    Indicator();
  }
} 

// set mode indicator LED state
void Indicator()
{
  //display routine, if true turn on led
  CharliePlexM::Write(ci_Indicator_LED,!(ui_Mode_Indicator[ui_Mode_Indicator_Index] & 
                      (iArray[iArrayIndex])));
  iArrayIndex++;
  iArrayIndex = iArrayIndex & 15;
}

// read values from line trackers and update status of line tracker LEDs
void readLineTrackers()
{
  ui_Left_Line_Tracker_Data = analogRead(ci_Left_Line_Tracker);
  ui_Middle_Line_Tracker_Data = analogRead(ci_Middle_Line_Tracker);
  ui_Right_Line_Tracker_Data = analogRead(ci_Right_Line_Tracker);

  if(ui_Left_Line_Tracker_Data < (ui_Left_Line_Tracker_Dark - ui_Line_Tracker_Tolerance))
  {
    CharliePlexM::Write(ci_Left_Line_Tracker_LED, HIGH);
  }
  else
  { 
    CharliePlexM::Write(ci_Left_Line_Tracker_LED, LOW);
  }
  if(ui_Middle_Line_Tracker_Data < (ui_Middle_Line_Tracker_Dark - ui_Line_Tracker_Tolerance))
  {
    CharliePlexM::Write(ci_Middle_Line_Tracker_LED, HIGH);
  }
  else
  { 
    CharliePlexM::Write(ci_Middle_Line_Tracker_LED, LOW);
  }
  if(ui_Right_Line_Tracker_Data < (ui_Right_Line_Tracker_Dark - ui_Line_Tracker_Tolerance))
  {
    CharliePlexM::Write(ci_Right_Line_Tracker_LED, HIGH);
  }
  else
  { 
    CharliePlexM::Write(ci_Right_Line_Tracker_LED, LOW);
  }

#ifdef DEBUG_LINE_TRACKERS
  Serial.print("Trackers: Left = ");
  Serial.print(ui_Left_Line_Tracker_Data,DEC);
  Serial.print(", Middle = ");
  Serial.print(ui_Middle_Line_Tracker_Data,DEC);
  Serial.print(", Right = ");
  Serial.println(ui_Right_Line_Tracker_Data,DEC);
#endif

}

// measure distance to target using ultrasonic sensor  
void Ping()
{
  //Ping Ultrasonic
  //Send the Ultrasonic Range Finder a 10 microsecond pulse per tech spec
  digitalWrite(ci_Ultrasonic_Ping, HIGH);
  delayMicroseconds(10);  //The 10 microsecond pause where the pulse in "high"
  digitalWrite(ci_Ultrasonic_Ping, LOW);
  //use command pulseIn to listen to Ultrasonic_Data pin to record the
  //time that it takes from when the Pin goes HIGH until it goes LOW 
  ul_Echo_Time = pulseIn(ci_Ultrasonic_Data, HIGH, 10000);

  // Print Sensor Readings
#ifdef DEBUG_ULTRASONIC
  Serial.print("Time (microseconds): ");
  Serial.print(ul_Echo_Time, DEC);
  Serial.print(", Inches: ");
  Serial.print(ul_Echo_Time/148); //divide time by 148 to get distance in inches
  Serial.print(", cm: ");
  Serial.println(ul_Echo_Time/58); //divide time by 58 to get distance in cm 
#endif
}  


void deadEndDetect(boolean direction){
  if(direction == 1) deadFwd = millis();
  if(direction == 0) deadRev = millis();
  
  if(abs(deadFwd - deadRev) < 200) {
    deadEndCount++;
    deadEndTimeout = millis();
  } 
  
  if(deadEndCount > 25) {
    deadEnd = true;
    deadEndTimeout = 0;
    deadEndReset = millis();
  }
  else {
    deadEnd = false;
  }
}

int fwdSpeed = 1800;//1675;
int revSpeed = 1350;//1325;
int revSpeedturn = 1400;//1325;

void goForward() {
  //servo_LeftMotor.writeMicroseconds(ui_Left_Motor_Speed-speedOffset);
  //servo_RightMotor.writeMicroseconds(ui_Right_Motor_Speed-speedOffset);
  servo_LeftMotor.writeMicroseconds(fwdSpeed);
  servo_RightMotor.writeMicroseconds(fwdSpeed);
  deadEndDetect(1);


}

void goLeft() {
  //servo_LeftMotor.writeMicroseconds(ui_Left_Motor_Speed-speedOffset);
  //servo_RightMotor.writeMicroseconds(ci_Right_Motor_Stop);
  //servo_RightMotor.writeMicroseconds(ui_Right_Motor_Speed-500-speedOffset);
  servo_LeftMotor.writeMicroseconds(fwdSpeed);
  //servo_RightMotor.writeMicroseconds(ci_Right_Motor_Stop);
  servo_RightMotor.writeMicroseconds(revSpeedturn);
}

void goRight() {
  //servo_LeftMotor.writeMicroseconds(ci_Left_Motor_Stop);
  //servo_LeftMotor.writeMicroseconds(ui_Left_Motor_Speed-500-speedOffset);
  //servo_RightMotor.writeMicroseconds(ui_Right_Motor_Speed-speedOffset);
  servo_LeftMotor.writeMicroseconds(revSpeedturn);
  servo_RightMotor.writeMicroseconds(fwdSpeed);
}

void goStop() {
  servo_LeftMotor.writeMicroseconds(ci_Left_Motor_Stop);
  servo_RightMotor.writeMicroseconds(ci_Right_Motor_Stop);
}

void reverse() {
  //servo_LeftMotor.writeMicroseconds(ui_Left_Motor_Speed-500-speedOffset);
  //servo_RightMotor.writeMicroseconds(ui_Right_Motor_Speed-500-speedOffset);
  servo_LeftMotor.writeMicroseconds(revSpeed);
  servo_RightMotor.writeMicroseconds(revSpeed);
  deadEndDetect(0);

}

void openGrip(){
        for(int i = ci_Grip_Motor_Closed; i < ci_Grip_Motor_Open; )
      {
        servo_GripMotor.write(i);
        delay(10);
        i++;
      }
}

void closeGrip(){
        for(int i = ci_Grip_Motor_Open; i > ci_Grip_Motor_Closed; )
      {
        servo_GripMotor.write(i);
        delay(10);
        i--;
      }
}

void retractArm(){
        for(int i = ci_Arm_Servo_Extended; i > ci_Arm_Servo_Retracted; )
      {
        servo_ArmMotor.write(i);
        delay(10);
        i--;
      }
}

void extendArm(){
        for(int i = ci_Arm_Servo_Retracted; i < ci_Arm_Servo_Extended; )
      {
        servo_ArmMotor.write(i);
        delay(10);
        i++;
      }
}

void followLogic(short dir){
      if((ui_Left_Line_Tracker_Data < (ui_Left_Line_Tracker_Dark - ui_Line_Tracker_Tolerance))  //light
    && (ui_Middle_Line_Tracker_Data > (ui_Middle_Line_Tracker_Dark - ui_Line_Tracker_Tolerance))  //dark
    && (ui_Right_Line_Tracker_Data < (ui_Right_Line_Tracker_Dark - ui_Line_Tracker_Tolerance))) { //light
      //Go Forward
      goForward();
    }

    if((ui_Left_Line_Tracker_Data > (ui_Left_Line_Tracker_Dark - ui_Line_Tracker_Tolerance)) 
    && (ui_Middle_Line_Tracker_Data < (ui_Middle_Line_Tracker_Dark - ui_Line_Tracker_Tolerance)) 
    && (ui_Right_Line_Tracker_Data < (ui_Right_Line_Tracker_Dark - ui_Line_Tracker_Tolerance))) {
      //Go Left
      goLeft();
    }

    if((ui_Left_Line_Tracker_Data < (ui_Left_Line_Tracker_Dark - ui_Line_Tracker_Tolerance)) 
    && (ui_Middle_Line_Tracker_Data < (ui_Middle_Line_Tracker_Dark - ui_Line_Tracker_Tolerance)) 
    && (ui_Right_Line_Tracker_Data > (ui_Right_Line_Tracker_Dark - ui_Line_Tracker_Tolerance))) {
      //Go Right
      goRight();
    }

    if((ui_Left_Line_Tracker_Data < (ui_Left_Line_Tracker_Dark - ui_Line_Tracker_Tolerance)) 
    && (ui_Middle_Line_Tracker_Data < (ui_Middle_Line_Tracker_Dark - ui_Line_Tracker_Tolerance)) 
    && (ui_Right_Line_Tracker_Data < (ui_Right_Line_Tracker_Dark - ui_Line_Tracker_Tolerance))) {
    //Intersection -- default turn left
    //reverse();
      reverse();
    }

    if((ui_Left_Line_Tracker_Data > (ui_Left_Line_Tracker_Dark - ui_Line_Tracker_Tolerance)) 
    && (ui_Middle_Line_Tracker_Data > (ui_Middle_Line_Tracker_Dark - ui_Line_Tracker_Tolerance)) 
    && (ui_Right_Line_Tracker_Data > (ui_Right_Line_Tracker_Dark - ui_Line_Tracker_Tolerance))) {
    //Intersection -- default turn left
      if(dir == 1) goForward();
      if(dir == 2) goLeft();
      if(dir == 3) goRight();
      if(dir == 4) goStop();
    }
}

void turnAround(){
  servo_LeftMotor.writeMicroseconds(1200);
  servo_RightMotor.writeMicroseconds(1800);
  delay(1700);
  servo_LeftMotor.writeMicroseconds(ci_Left_Motor_Stop);
  servo_RightMotor.writeMicroseconds(ci_Right_Motor_Stop);

}
