andrewrichardr/MSE2202BDesignProject/Project/Code/_Prototype_Code/RetrieveCube/RetrieveCube.ino

#include <Wire.h>
#include <Adafruit_Sensor.h>
#include <Adafruit_LSM303.h>
#include <Servo.h>

Adafruit_LSM303 lsm;
Servo servo;

#define PIN D8

void setup() 
{
  pinMode(PIN, OUTPUT);
  servo.attach(PIN);
#ifndef ESP8266
  while (!Serial);     // will pause Zero, Leonardo, etc until serial console opens
#endif
  Serial.begin(9600);
  
  // Try to initialise and warn if we couldn't detect the chip
  if (!lsm.begin())
  {
    Serial.println("Oops ... unable to initialize the LSM303. Check your wiring!");
    while (1);
  }
    servo.write(65);
}

void loop() 
{
  int x, y, z;
  lsm.read();

  x = lsm.magData.x;
  y = lsm.magData.y;
  z = lsm.magData.z;

 int mag = sqrt(pow(x,2)+pow(y,2)+pow(z,2));
 Serial.print("  Magnitude: "); Serial.print(mag);
 Serial.print("  x: "); Serial.print(x);
 Serial.print("  y: "); Serial.print(y);
 Serial.print("  z: "); Serial.println(z);

 if(sqrt(pow(z,2)) > 4000){
  servo.write(105);
 } else{
  servo.write(65);
 }

}
