andrewrichardr/MSE2202BDesignProject/(commit log)

2018-01-23 I2CEncoder Lib added, Will compile with Sublime
2018-01-30 Added STM32 Guide
2018-02-15 Racing Edition
    [Part Sourcing.xlsx]
2018-03-14 SOLIDWORKS Init
    [276-1321-INST1.sldasm, 276-2177-003 Rev1.sldprt, 276-2177-004 Rev1.sldprt, 276-2177-005 Rev1.sldprt, 276-2177-006 Rev1.sldprt, 276-2177-009 Rev1.sldprt, 276-2177-010 Rev1.sldprt, 276-2177-011 Rev1.sldprt]
2018-03-14 Fan's Code
2018-03-15 Repo Cleanup, Added Eagle Sch for Vex Devices
    [Part Sourcing.xlsx, board.brd, board.sch]
2018-03-15 Fan's Docs
    [Decision-Matrix-Pyramid.xlsx, QFD-Extended.xlsx]
2018-03-15 Rev 1.0 Prototype Sch Added
    [Prototype Rev1.sch]
2018-03-15 Ultrasonic test code added for driving parallel to the wall
2018-03-16 Chassis Gearing Iteration
    [24-tooth-sprocket.SLDPRT, 6-tooth-sprocket.SLDPRT, ChainLink.SLDPRT, Rod.SLDPRT, sidebar.SLDPRT]
2018-03-16 Block Diagram Added
    [MEDIUM-WHEEL-TIRE.sldprt]
2018-03-18 Added IRQ line for the IR sensor
2018-03-18 File Structuring, Ultrasonic Code added for MSE-Duino-B, Main Code Development Started
2018-03-20 Modified variant.h to enable UART3
2018-03-20 Enabled all UARTx with included boards.txt
2018-03-20 Uarts enabled
2018-03-20 Product CAD update
    [ChassisPlatform.SLDPRT, Standoff2in.SLDPRT]
2018-03-20 Add files via upload
    Intake Parts (Laser Cutting version)
    [Bottom(Forklift).SLDPRT, back.SLDPRT, top.SLDPRT]
2018-03-22 CAD render + Updates
2018-03-22 IR sensor retrieval added
2018-03-23 Final Design CAD added and Chassis started
    [1327K113_MINIATURE 12L14 DRIVE STEEL SHAFT.SLDPRT, 24-tooth-sprocket.SLDPRT, 2737T131_FINISHED-BORE SPROCKET FOR ANSI ROLLER CHAIN.SLDPRT, 2737T200_FINISHED-BORE SPROCKET FOR ANSI ROLLER CHAIN.SLDPRT, 276-1321-INST1.sldasm, 276-2177-003 Rev1.sldprt, 276-2177-004 Rev1.sldprt, 276-2177-005 Rev1.sldprt]
2018-03-25 Repo Cleanup
    [1327K113_MINIATURE 12L14 DRIVE STEEL SHAFT.SLDPRT, 24-tooth-sprocket.SLDPRT, 2737T131_FINISHED-BORE SPROCKET FOR ANSI ROLLER CHAIN.SLDPRT, 2737T200_FINISHED-BORE SPROCKET FOR ANSI ROLLER CHAIN.SLDPRT, 276-1321-INST1.sldasm, 276-2177-003 Rev1.sldprt, 276-2177-004 Rev1.sldprt, 276-2177-005 Rev1.sldprt]
2018-03-25 NUCLEO-32 Ultrasonic Controller Code added
2018-03-25 FAN's code added back
2018-03-26 fan demo
2018-03-29 CAD and Sensor Test Code
    [MCUMount.SLDPRT, NUCLEO64Mount.SLDASM, NUCLEO64Mount.SLDPRT]
2018-04-01 Added PID controlled wall follower code to test
    [arm.SLDASM, hw1.SLDPRT, lkn6.SLDPRT, lnk1.SLDPRT, lnk2.SLDPRT, lnk3.SLDPRT, lnk4.SLDPRT, lnk5.SLDPRT]
2018-04-01 adds new Lift and Claw CAD parts
    [3 inch Linkage.SLDDRW, 3 inch Linkage.SLDPRT, 4.5in Inch Shaft Bar.SLDPRT, 5.5in Inch Shaft Bar.SLDPRT, 60 tooth gear.SLDPRT, BottomForklift.SLDPRT, Circles 3 inch Linkage.SLDPRT, Circles 3.5 inch Linkage.SLDPRT]
2018-04-02 should fix Solidworks opening issues
    [Pyramid Intake.SLDASM]
2018-04-02 Fans code: Added functions and vars for arm and lift positions, cleaned up repo
2018-04-03 last minute cad
    [Claw-Holder.SLDPRT]
2018-04-07 CADDING PROTOTYPE
    [BEAM-2000.SLDPRT, BEAM-3000.SLDPRT, BEAM-4000.SLDPRT, BEARING-FLAT.SLDPRT, BaseUC.SLDPRT, Claw-Holder.SLDDRW, Claw-Holder.SLDPRT, ControllerTray-NoMates.SLDASM]
2018-04-07 CAD progress
    [276-1926-001 Rev1.SLDPRT, 276-1926-002 Rev1.SLDPRT, 276-1926-004 Rev1.SLDPRT, 276-1926-005 Rev1.SLDPRT, BEAM-1500.SLDPRT, Claw-Bracket.SLDPRT, ClawAssy-NoMates.SLDASM, ClawAssy.SLDASM]
2018-04-08 prototype caD
    [Pyramid Intake.SLDASM, VEX-12-TOOTH-GEAR.SLDPRT, VEX-36-TOOTH-GEAR.SLDPRT, VEX-60-TOOTH-GEAR.SLDPRT, VL-CHAN-121-15 RevA.SLDPRT, ramp.SLDPRT]
2018-04-08 Prototype CAD Completed
    [276-1926-005 Rev1.SLDPRT, BaseUC.SLDPRT, Circles 3.5 inch Linkage-o.SLDPRT, Circles 3.5 inch Linkage.SLDPRT, Claw-Bracket.SLDPRT, ClawAssy-NoMates.SLDDRW, ControllerTray-NoMates.SLDASM, ControllerTray-NoMates.SLDDRW]
2018-04-09 Final Design CAD progress
    [60355K504_BALL BEARING.SLDPRT, 60355K509_BALL BEARING.SLDPRT, 93410A912_ASTM A193 STEEL ACME LEAD SCREW.SLDPRT, 93410A920_ASTM A193 STEEL ACME LEAD SCREW.SLDPRT, 95120A523_BRONZE GENERAL PURPOSE ACME FLANGE NUT.SLDPRT, 95120A592_BRONZE GENERAL PURPOSE ACME FLANGE NUT.SLDPRT, ArmRotate.SLDPRT, BOM.xlsx]
2018-04-10 Final Drawings
    [57545K511_SPEED-REDUCING WORM GEAR FOR 90 DEG TRANSFER-cutoff.SLDPRT, 57545K511_SPEED-REDUCING WORM GEAR FOR 90 DEG TRANSFER.SLDPRT, 57545K527_SPEED-REDUCING WORM GEAR FOR 90 DEG TRANSFER.SLDPRT, 6627T380_POSITION-CONTROL DC MOTOR.SLDPRT, 6627T530_POSITION-CONTROL DC MOTOR.SLDPRT, 6627T560_POSITION-CONTROL DC MOTOR.SLDPRT, 6627T650_POSITION-CONTROL DC MOTOR.SLDPRT, ArmRotate.SLDPRT]
2018-04-11 adding new CADded files
    [5.5in Inch Shaft Bar and Connector.SLDDRW, 5.5in Inch Shaft Bar.SLDDRW, 5.5in Inch Shaft Bar.SLDPRT, ABS Group 9.SLDDRW, Circles 3.5 inch Linkage.SLDPRT, Connector 3.5 inch Linkage.SLDDRW, Connector 3.5 inch Linkage.SLDPRT, back updated.SLDPRT]
